12voltman/SimulType/README.md

# SimulType
A collection of keyboard layouts and designs that emphasize data input through two handed use of the number pad with a keyboard or arrow keys
