12voltman/SimulType/Hardware/devtools/simultypecontrol/simultypecontrol.kicad_pcb

## KiCad design Hardware/devtools/simultypecontrol/simultypecontrol.kicad_pcb (2024-07-02)

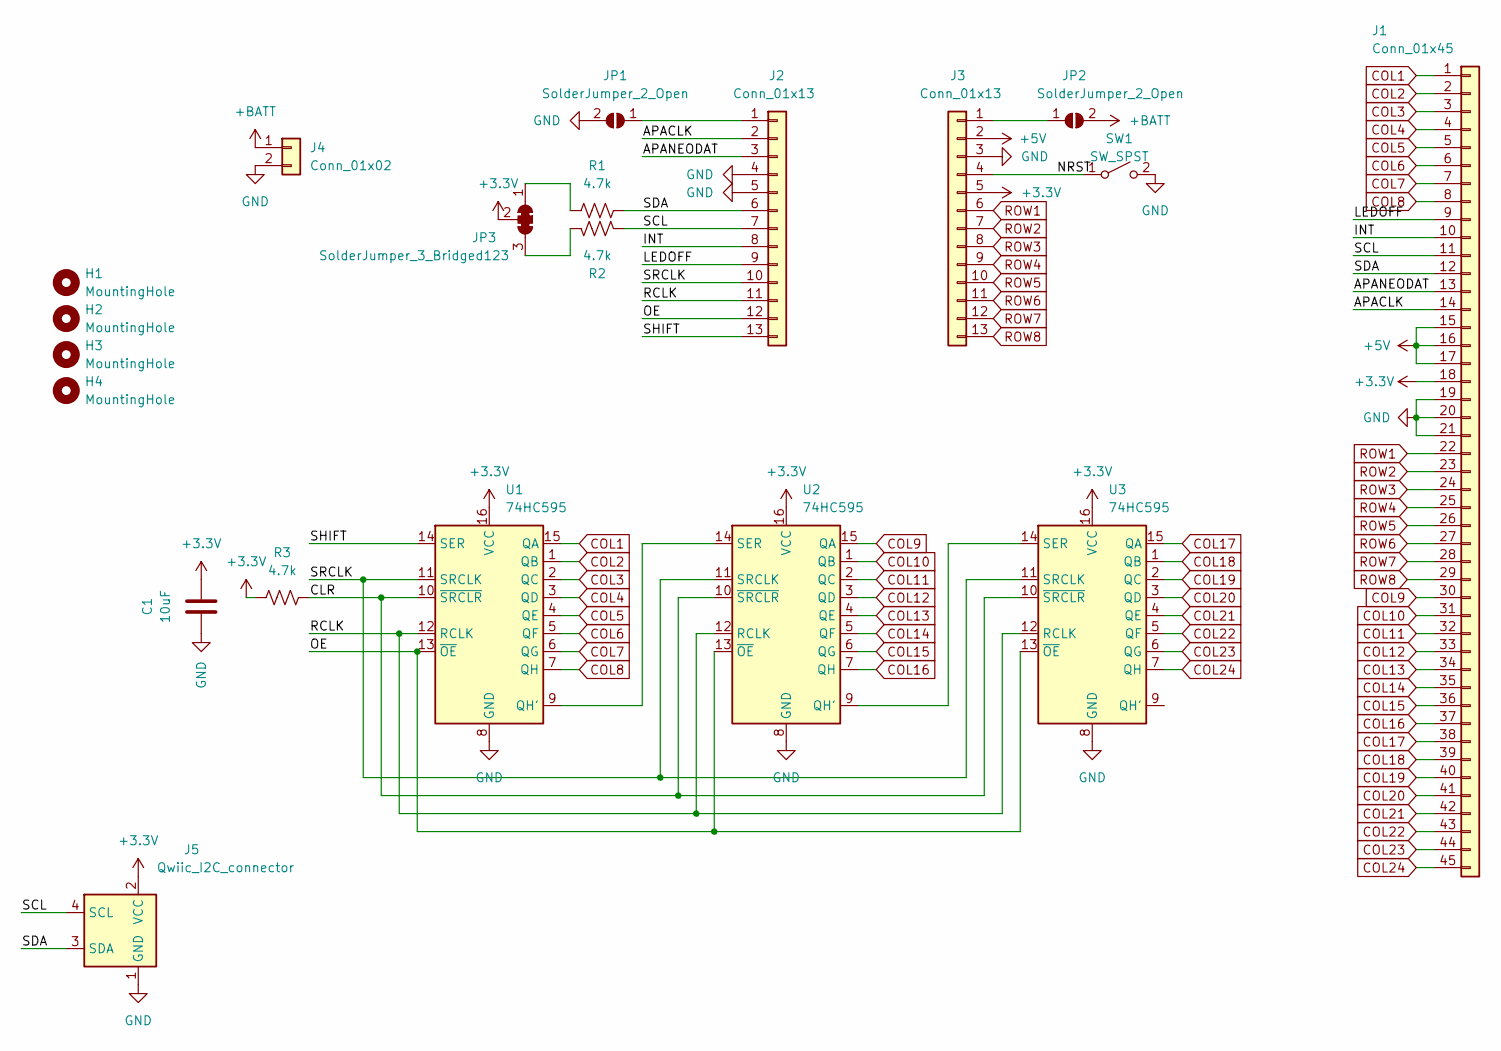
[picture p2: schematic simultypecontrol.kicad_sch]

Parts:
C1: 10uF; C_0805_2012Metric; LCSC C1713
H1, H2, H3, H4: MountingHole; breakoffm3hole
J1: Conn_01x45; TE_4-1734839-5_1x45-1MP_P0.5mm_Horizontal; LCSC C2998867
J2, J3: Conn_01x13; PinHeader_1x13_P2.54mm_Vertical; LCSC C2986992
J4: Conn_01x02; JST_PH_S2B-PH-K_1x02_P2.00mm_Horizontal; LCSC C49992
J5: Qwiic_I2C_connector; JST_SH_SM04B-SRSS-TB_1x04-1MP_P1.00mm_Horizontal; LCSC C7433425
JP1, JP2: SolderJumper_2_Open; SolderJumper-2_P1.3mm_Open_TrianglePad1.0x1.5mm
JP3: SolderJumper_3_Bridged123; SolderJumper-3_P1.3mm_Bridged123_RoundedPad1.0x1.5mm
R1, R2, R3: 4.7k; R_0603_1608Metric; LCSC C25999
SW1: SW_SPST; SW_PUSH_6mm; LCSC C5340136
U1, U2, U3: 74HC595; DHVQFN-16-1EP_2.5x3.5mm_P0.5mm_EP1x2mm; LCSC C730243

Connections:
+3.3V: C1.1, J1.18, J3.5, J5.2 (VCC), JP3.2 (C), R3.1, U1.16 (VCC), U2.16 (VCC), U3.16 (VCC)
+5V: J1.15, J1.16, J1.17, J3.2
+BATT: J4.1, JP2.2 (B)
/APACLK: J1.14, J2.2
/APANEODAT: J1.13, J2.3
/CLR: R3.2, U1.10 (~SRCLR), U2.10 (~SRCLR), U3.10 (~SRCLR)
/INT: J1.10, J2.8
/LEDOFF: J1.9, J2.9
/NRST: J3.4, SW1.1 (A)
/OE: J2.12, U1.13 (~OE), U2.13 (~OE), U3.13 (~OE)
/RCLK: J2.11, U1.12 (RCLK), U2.12 (RCLK), U3.12 (RCLK)
/SCL: J1.11, J2.7, J5.4 (SCL), R2.2
/SDA: J1.12, J2.6, J5.3 (SDA), R1.2
/SHIFT: J2.13, U1.14 (SER)
/SRCLK: J2.10, U1.11 (SRCLK), U2.11 (SRCLK), U3.11 (SRCLK)
COL1: J1.1, U1.15 (QA)
COL2: J1.2, U1.1 (QB)
COL3: J1.3, U1.2 (QC)
COL4: J1.4, U1.3 (QD)
COL5: J1.5, U1.4 (QE)
COL6: J1.6, U1.5 (QF)
COL7: J1.7, U1.6 (QG)
COL8: J1.8, U1.7 (QH)
COL9: J1.30, U2.15 (QA)
COL10: J1.31, U2.1 (QB)
COL11: J1.32, U2.2 (QC)
COL12: J1.33, U2.3 (QD)
COL13: J1.34, U2.4 (QE)
COL14: J1.35, U2.5 (QF)
COL15: J1.36, U2.6 (QG)
COL16: J1.37, U2.7 (QH)
COL17: J1.38, U3.15 (QA)
COL18: J1.39, U3.1 (QB)
COL19: J1.40, U3.2 (QC)
COL20: J1.41, U3.3 (QD)
COL21: J1.42, U3.4 (QE)
COL22: J1.43, U3.5 (QF)
COL23: J1.44, U3.6 (QG)
COL24: J1.45, U3.7 (QH)
GND: C1.2, J1.19, J1.20, J1.21, J2.4, J2.5, J3.3, J4.2, J5.1 (GND), J5.MP (VSS), JP1.2 (B), SW1.2 (B), U1.8 (GND), U2.8 (GND), U3.8 (GND)
unnamed: J2.1, JP1.1 (A)
unnamed: J3.1, JP2.1 (A)
unnamed: JP3.1 (A), R1.1
unnamed: JP3.3 (B), R2.1
unnamed: U1.9 (QH'), U2.14 (SER)
unnamed: U2.9 (QH'), U3.14 (SER)
ROW1: J1.22, J3.6
ROW2: J1.23, J3.7
ROW3: J1.24, J3.8
ROW4: J1.25, J3.9
ROW5: J1.26, J3.10
ROW6: J1.27, J3.11
ROW7: J1.28, J3.12
ROW8: J1.29, J3.13

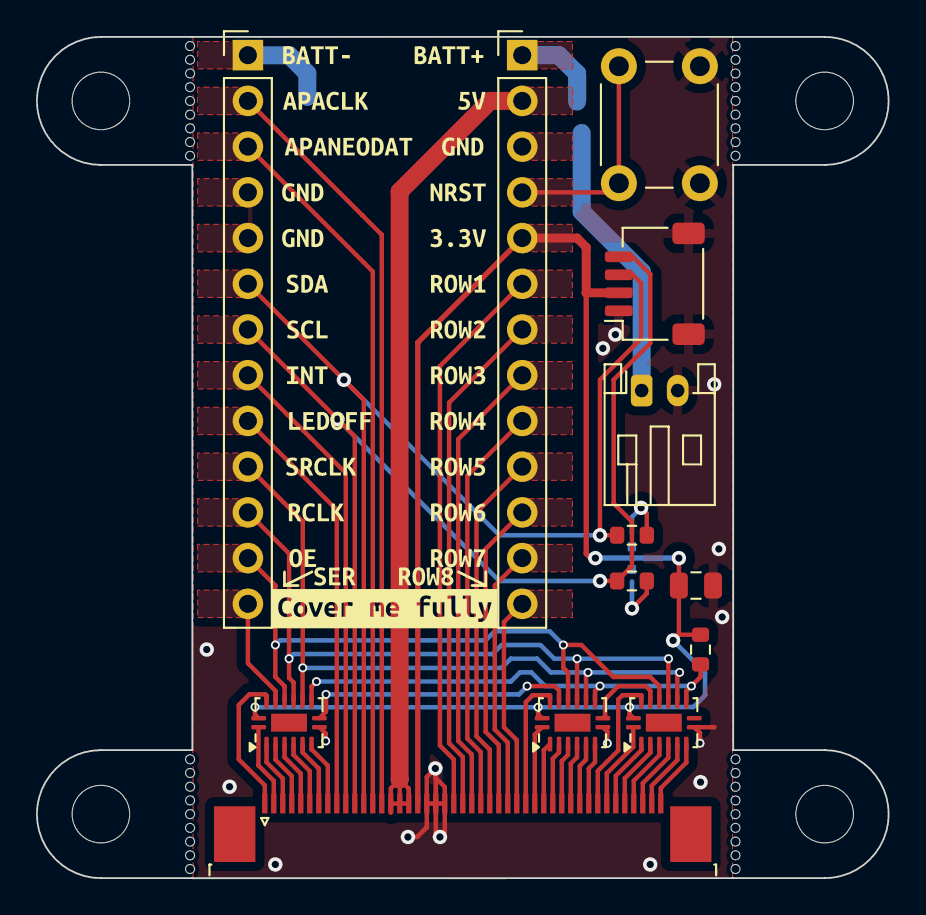
[picture p3: board simultypecontrol.kicad_pcb from above]

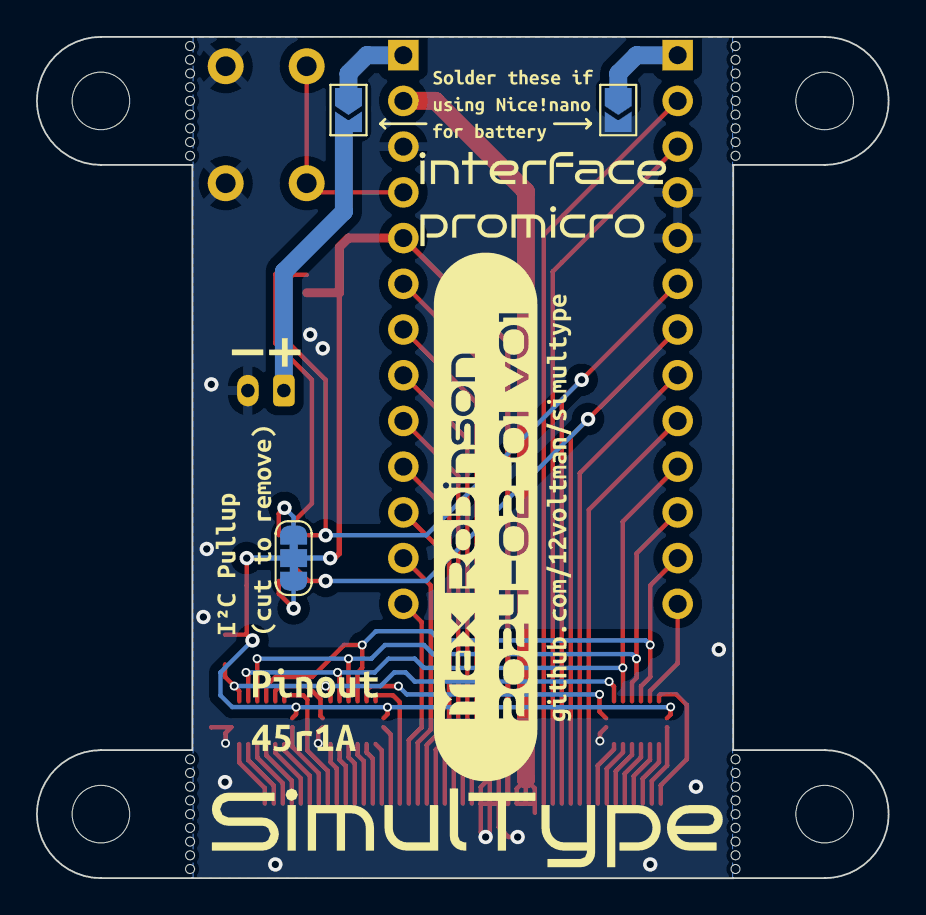
[picture p4: board simultypecontrol.kicad_pcb from below]

Board: 2 copper layers, 47.3 x 46.7 mm, 55 parts (11 on the bottom side), 54 nets.

Other parts of the board:
kibuzzard-65BDD6E5: G***; kibuzzard-65BDD6E5
kibuzzard-65BDD7EC: G***; kibuzzard-65BDD7EC
kibuzzard-65BDD62B: G***; kibuzzard-65BDD62B
kibuzzard-65BDD75E: G***; kibuzzard-65BDD75E
kibuzzard-65BDD614: G***; kibuzzard-65BDD614
kibuzzard-65BDD880: G***; kibuzzard-65BDD880
kibuzzard-65BE09D0: G***; kibuzzard-65BE09D0
kibuzzard-65BE0934: G***; kibuzzard-65BE0934
kibuzzard-65BEF9A5: G***; kibuzzard-65BEF9A5
kibuzzard-65BEF9C3: G***; kibuzzard-65BEF9C3
kibuzzard-65BEF9CF: G***; kibuzzard-65BEF9CF
kibuzzard-65BEF9D6: G***; kibuzzard-65BEF9D6
kibuzzard-65BEF9DC: G***; kibuzzard-65BEF9DC
kibuzzard-65BEF9E1: G***; kibuzzard-65BEF9E1
kibuzzard-65BEF9E8: G***; kibuzzard-65BEF9E8
kibuzzard-65BEF9F0: G***; kibuzzard-65BEF9F0
kibuzzard-65BEF9FD: G***; kibuzzard-65BEF9FD
kibuzzard-65BEF941: G***; kibuzzard-65BEF941
kibuzzard-65BEFA0F: G***; kibuzzard-65BEFA0F
kibuzzard-65BEFA1D: G***; kibuzzard-65BEFA1D
kibuzzard-65BEFA03: G***; kibuzzard-65BEFA03
kibuzzard-65BEFA3D: G***; kibuzzard-65BEFA3D
kibuzzard-65BEFA6D: G***; kibuzzard-65BEFA6D
kibuzzard-65BEFA08: G***; kibuzzard-65BEFA08
kibuzzard-65BEFA17: G***; kibuzzard-65BEFA17
kibuzzard-65BEFA24: G***; kibuzzard-65BEFA24
kibuzzard-65BEFA30: G***; kibuzzard-65BEFA30
kibuzzard-65BEFA36: G***; kibuzzard-65BEFA36
kibuzzard-65BEFA42: G***; kibuzzard-65BEFA42
kibuzzard-65BEFA48: G***; kibuzzard-65BEFA48
kibuzzard-65BEFA57: G***; kibuzzard-65BEFA57
kibuzzard-65BEFA60: G***; kibuzzard-65BEFA60
kibuzzard-65BEFA66: G***; kibuzzard-65BEFA66
kibuzzard-65C29BCC: G***; kibuzzard-65C29BCC
kibuzzard-65C25006: G***; kibuzzard-65C25006
