12voltman/SimulType/Hardware/devtools/simultypeprog/simultypeprog.kicad_pcb

## KiCad design Hardware/devtools/simultypeprog/simultypeprog.kicad_pcb (2024-07-02)

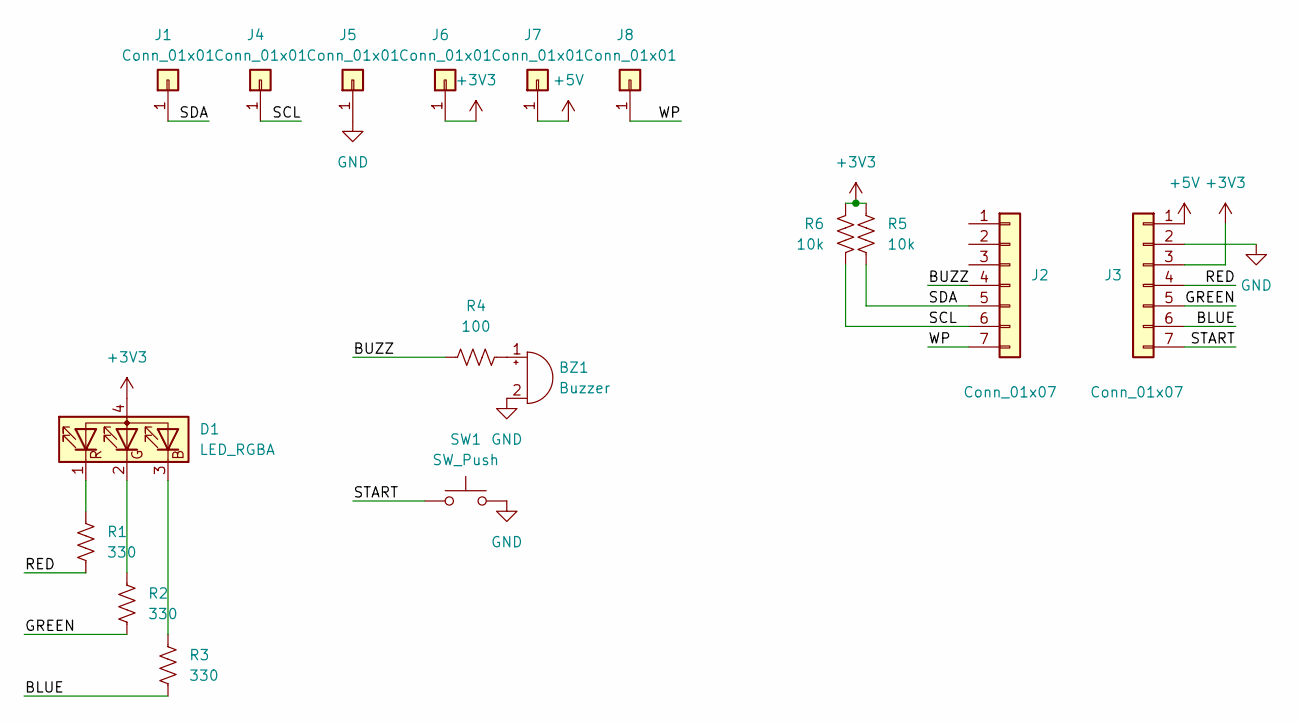
[picture p5: schematic simultypeprog.kicad_sch]

Parts:
BZ1: Buzzer; Buzzer_TDK_PS1240P02BT_D12.2mm_H6.5mm
D1: LED_RGBA; LED_D5.0mm-4_RGB
J1, J4, J5, J6, J7, J8: Conn_01x01; SolderWirePad_1x01_SMD_1x2mm
J2, J3: Conn_01x07; PinHeader_1x07_P2.54mm_Vertical
R1, R2, R3: 330; R_Axial_DIN0207_L6.3mm_D2.5mm_P7.62mm_Horizontal
R4: 100; R_Axial_DIN0207_L6.3mm_D2.5mm_P7.62mm_Horizontal
R5, R6: 10k; R_Axial_DIN0207_L6.3mm_D2.5mm_P7.62mm_Horizontal
SW1: SW_Push; SW_PUSH-12mm

Connections:
+3V3: D1.4 (A), J3.3, J6.1, R5.2, R6.2
+5V: J3.1, J7.1
/BLUE: J3.6, R3.2
/BUZZ: J2.4, R4.1
/GREEN: J3.5, R2.2
/RED: J3.4, R1.2
/SCL: J2.6, J4.1, R6.1
/SDA: J1.1, J2.5, R5.1
/START: J3.7, SW1.1
/WP: J2.7, J8.1
GND: BZ1.2 (-), J3.2, J5.1, SW1.2
unnamed: BZ1.1 (+), R4.2
unnamed: D1.3 (BK), R3.1
unnamed: D1.2 (GK), R2.1
unnamed: D1.1 (RK), R1.1

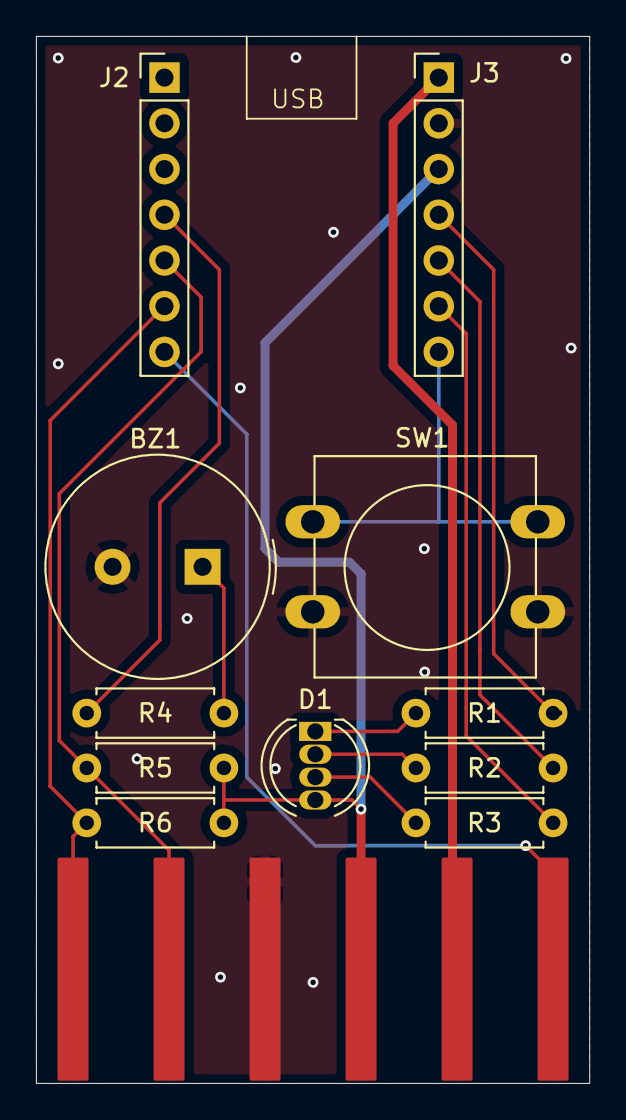
[picture p6: board simultypeprog.kicad_pcb from above]

Board: 2 copper layers, 30.7 x 58.2 mm, 17 parts (0 on the bottom side), 15 nets.
