12voltman/SimulType/Hardware/keymatrixes/analogcluster/SimulTypeUltraSemiMag/SimulTypeUltraSemiMag.kicad_sch

## KiCad design Hardware/keymatrixes/analogcluster/SimulTypeUltraSemiMag/SimulTypeUltraSemiMag.kicad_sch (2024-07-02)

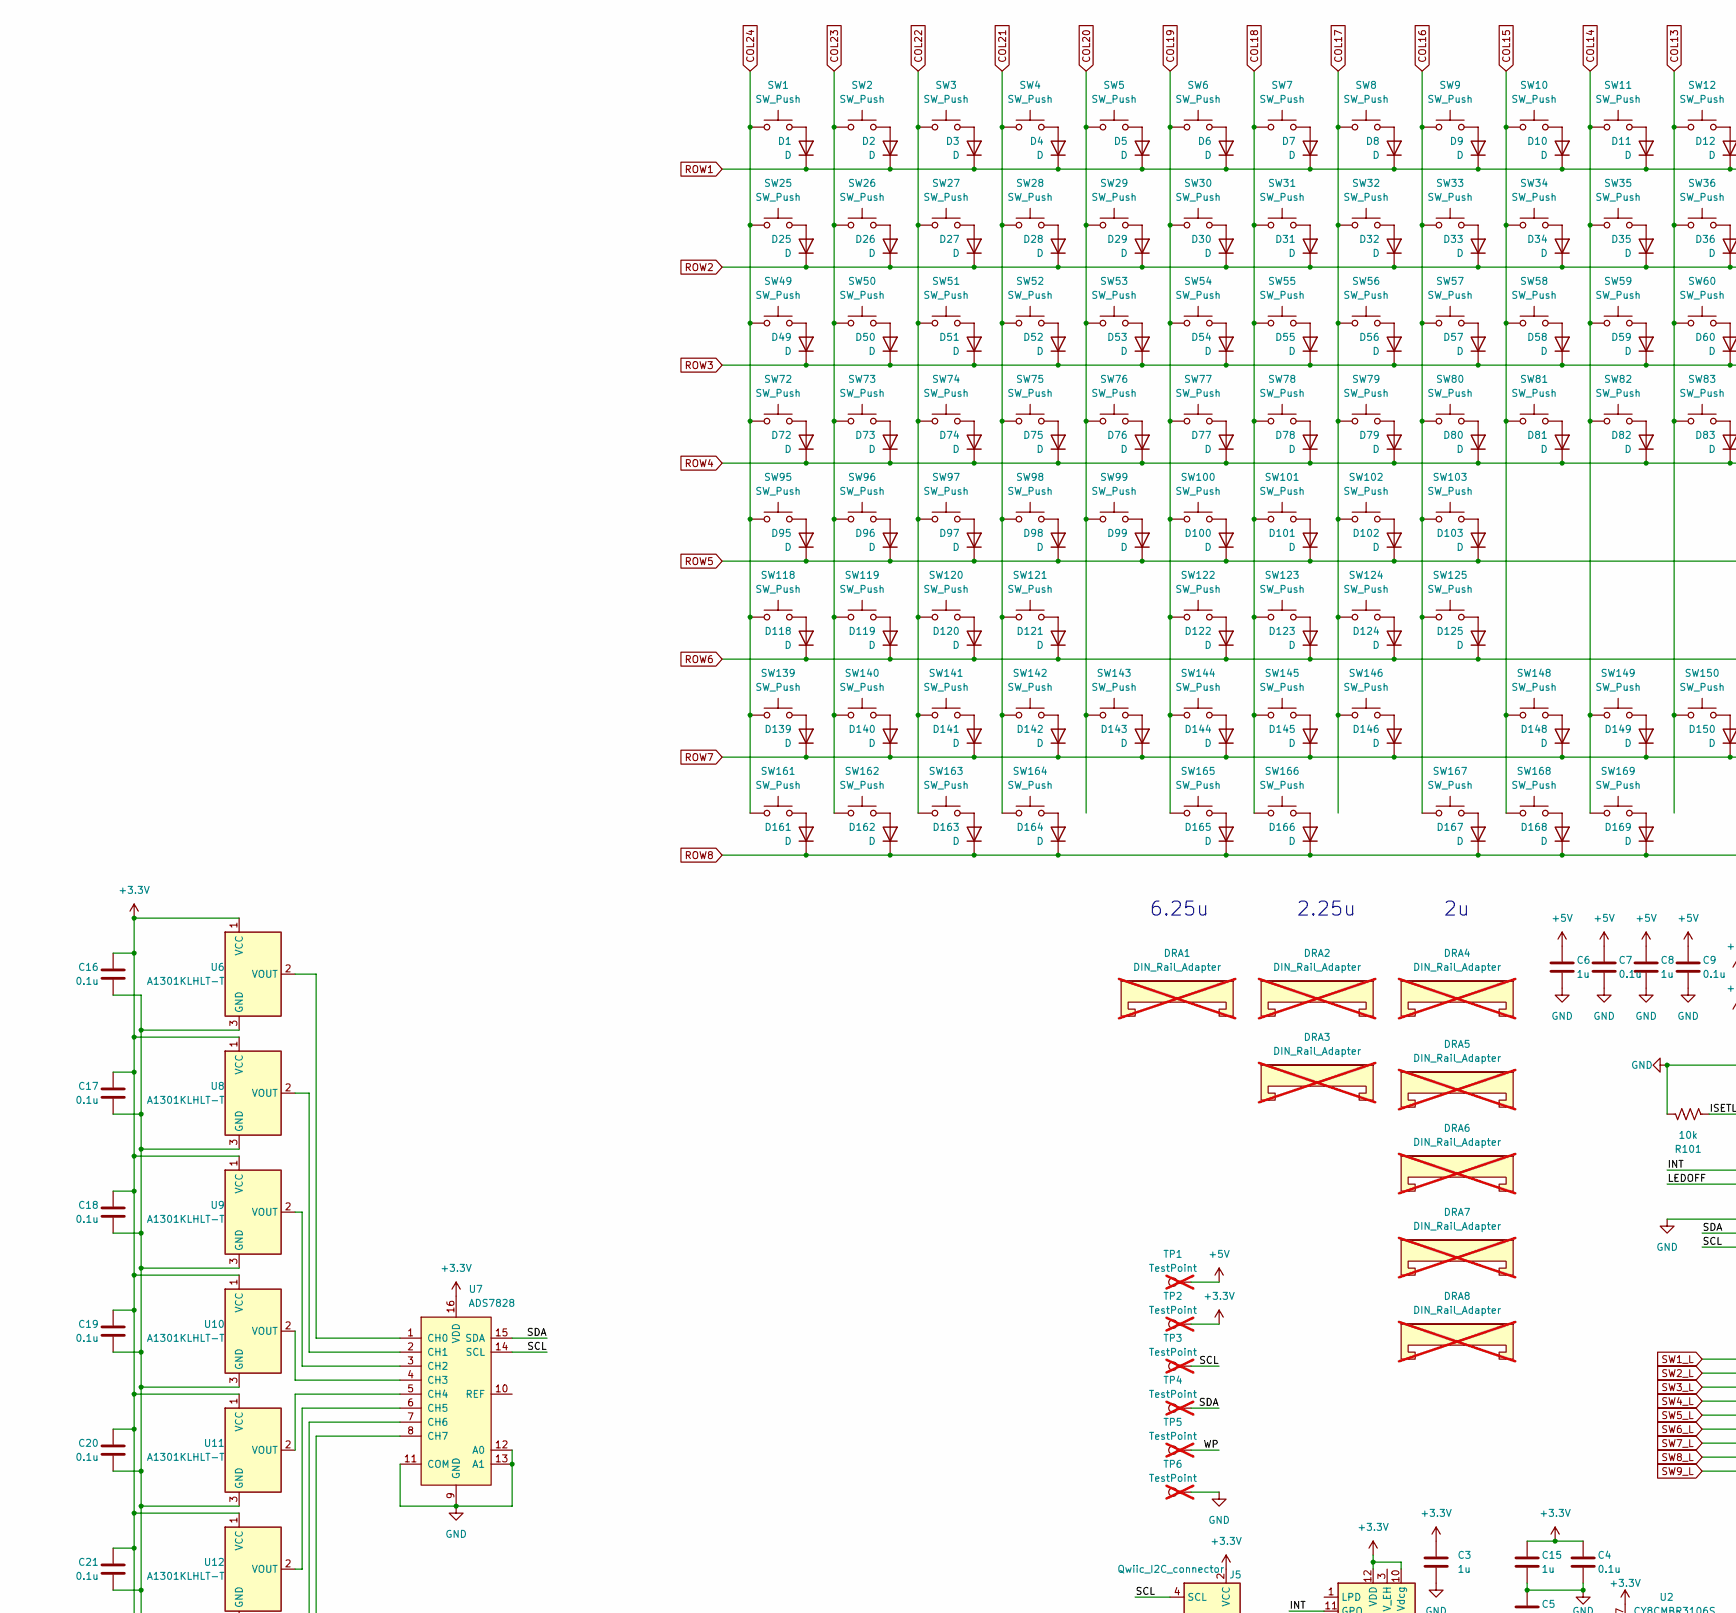
[picture p7: schematic SimulTypeUltraSemiMag.kicad_sch, part in row 1, column 1]

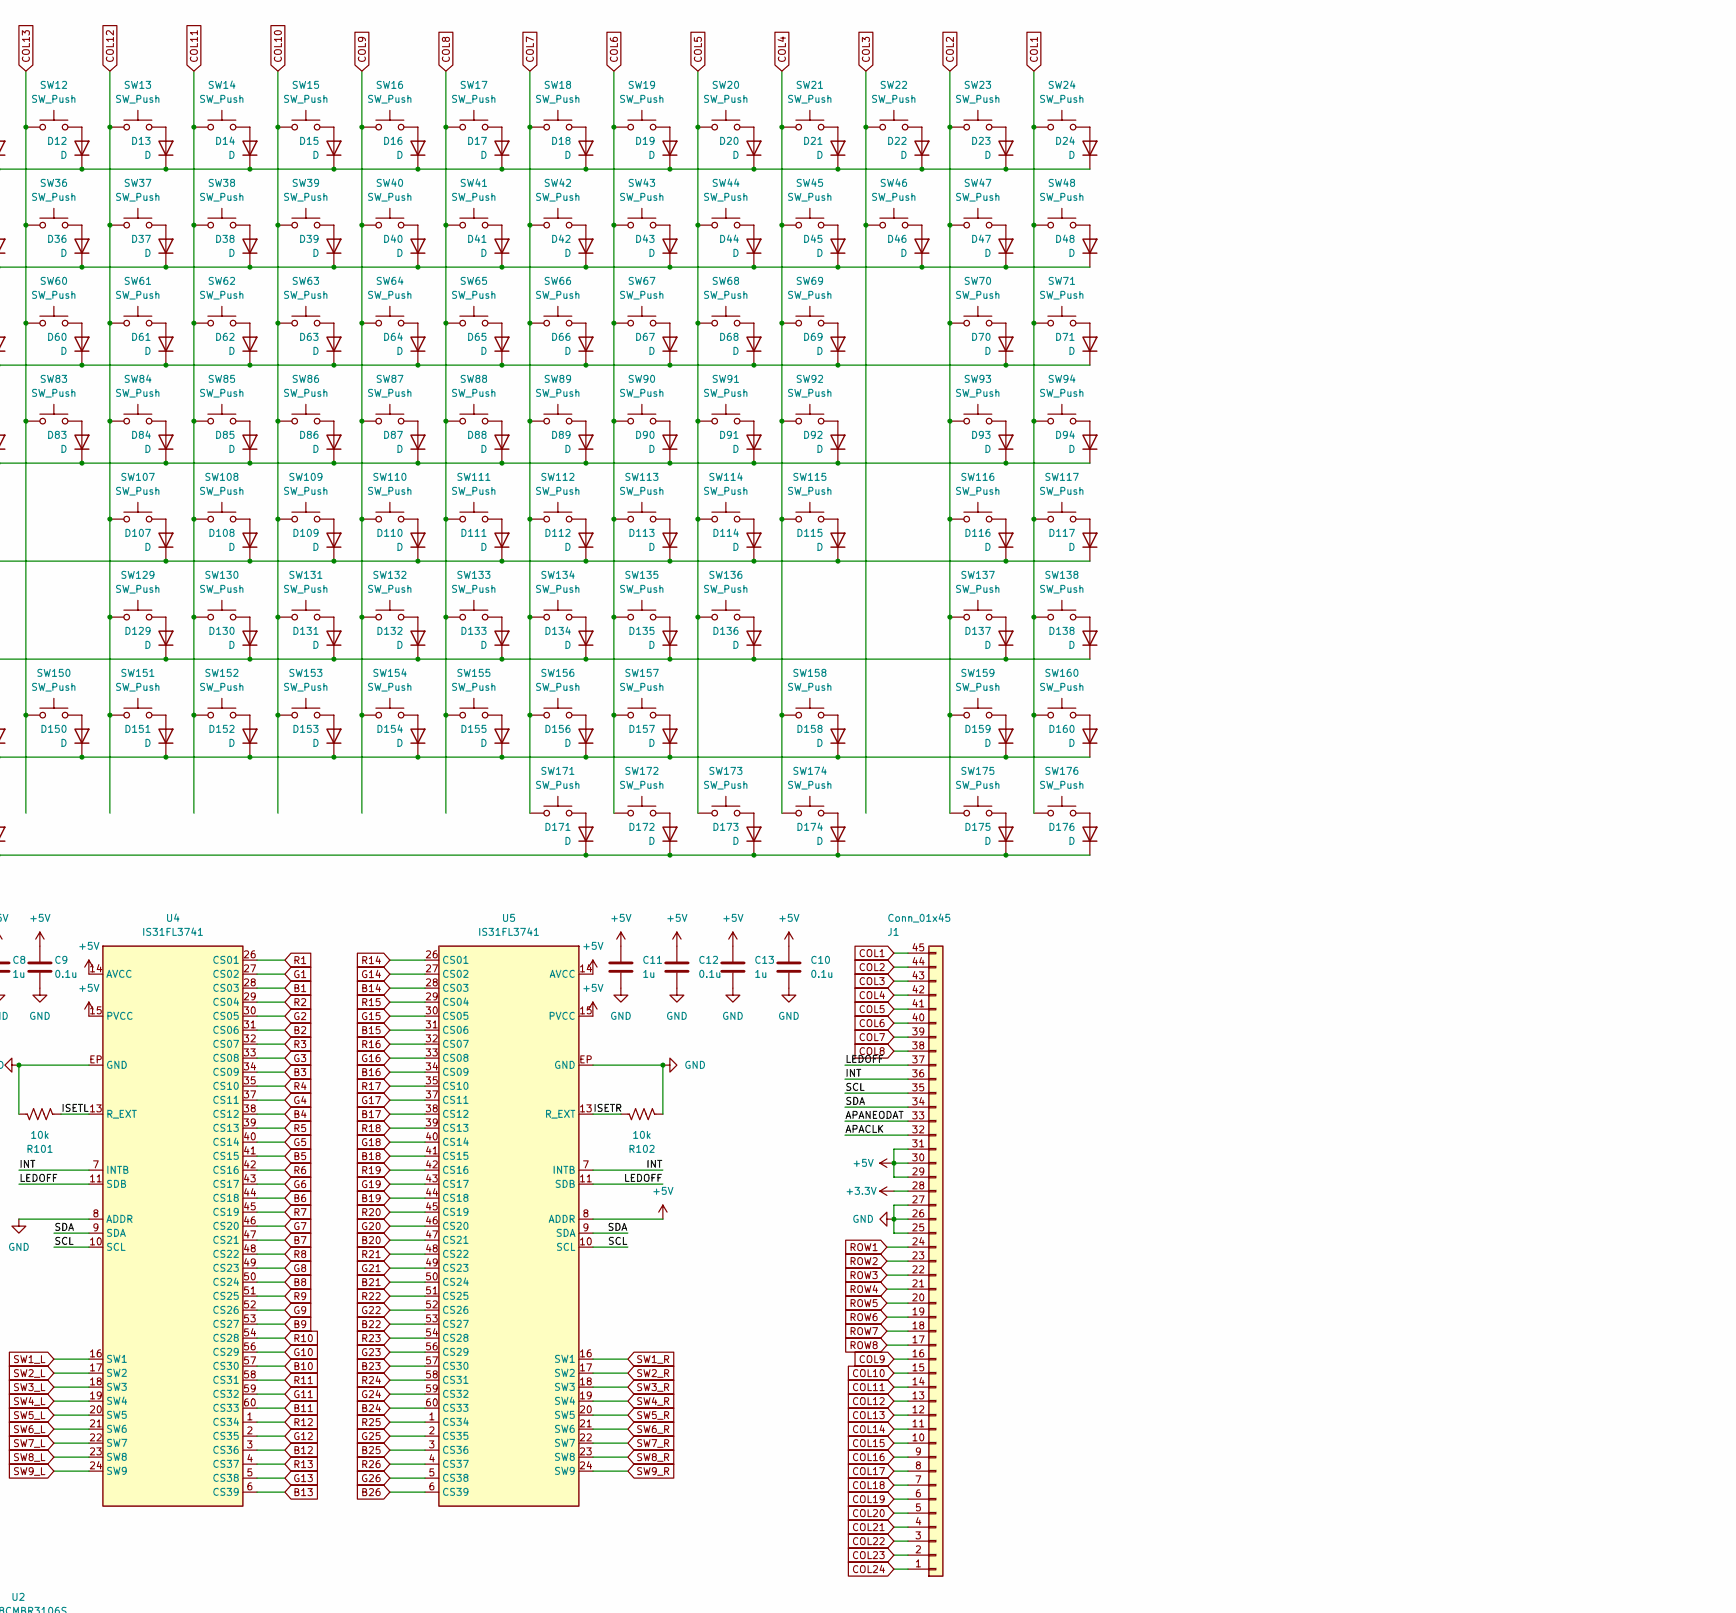
[picture p8: schematic SimulTypeUltraSemiMag.kicad_sch, part in row 1, column 2]

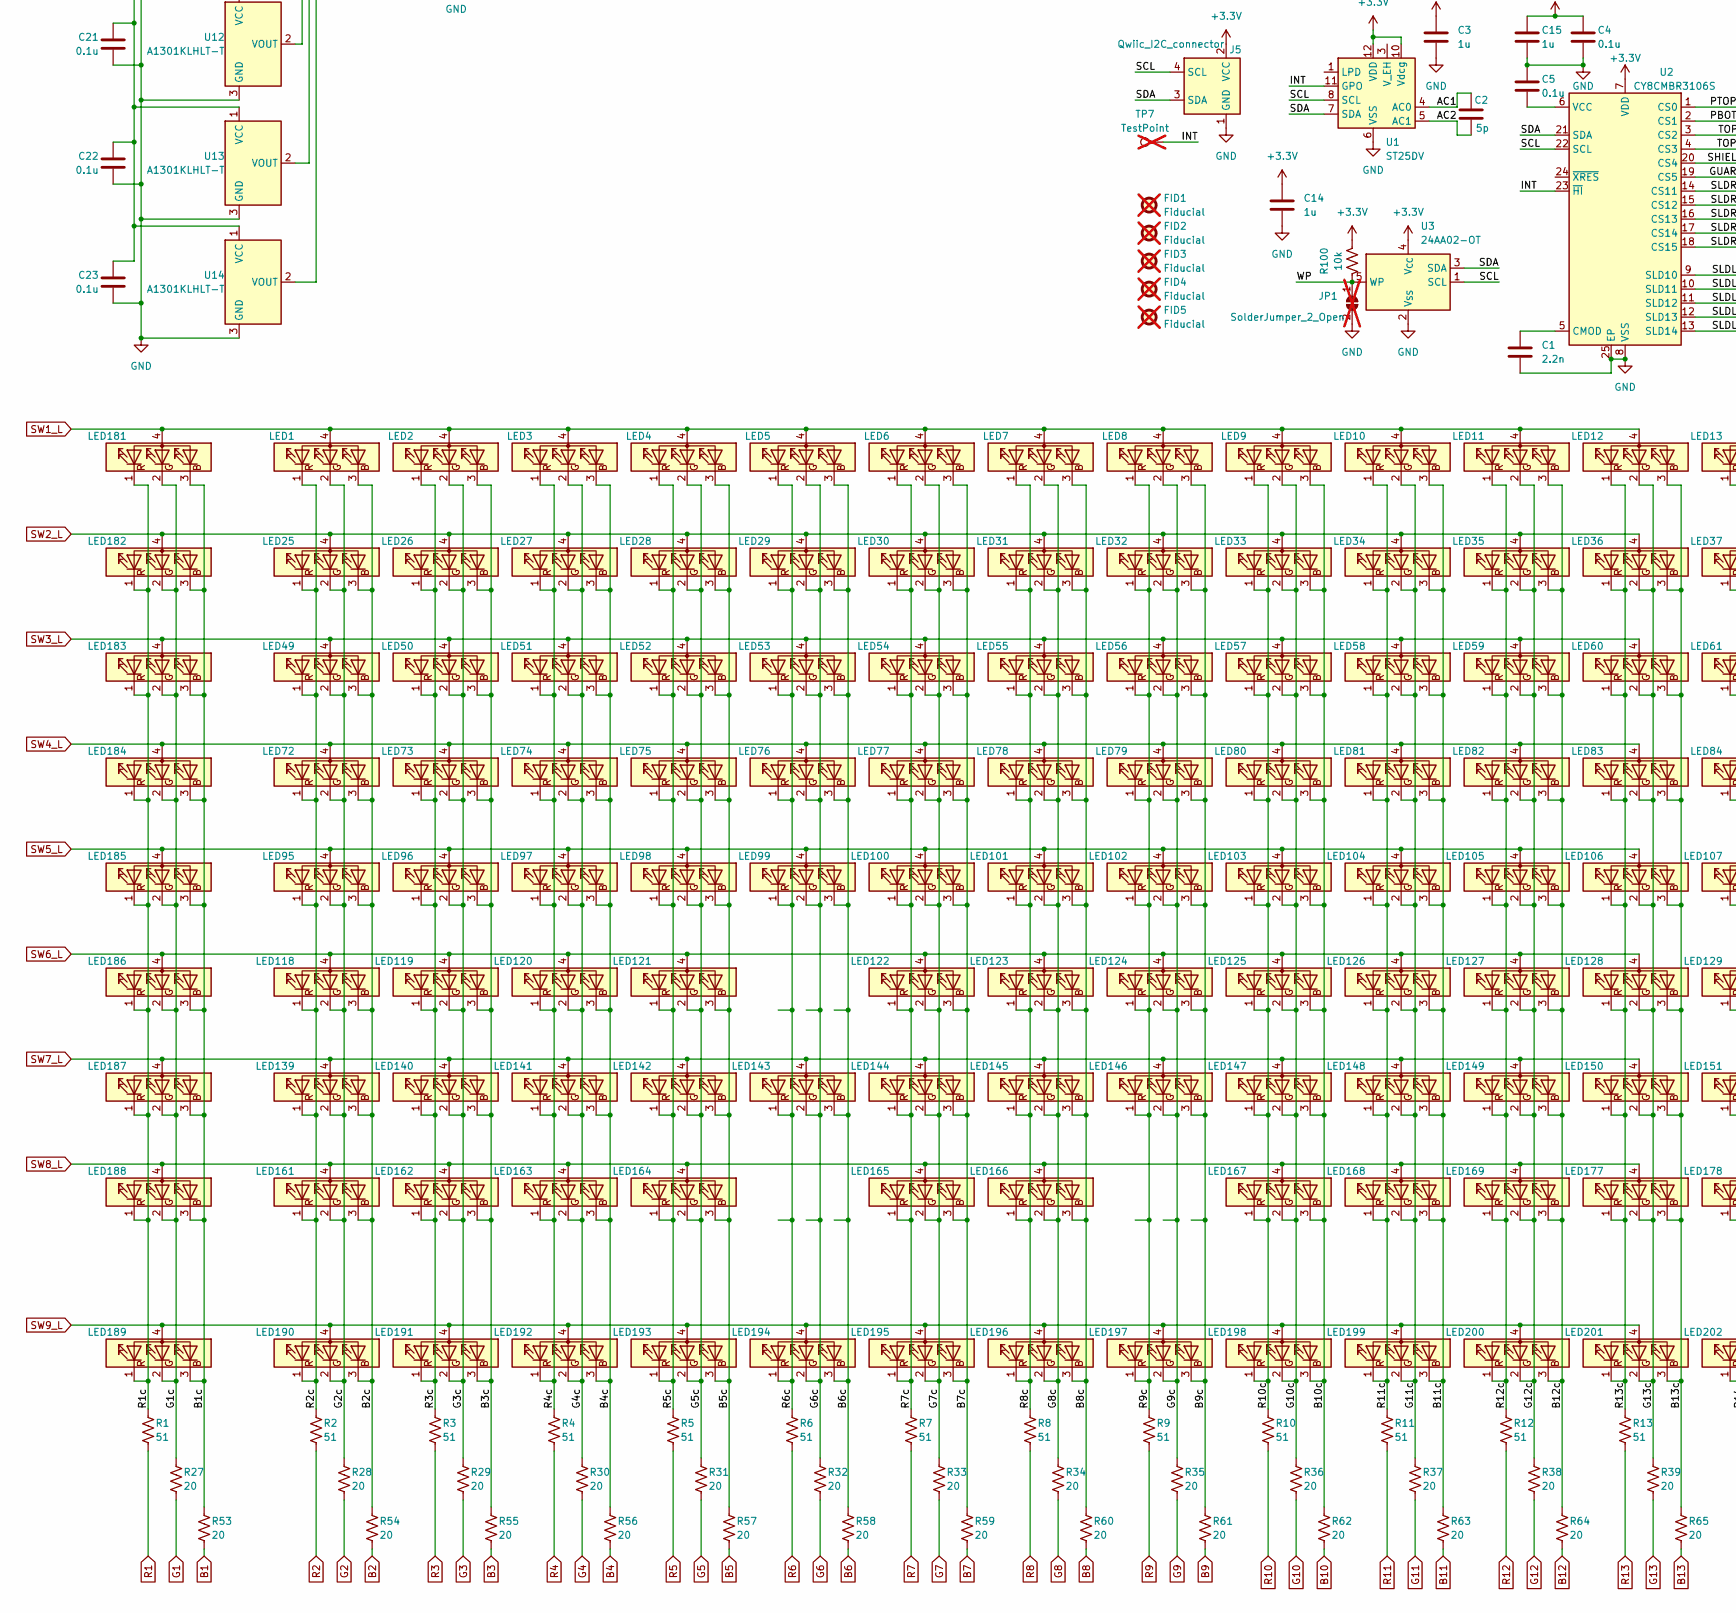
[picture p9: schematic SimulTypeUltraSemiMag.kicad_sch, part in row 2, column 1]

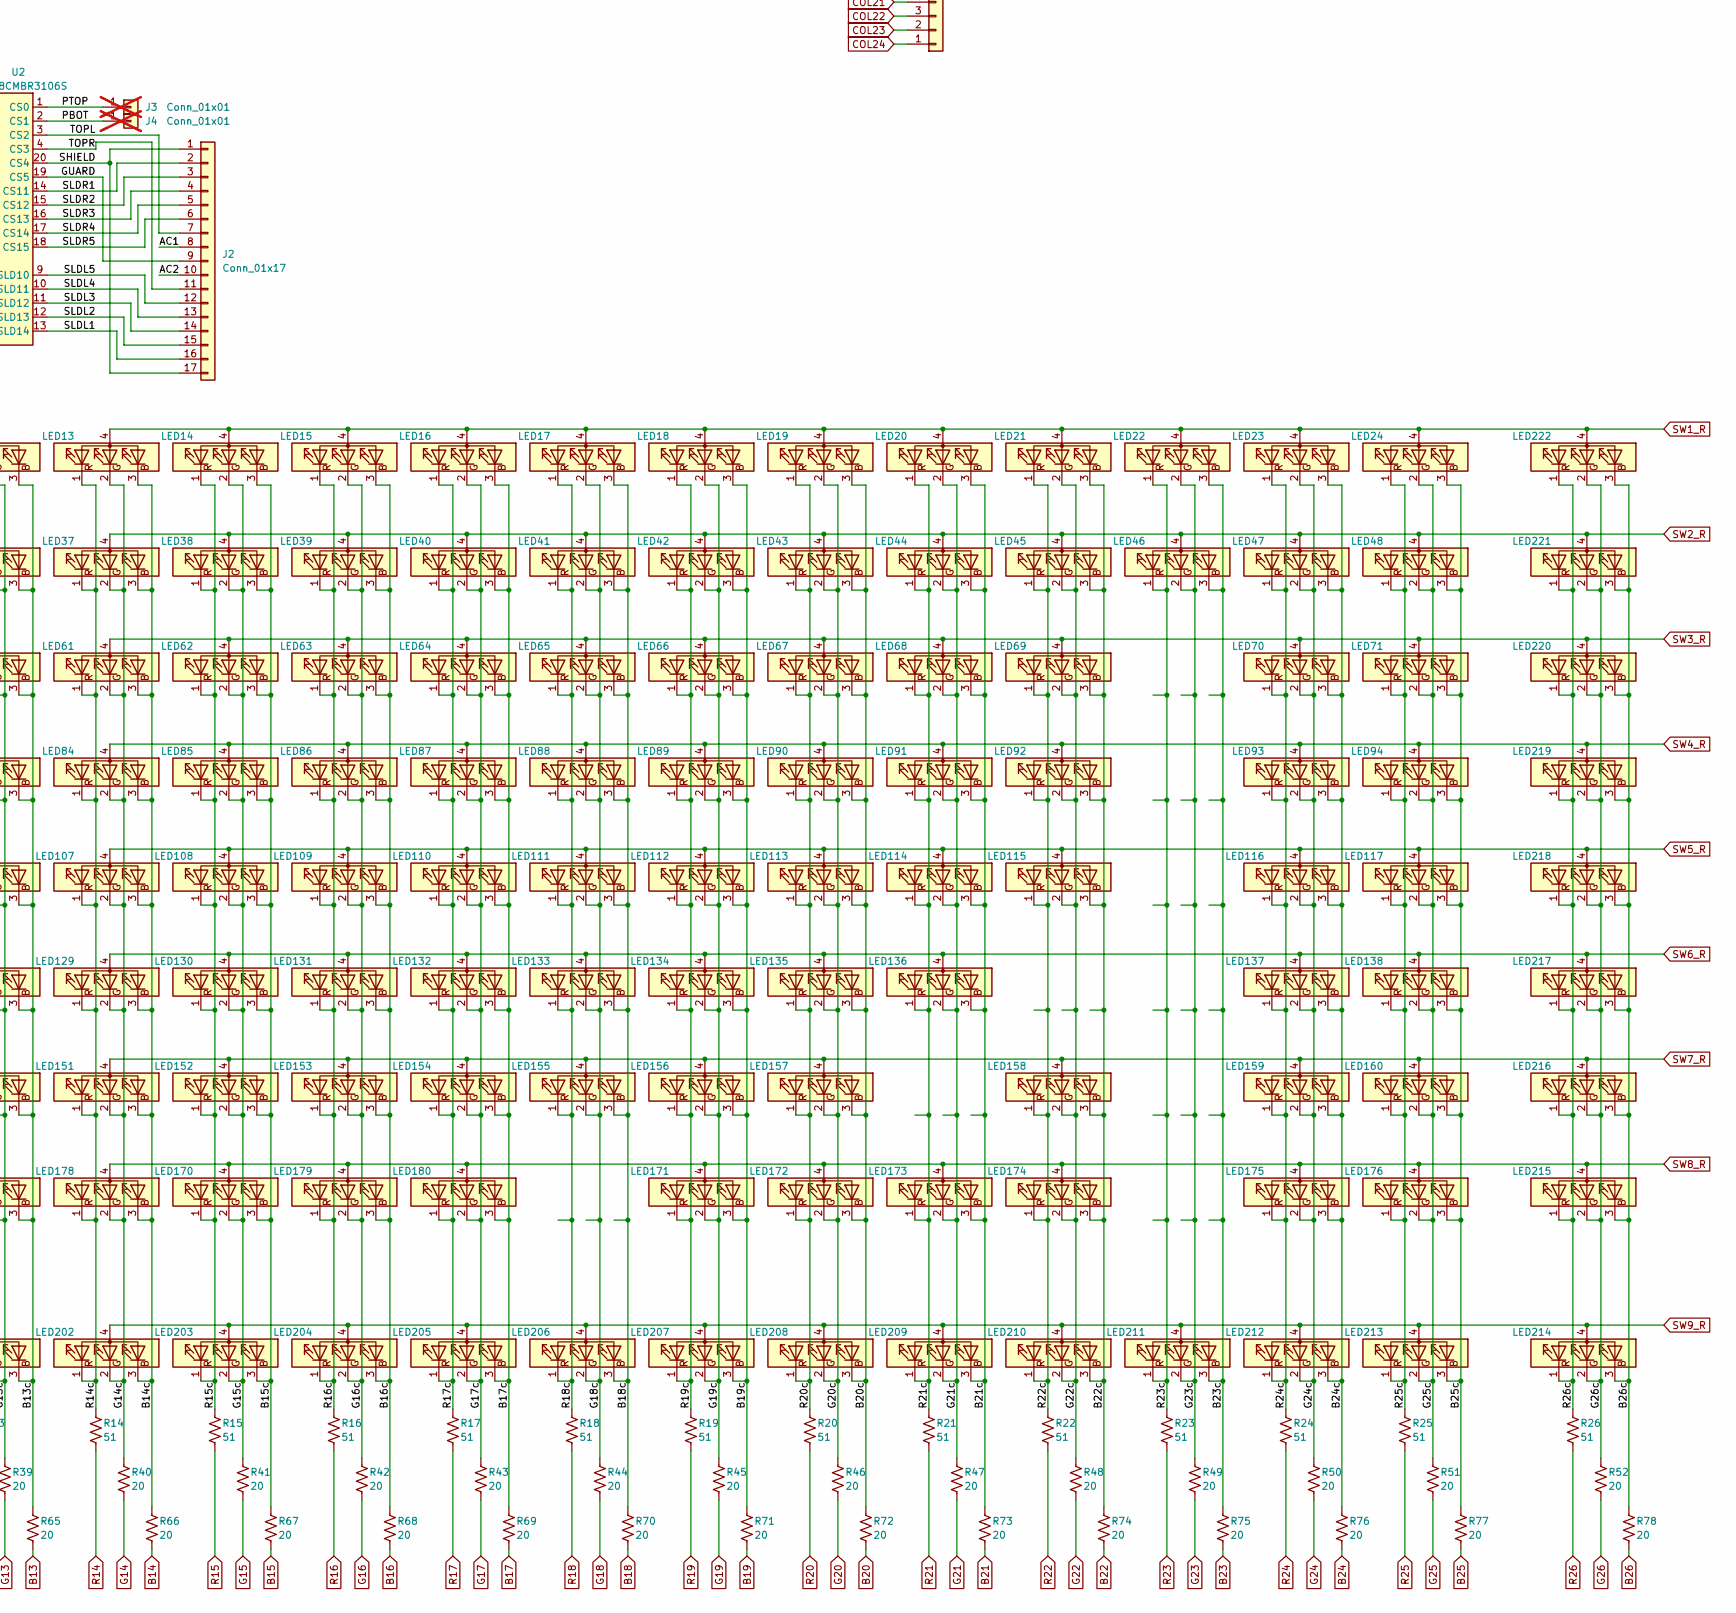
[picture p10: schematic SimulTypeUltraSemiMag.kicad_sch, part in row 2, column 2]

Parts:
C1: 2.2n; C_0603_1608Metric; LCSC C16033
C2: 5p; C_0603_1608Metric; LCSC C1673
C3, C6, C8, C11, C13, C14, C15: 1u; C_0603_1608Metric; LCSC C1592
C4, C5, C7, C9, C10, C12, C16, C17, C18, C19, C20, C21, C22, C23: 0.1u; C_0603_1608Metric; LCSC C1591
D1, D2, D3, D4, D5, D6, D7, D8, D9, D10, D11, D12, D13, D14, D15, D16, D17, D18, D19, D20, D21, D22, D23, D24, D25, D26, D27, D28, D29, D30, D31, D32, D33, D34, D35, D36, D37, D38, D39, D40, D41, D42, D43, D44, D45, D46, D47, D48, D49, D50, D51, D52, D53, D54, D55, D56, D57, D58, D59, D60, D61, D62, D63, D64, D65, D66, D67, D68, D69, D70, D71, D72, D73, D74, D75, D76, D77, D78, D79, D80, D81, D82, D83, D84, D85, D86, D87, D88, D89, D90, D91, D92, D93, D94, D95, D96, D97, D98, D99, D100, D101, D102, D103, D107, D108, D109, D110, D111, D112, D113, D114, D115, D116, D117, D118, D119, D120, D121, D122, D123, D124, D125, D129, D130, D131, D132, D133, D134, D135, D136, D137, D138, D139, D140, D141, D142, D143, D144, D145, D146, D148, D149, D150, D151, D152, D153, D154, D155, D156, D157, D158, D159, D160, D161, D162, D163, D164, D165, D166, D167, D168, D169, D171, D172, D173, D174, D175, D176: D; D_SOD-123F; LCSC C2902912
DRA1: DIN_Rail_Adapter; Stabilizer_Cherry_MX_6.25u; not fitted
DRA2, DRA3, DRA4, DRA5, DRA6, DRA7, DRA8: DIN_Rail_Adapter; Stabilizer_Cherry_MX_2.00u; not fitted
FID1, FID2, FID3, FID4, FID5: Fiducial; Fiducial_1mm_Mask2mm; not fitted
J1: Conn_01x45; TE_4-1734839-5_1x45-1MP_P0.5mm_Horizontal; LCSC C2998867
J2: Conn_01x17; Molex_502250-1791_2Rows-17Pins-1MP_P0.60mm_Horizontal; LCSC C3012329
J3, J4: Conn_01x01; SURFACESPRING_1; LCSC C5143821; not fitted
J5: Qwiic_I2C_connector; JST_SH_SM04B-SRSS-TB_1x04-1MP_P1.00mm_Horizontal; LCSC C7433425
JP1: SolderJumper_2_Open; SolderJumper-2_P1.3mm_Open_RoundedPad1.0x1.5mm; not fitted
LED1, LED2, LED3, LED4, LED5, LED6, LED7, LED8, LED9, LED10, LED11, LED12, LED13, LED14, LED15, LED16, LED17, LED18, LED19, LED20, LED21, LED22, LED23, LED24, LED25, LED26, LED27, LED28, LED29, LED30, LED31, LED32, LED33, LED34, LED35, LED36, LED37, LED38, LED39, LED40, LED41, LED42, LED43, LED44, LED45, LED46, LED47, LED48, LED49, LED50, LED51, LED52, LED53, LED54, LED55, LED56, LED57, LED58, LED59, LED60, LED61, LED62, LED63, LED64, LED65, LED66, LED67, LED68, LED69, LED70, LED71, LED72, LED73, LED74, LED75, LED76, LED77, LED78, LED79, LED80, LED81, LED82, LED83, LED84, LED85, LED86, LED87, LED88, LED89, LED90, LED91, LED92, LED93, LED94, LED95, LED96, LED97, LED98, LED99, LED100, LED101, LED102, LED103, LED104, LED105, LED106, LED107, LED108, LED109, LED110, LED111, LED112, LED113, LED114, LED115, LED116, LED117, LED118, LED119, LED120, LED121, LED122, LED123, LED124, LED125, LED126, LED127, LED128, LED129, LED130, LED131, LED132, LED133, LED134, LED135, LED136, LED137, LED138, LED139, LED140, LED141, LED142, LED143, LED144, LED145, LED146, LED147, LED148, LED149, LED150, LED151, LED152, LED153, LED154, LED155, LED156, LED157, LED158, LED159, LED160, LED161, LED162, LED163, LED164, LED165, LED166, LED167, LED168, LED169, LED170, LED171, LED172, LED173, LED174, LED175, LED176, LED177, LED178, LED179, LED180: ASMB-MTB1-0A3A2; 6028RGB
LED181, LED182, LED183, LED184, LED185, LED186, LED187, LED188, LED189, LED190, LED191, LED192, LED193, LED194, LED195, LED196, LED197, LED198, LED199, LED200, LED201, LED202, LED203, LED204, LED205, LED206, LED207, LED208, LED209, LED210, LED211, LED212, LED213, LED214, LED215, LED216, LED217, LED218, LED219, LED220, LED221, LED222: ASMB-MTB1-0A3A2; RGBSIDELENS; LCSC C965884
R1, R2, R3, R4, R5, R6, R7, R8, R9, R10, R11, R12, R13, R14, R15, R16, R17, R18, R19, R20, R21, R22, R23, R24, R25, R26: 51; R_0402_1005Metric; LCSC C25125
R27, R28, R29, R30, R31, R32, R33, R34, R35, R36, R37, R38, R39, R40, R41, R42, R43, R44, R45, R46, R47, R48, R49, R50, R51, R52, R53, R54, R55, R56, R57, R58, R59, R60, R61, R62, R63, R64, R65, R66, R67, R68, R69, R70, R71, R72, R73, R74, R75, R76, R77, R78: 20; R_0402_1005Metric; LCSC C25089
R100, R101, R102: 10k; R_0402_1005Metric; LCSC C25744
SW1, SW2, SW3, SW4, SW5, SW6, SW7, SW8, SW9, SW10, SW11, SW12, SW13, SW14, SW15, SW16, SW17, SW18, SW19, SW20, SW21, SW22, SW23, SW24, SW25, SW26, SW27, SW28, SW29, SW30, SW31, SW32, SW33, SW34, SW35, SW36, SW37, SW38, SW39, SW40, SW41, SW42, SW43, SW44, SW45, SW46, SW47, SW48, SW49, SW50, SW51, SW52, SW53, SW54, SW55, SW56, SW57, SW58, SW59, SW60, SW61, SW62, SW63, SW64, SW65, SW66, SW67, SW68, SW69, SW70, SW71, SW72, SW73, SW74, SW75, SW76, SW77, SW78, SW79, SW80, SW81, SW82, SW83, SW84, SW85, SW86, SW87, SW88, SW89, SW90, SW91, SW92, SW93, SW94, SW95, SW96, SW97, SW98, SW99, SW100, SW101, SW102, SW103, SW107, SW108, SW109, SW110, SW111, SW112, SW113, SW114, SW115, SW116, SW117, SW118, SW119, SW120, SW121, SW122, SW123, SW124, SW125, SW129, SW130, SW131, SW132, SW133, SW134, SW135, SW136, SW137, SW138, SW139, SW140, SW141, SW142, SW143, SW144, SW145, SW146, SW148, SW149, SW150, SW151, SW152, SW153, SW154, SW155, SW156, SW157, SW158, SW159, SW160, SW161, SW162, SW163, SW164, SW165, SW166, SW167, SW168, SW169, SW171, SW172, SW173, SW174, SW175, SW176: SW_Push; SW_Hotswap_Kailh_MX_Plated_1.00uNOSILKTOP; LCSC C5184526
TP1, TP2, TP3, TP4, TP5, TP6: TestPoint; TestPoint_Pad_D4.0mm; not fitted
TP7: TestPoint; TestPoint_Pad_2.0x2.0mm; not fitted
U1: ST25DV; DFN-12-1EP_3x3mm_P0.5mm_EP1.4x2.55mm; LCSC C2654815
U2: CY8CMBR3106S; QFN-24-1EP_4x4mm_P0.5mm_EP2.6x2.6mm; LCSC C2952476
U3: 24AA02-OT; SOT-23-5; LCSC C5263778
U4, U5: IS31FL3741; QFN-60-1EP_7x7mm_P0.4mm_EP5x5mm; LCSC C2940604
U6, U8, U9, U10, U11, U12, U13, U14: A1301KLHLT-T; SW_GATERON_MAG_ANALOG_1.00u
U7: ADS7828; TSSOP-16_4.4x5mm_P0.65mm

Connections:
+3.3V: C3.1, C4.1, C14.1, C15.1, C16.1, C17.1, C18.1, C19.1, C20.1, C21.1, C22.1, C23.1, J1.28, J5.2 (VCC), R100.1, TP2.1, U1.10 (Vdcg), U1.12 (VDD), U2.7 (VDD), U3.4 (V_{CC}), U6.1 (VCC), U7.16 (VDD), U8.1 (VCC), U9.1 (VCC), U10.1 (VCC), U11.1 (VCC), U12.1 (VCC), U13.1 (VCC), U14.1 (VCC)
+5V: C6.1, C7.1, C8.1, C9.1, C10.1, C11.1, C12.1, C13.1, J1.29, J1.30, J1.31, TP1.1, U4.14 (AVCC), U4.15 (PVCC), U4.25 (PVCC), U5.8 (ADDR), U5.14 (AVCC), U5.15 (PVCC), U5.25 (PVCC)
AC1: C2.1, J2.8, U1.4 (AC0)
AC2: C2.2, J2.10, U1.5 (AC1)
APACLK: J1.32
APANEODAT: J1.33
B1: R53.2, U4.28 (CS03)
B1c: LED181.3 (BK), LED182.3 (BK), LED183.3 (BK), LED184.3 (BK), LED185.3 (BK), LED186.3 (BK), LED187.3 (BK), LED188.3 (BK), LED189.3 (BK), R53.1
B2: R54.2, U4.31 (CS06)
B2c: LED1.3 (BK), LED25.3 (BK), LED49.3 (BK), LED72.3 (BK), LED95.3 (BK), LED118.3 (BK), LED139.3 (BK), LED161.3 (BK), LED190.3 (BK), R54.1
B3: R55.2, U4.34 (CS09)
B3c: LED2.3 (BK), LED26.3 (BK), LED50.3 (BK), LED73.3 (BK), LED96.3 (BK), LED119.3 (BK), LED140.3 (BK), LED162.3 (BK), LED191.3 (BK), R55.1
B4: R56.2, U4.38 (CS12)
B4c: LED3.3 (BK), LED27.3 (BK), LED51.3 (BK), LED74.3 (BK), LED97.3 (BK), LED120.3 (BK), LED141.3 (BK), LED163.3 (BK), LED192.3 (BK), R56.1
B5: R57.2, U4.41 (CS15)
B5c: LED4.3 (BK), LED28.3 (BK), LED52.3 (BK), LED75.3 (BK), LED98.3 (BK), LED121.3 (BK), LED142.3 (BK), LED164.3 (BK), LED193.3 (BK), R57.1
B6: R58.2, U4.44 (CS18)
B6c: LED5.3 (BK), LED29.3 (BK), LED53.3 (BK), LED76.3 (BK), LED99.3 (BK), LED143.3 (BK), LED194.3 (BK), R58.1
B7: R59.2, U4.47 (CS21)
B7c: LED6.3 (BK), LED30.3 (BK), LED54.3 (BK), LED77.3 (BK), LED100.3 (BK), LED122.3 (BK), LED144.3 (BK), LED165.3 (BK), LED195.3 (BK), R59.1
B8: R60.2, U4.50 (CS24)
B8c: LED7.3 (BK), LED31.3 (BK), LED55.3 (BK), LED78.3 (BK), LED101.3 (BK), LED123.3 (BK), LED145.3 (BK), LED166.3 (BK), LED196.3 (BK), R60.1
B9: R61.2, U4.53 (CS27)
B9c: LED8.3 (BK), LED32.3 (BK), LED56.3 (BK), LED79.3 (BK), LED102.3 (BK), LED124.3 (BK), LED146.3 (BK), LED197.3 (BK), R61.1
B10: R62.2, U4.57 (CS30)
B10c: LED9.3 (BK), LED33.3 (BK), LED57.3 (BK), LED80.3 (BK), LED103.3 (BK), LED125.3 (BK), LED147.3 (BK), LED167.3 (BK), LED198.3 (BK), R62.1
B11: R63.2, U4.60 (CS33)
B11c: LED10.3 (BK), LED34.3 (BK), LED58.3 (BK), LED81.3 (BK), LED104.3 (BK), LED126.3 (BK), LED148.3 (BK), LED168.3 (BK), LED199.3 (BK), R63.1
B12: R64.2, U4.3 (CS36)
B12c: LED11.3 (BK), LED35.3 (BK), LED59.3 (BK), LED82.3 (BK), LED105.3 (BK), LED127.3 (BK), LED149.3 (BK), LED169.3 (BK), LED200.3 (BK), R64.1
B13: R65.2, U4.6 (CS39)
B13c: LED12.3 (BK), LED36.3 (BK), LED60.3 (BK), LED83.3 (BK), LED106.3 (BK), LED128.3 (BK), LED150.3 (BK), LED177.3 (BK), LED201.3 (BK), R65.1
B14: R66.2, U5.28 (CS03)
B14c: LED13.3 (BK), LED37.3 (BK), LED61.3 (BK), LED84.3 (BK), LED107.3 (BK), LED129.3 (BK), LED151.3 (BK), LED178.3 (BK), LED202.3 (BK), R66.1
B15: R67.2, U5.31 (CS06)
B15c: LED14.3 (BK), LED38.3 (BK), LED62.3 (BK), LED85.3 (BK), LED108.3 (BK), LED130.3 (BK), LED152.3 (BK), LED170.3 (BK), LED203.3 (BK), R67.1
B16: R68.2, U5.34 (CS09)
B16c: LED15.3 (BK), LED39.3 (BK), LED63.3 (BK), LED86.3 (BK), LED109.3 (BK), LED131.3 (BK), LED153.3 (BK), LED179.3 (BK), LED204.3 (BK), R68.1
B17: R69.2, U5.38 (CS12)
B17c: LED16.3 (BK), LED40.3 (BK), LED64.3 (BK), LED87.3 (BK), LED110.3 (BK), LED132.3 (BK), LED154.3 (BK), LED180.3 (BK), LED205.3 (BK), R69.1
B18: R70.2, U5.41 (CS15)
B18c: LED17.3 (BK), LED41.3 (BK), LED65.3 (BK), LED88.3 (BK), LED111.3 (BK), LED133.3 (BK), LED155.3 (BK), LED206.3 (BK), R70.1
B19: R71.2, U5.44 (CS18)
B19c: LED18.3 (BK), LED42.3 (BK), LED66.3 (BK), LED89.3 (BK), LED112.3 (BK), LED134.3 (BK), LED156.3 (BK), LED171.3 (BK), LED207.3 (BK), R71.1
B20: R72.2, U5.47 (CS21)
B20c: LED19.3 (BK), LED43.3 (BK), LED67.3 (BK), LED90.3 (BK), LED113.3 (BK), LED135.3 (BK), LED157.3 (BK), LED172.3 (BK), LED208.3 (BK), R72.1
B21: R73.2, U5.50 (CS24)
B21c: LED20.3 (BK), LED44.3 (BK), LED68.3 (BK), LED91.3 (BK), LED114.3 (BK), LED136.3 (BK), LED173.3 (BK), LED209.3 (BK), R73.1
B22: R74.2, U5.53 (CS27)
B22c: LED21.3 (BK), LED45.3 (BK), LED69.3 (BK), LED92.3 (BK), LED115.3 (BK), LED158.3 (BK), LED174.3 (BK), LED210.3 (BK), R74.1
B23: R75.2, U5.57 (CS30)
B23c: LED22.3 (BK), LED46.3 (BK), LED211.3 (BK), R75.1
B24: R76.2, U5.60 (CS33)
B24c: LED23.3 (BK), LED47.3 (BK), LED70.3 (BK), LED93.3 (BK), LED116.3 (BK), LED137.3 (BK), LED159.3 (BK), LED175.3 (BK), LED212.3 (BK), R76.1
B25: R77.2, U5.3 (CS36)
B25c: LED24.3 (BK), LED48.3 (BK), LED71.3 (BK), LED94.3 (BK), LED117.3 (BK), LED138.3 (BK), LED160.3 (BK), LED176.3 (BK), LED213.3 (BK), R77.1
B26: R78.2, U5.6 (CS39)
B26c: LED214.3 (BK), LED215.3 (BK), LED216.3 (BK), LED217.3 (BK), LED218.3 (BK), LED219.3 (BK), LED220.3 (BK), LED221.3 (BK), LED222.3 (BK), R78.1
COL1: J1.45, SW24.1, SW48.1, SW71.1, SW94.1, SW117.1, SW138.1, SW160.1, SW176.1
COL2: J1.44, SW23.1, SW47.1, SW70.1, SW93.1, SW116.1, SW137.1, SW159.1, SW175.1
COL3: J1.43, SW22.1, SW46.1
COL4: J1.42, SW21.1, SW45.1, SW69.1, SW92.1, SW115.1, SW158.1, SW174.1
COL5: J1.41, SW20.1, SW44.1, SW68.1, SW91.1, SW114.1, SW136.1, SW173.1
COL6: J1.40, SW19.1, SW43.1, SW67.1, SW90.1, SW113.1, SW135.1, SW157.1, SW172.1
COL7: J1.39, SW18.1, SW42.1, SW66.1, SW89.1, SW112.1, SW134.1, SW156.1, SW171.1
COL8: J1.38, SW17.1, SW41.1, SW65.1, SW88.1, SW111.1, SW133.1, SW155.1
COL9: J1.16, SW16.1, SW40.1, SW64.1, SW87.1, SW110.1, SW132.1, SW154.1
COL10: J1.15, SW15.1, SW39.1, SW63.1, SW86.1, SW109.1, SW131.1, SW153.1
COL11: J1.14, SW14.1, SW38.1, SW62.1, SW85.1, SW108.1, SW130.1, SW152.1
COL12: J1.13, SW13.1, SW37.1, SW61.1, SW84.1, SW107.1, SW129.1, SW151.1
COL13: J1.12, SW12.1, SW36.1, SW60.1, SW83.1, SW150.1
COL14: J1.11, SW11.1, SW35.1, SW59.1, SW82.1, SW149.1, SW169.1
COL15: J1.10, SW10.1, SW34.1, SW58.1, SW81.1, SW148.1, SW168.1
COL16: J1.9, SW9.1, SW33.1, SW57.1, SW80.1, SW103.1, SW125.1, SW167.1
COL17: J1.8, SW8.1, SW32.1, SW56.1, SW79.1, SW102.1, SW124.1, SW146.1
COL18: J1.7, SW7.1, SW31.1, SW55.1, SW78.1, SW101.1, SW123.1, SW145.1, SW166.1
COL19: J1.6, SW6.1, SW30.1, SW54.1, SW77.1, SW100.1, SW122.1, SW144.1, SW165.1
COL20: J1.5, SW5.1, SW29.1, SW53.1, SW76.1, SW99.1, SW143.1
COL21: J1.4, SW4.1, SW28.1, SW52.1, SW75.1, SW98.1, SW121.1, SW142.1, SW164.1
COL22: J1.3, SW3.1, SW27.1, SW51.1, SW74.1, SW97.1, SW120.1, SW141.1, SW163.1
COL23: J1.2, SW2.1, SW26.1, SW50.1, SW73.1, SW96.1, SW119.1, SW140.1, SW162.1
COL24: J1.1, SW1.1, SW25.1, SW49.1, SW72.1, SW95.1, SW118.1, SW139.1, SW161.1
G1: R27.2, U4.27 (CS02)
G1c: LED181.2 (GK), LED182.2 (GK), LED183.2 (GK), LED184.2 (GK), LED185.2 (GK), LED186.2 (GK), LED187.2 (GK), LED188.2 (GK), LED189.2 (GK), R27.1
G2: R28.2, U4.30 (CS05)
G2c: LED1.2 (GK), LED25.2 (GK), LED49.2 (GK), LED72.2 (GK), LED95.2 (GK), LED118.2 (GK), LED139.2 (GK), LED161.2 (GK), LED190.2 (GK), R28.1
G3: R29.2, U4.33 (CS08)
G3c: LED2.2 (GK), LED26.2 (GK), LED50.2 (GK), LED73.2 (GK), LED96.2 (GK), LED119.2 (GK), LED140.2 (GK), LED162.2 (GK), LED191.2 (GK), R29.1
G4: R30.2, U4.37 (CS11)
G4c: LED3.2 (GK), LED27.2 (GK), LED51.2 (GK), LED74.2 (GK), LED97.2 (GK), LED120.2 (GK), LED141.2 (GK), LED163.2 (GK), LED192.2 (GK), R30.1
G5: R31.2, U4.40 (CS14)
G5c: LED4.2 (GK), LED28.2 (GK), LED52.2 (GK), LED75.2 (GK), LED98.2 (GK), LED121.2 (GK), LED142.2 (GK), LED164.2 (GK), LED193.2 (GK), R31.1
G6: R32.2, U4.43 (CS17)
G6c: LED5.2 (GK), LED29.2 (GK), LED53.2 (GK), LED76.2 (GK), LED99.2 (GK), LED143.2 (GK), LED194.2 (GK), R32.1
G7: R33.2, U4.46 (CS20)
G7c: LED6.2 (GK), LED30.2 (GK), LED54.2 (GK), LED77.2 (GK), LED100.2 (GK), LED122.2 (GK), LED144.2 (GK), LED165.2 (GK), LED195.2 (GK), R33.1
G8: R34.2, U4.49 (CS23)
G8c: LED7.2 (GK), LED31.2 (GK), LED55.2 (GK), LED78.2 (GK), LED101.2 (GK), LED123.2 (GK), LED145.2 (GK), LED166.2 (GK), LED196.2 (GK), R34.1
G9: R35.2, U4.52 (CS26)
G9c: LED8.2 (GK), LED32.2 (GK), LED56.2 (GK), LED79.2 (GK), LED102.2 (GK), LED124.2 (GK), LED146.2 (GK), LED197.2 (GK), R35.1
G10: R36.2, U4.56 (CS29)
G10c: LED9.2 (GK), LED33.2 (GK), LED57.2 (GK), LED80.2 (GK), LED103.2 (GK), LED125.2 (GK), LED147.2 (GK), LED167.2 (GK), LED198.2 (GK), R36.1
G11: R37.2, U4.59 (CS32)
G11c: LED10.2 (GK), LED34.2 (GK), LED58.2 (GK), LED81.2 (GK), LED104.2 (GK), LED126.2 (GK), LED148.2 (GK), LED168.2 (GK), LED199.2 (GK), R37.1
G12: R38.2, U4.2 (CS35)
G12c: LED11.2 (GK), LED35.2 (GK), LED59.2 (GK), LED82.2 (GK), LED105.2 (GK), LED127.2 (GK), LED149.2 (GK), LED169.2 (GK), LED200.2 (GK), R38.1
G13: R39.2, U4.5 (CS38)
G13c: LED12.2 (GK), LED36.2 (GK), LED60.2 (GK), LED83.2 (GK), LED106.2 (GK), LED128.2 (GK), LED150.2 (GK), LED177.2 (GK), LED201.2 (GK), R39.1
G14: R40.2, U5.27 (CS02)
G14c: LED13.2 (GK), LED37.2 (GK), LED61.2 (GK), LED84.2 (GK), LED107.2 (GK), LED129.2 (GK), LED151.2 (GK), LED178.2 (GK), LED202.2 (GK), R40.1
G15: R41.2, U5.30 (CS05)
G15c: LED14.2 (GK), LED38.2 (GK), LED62.2 (GK), LED85.2 (GK), LED108.2 (GK), LED130.2 (GK), LED152.2 (GK), LED170.2 (GK), LED203.2 (GK), R41.1
G16: R42.2, U5.33 (CS08)
G16c: LED15.2 (GK), LED39.2 (GK), LED63.2 (GK), LED86.2 (GK), LED109.2 (GK), LED131.2 (GK), LED153.2 (GK), LED179.2 (GK), LED204.2 (GK), R42.1
G17: R43.2, U5.37 (CS11)
G17c: LED16.2 (GK), LED40.2 (GK), LED64.2 (GK), LED87.2 (GK), LED110.2 (GK), LED132.2 (GK), LED154.2 (GK), LED180.2 (GK), LED205.2 (GK), R43.1
G18: R44.2, U5.40 (CS14)
G18c: LED17.2 (GK), LED41.2 (GK), LED65.2 (GK), LED88.2 (GK), LED111.2 (GK), LED133.2 (GK), LED155.2 (GK), LED206.2 (GK), R44.1
G19: R45.2, U5.43 (CS17)
G19c: LED18.2 (GK), LED42.2 (GK), LED66.2 (GK), LED89.2 (GK), LED112.2 (GK), LED134.2 (GK), LED156.2 (GK), LED171.2 (GK), LED207.2 (GK), R45.1
G20: R46.2, U5.46 (CS20)
G20c: LED19.2 (GK), LED43.2 (GK), LED67.2 (GK), LED90.2 (GK), LED113.2 (GK), LED135.2 (GK), LED157.2 (GK), LED172.2 (GK), LED208.2 (GK), R46.1
G21: R47.2, U5.49 (CS23)
G21c: LED20.2 (GK), LED44.2 (GK), LED68.2 (GK), LED91.2 (GK), LED114.2 (GK), LED136.2 (GK), LED173.2 (GK), LED209.2 (GK), R47.1
G22: R48.2, U5.52 (CS26)
G22c: LED21.2 (GK), LED45.2 (GK), LED69.2 (GK), LED92.2 (GK), LED115.2 (GK), LED158.2 (GK), LED174.2 (GK), LED210.2 (GK), R48.1
G23: R49.2, U5.56 (CS29)
G23c: LED22.2 (GK), LED46.2 (GK), LED211.2 (GK), R49.1
G24: R50.2, U5.59 (CS32)
G24c: LED23.2 (GK), LED47.2 (GK), LED70.2 (GK), LED93.2 (GK), LED116.2 (GK), LED137.2 (GK), LED159.2 (GK), LED175.2 (GK), LED212.2 (GK), R50.1
G25: R51.2, U5.2 (CS35)
G25c: LED24.2 (GK), LED48.2 (GK), LED71.2 (GK), LED94.2 (GK), LED117.2 (GK), LED138.2 (GK), LED160.2 (GK), LED176.2 (GK), LED213.2 (GK), R51.1
G26: R52.2, U5.5 (CS38)
G26c: LED214.2 (GK), LED215.2 (GK), LED216.2 (GK), LED217.2 (GK), LED218.2 (GK), LED219.2 (GK), LED220.2 (GK), LED221.2 (GK), LED222.2 (GK), R52.1
GND: C1.2, C3.2, C4.2, C5.1, C6.2, C7.2, C8.2, C9.2, C10.2, C11.2, C12.2, C13.2, C14.2, C15.2, C16.2, C17.2, C18.2, C19.2, C20.2, C21.2, C22.2, C23.2, J1.25, J1.26, J1.27, J5.1 (GND), J5.MP (VSS), JP1.2 (B), R101.1, R102.2, TP6.1, U1.6 (VSS), U1.13 (VSS), U2.8 (VSS), U2.25 (EP), U3.2 (V_{SS}), U4.8 (ADDR), U4.12 (GND), U4.36 (GND), U4.55 (GND), U4.EP (GND), U5.12 (GND), U5.36 (GND), U5.55 (GND), U5.EP (GND), U6.3 (GND), U7.9 (GND), U7.11 (COM), U7.12 (A0), U7.13 (A1), U8.3 (GND), U9.3 (GND), U10.3 (GND), U11.3 (GND), U12.3 (GND), U13.3 (GND), U14.3 (GND)
GUARD: J2.9, U2.19 (CS5)
INT: J1.36, TP7.1, U1.11 (GPO), U2.23 (~HI), U4.7 (INTB), U5.7 (INTB)
ISETL: R101.2, U4.13 (R_EXT)
ISETR: R102.1, U5.13 (R_EXT)
LEDOFF: J1.37, U4.11 (SDB), U5.11 (SDB)
unnamed: C1.1, U2.5 (CMOD)
unnamed: C5.2, U2.6 (VCC)
unnamed: D1.2 (A), SW1.2
unnamed: D2.2 (A), SW2.2
unnamed: D3.2 (A), SW3.2
unnamed: D4.2 (A), SW4.2
unnamed: D5.2 (A), SW5.2
unnamed: D6.2 (A), SW6.2
unnamed: D7.2 (A), SW7.2
unnamed: D8.2 (A), SW8.2
unnamed: D9.2 (A), SW9.2
unnamed: D10.2 (A), SW10.2
unnamed: D11.2 (A), SW11.2
unnamed: D12.2 (A), SW12.2
unnamed: D13.2 (A), SW13.2
unnamed: D14.2 (A), SW14.2
unnamed: D15.2 (A), SW15.2
unnamed: D16.2 (A), SW16.2
unnamed: D17.2 (A), SW17.2
unnamed: D18.2 (A), SW18.2
unnamed: D19.2 (A), SW19.2
unnamed: D20.2 (A), SW20.2
unnamed: D21.2 (A), SW21.2
unnamed: D22.2 (A), SW22.2
unnamed: D23.2 (A), SW23.2
unnamed: D24.2 (A), SW24.2
unnamed: D25.2 (A), SW25.2
unnamed: D26.2 (A), SW26.2
unnamed: D27.2 (A), SW27.2
unnamed: D28.2 (A), SW28.2
unnamed: D29.2 (A), SW29.2
unnamed: D30.2 (A), SW30.2
unnamed: D31.2 (A), SW31.2
unnamed: D32.2 (A), SW32.2
unnamed: D33.2 (A), SW33.2
unnamed: D34.2 (A), SW34.2
unnamed: D35.2 (A), SW35.2
unnamed: D36.2 (A), SW36.2
unnamed: D37.2 (A), SW37.2
unnamed: D38.2 (A), SW38.2
unnamed: D39.2 (A), SW39.2
unnamed: D40.2 (A), SW40.2
unnamed: D41.2 (A), SW41.2
unnamed: D42.2 (A), SW42.2
unnamed: D43.2 (A), SW43.2
unnamed: D44.2 (A), SW44.2
unnamed: D45.2 (A), SW45.2
unnamed: D46.2 (A), SW46.2
unnamed: D47.2 (A), SW47.2
unnamed: D48.2 (A), SW48.2
unnamed: D49.2 (A), SW49.2
unnamed: D50.2 (A), SW50.2
unnamed: D51.2 (A), SW51.2
unnamed: D52.2 (A), SW52.2
unnamed: D53.2 (A), SW53.2
unnamed: D54.2 (A), SW54.2
unnamed: D55.2 (A), SW55.2
unnamed: D56.2 (A), SW56.2
unnamed: D57.2 (A), SW57.2
unnamed: D58.2 (A), SW58.2
unnamed: D59.2 (A), SW59.2
unnamed: D60.2 (A), SW60.2
unnamed: D61.2 (A), SW61.2
unnamed: D62.2 (A), SW62.2
unnamed: D63.2 (A), SW63.2
unnamed: D64.2 (A), SW64.2
unnamed: D65.2 (A), SW65.2
unnamed: D66.2 (A), SW66.2
unnamed: D67.2 (A), SW67.2
unnamed: D68.2 (A), SW68.2
unnamed: D69.2 (A), SW69.2
unnamed: D70.2 (A), SW70.2
unnamed: D71.2 (A), SW71.2
unnamed: D72.2 (A), SW72.2
unnamed: D73.2 (A), SW73.2
unnamed: D74.2 (A), SW74.2
unnamed: D75.2 (A), SW75.2
unnamed: D76.2 (A), SW76.2
unnamed: D77.2 (A), SW77.2
unnamed: D78.2 (A), SW78.2
unnamed: D79.2 (A), SW79.2
unnamed: D80.2 (A), SW80.2
unnamed: D81.2 (A), SW81.2
unnamed: D82.2 (A), SW82.2
unnamed: D83.2 (A), SW83.2
unnamed: D84.2 (A), SW84.2
unnamed: D85.2 (A), SW85.2
unnamed: D86.2 (A), SW86.2
unnamed: D87.2 (A), SW87.2
unnamed: D88.2 (A), SW88.2
unnamed: D89.2 (A), SW89.2
unnamed: D90.2 (A), SW90.2
unnamed: D91.2 (A), SW91.2
unnamed: D92.2 (A), SW92.2
unnamed: D93.2 (A), SW93.2
unnamed: D94.2 (A), SW94.2
unnamed: D95.2 (A), SW95.2
unnamed: D96.2 (A), SW96.2
unnamed: D97.2 (A), SW97.2
unnamed: D98.2 (A), SW98.2
unnamed: D99.2 (A), SW99.2
unnamed: D100.2 (A), SW100.2
unnamed: D101.2 (A), SW101.2
unnamed: D102.2 (A), SW102.2
unnamed: D103.2 (A), SW103.2
unnamed: D107.2 (A), SW107.2
unnamed: D108.2 (A), SW108.2
unnamed: D109.2 (A), SW109.2
unnamed: D110.2 (A), SW110.2
unnamed: D111.2 (A), SW111.2
unnamed: D112.2 (A), SW112.2
unnamed: D113.2 (A), SW113.2
unnamed: D114.2 (A), SW114.2
unnamed: D115.2 (A), SW115.2
unnamed: D116.2 (A), SW116.2
unnamed: D117.2 (A), SW117.2
unnamed: D118.2 (A), SW118.2
unnamed: D119.2 (A), SW119.2
unnamed: D120.2 (A), SW120.2
unnamed: D121.2 (A), SW121.2
unnamed: D122.2 (A), SW122.2
unnamed: D123.2 (A), SW123.2
unnamed: D124.2 (A), SW124.2
unnamed: D125.2 (A), SW125.2
unnamed: D129.2 (A), SW129.2
unnamed: D130.2 (A), SW130.2
unnamed: D131.2 (A), SW131.2
unnamed: D132.2 (A), SW132.2
unnamed: D133.2 (A), SW133.2
unnamed: D134.2 (A), SW134.2
unnamed: D135.2 (A), SW135.2
unnamed: D136.2 (A), SW136.2
unnamed: D137.2 (A), SW137.2
unnamed: D138.2 (A), SW138.2
unnamed: D139.2 (A), SW139.2
unnamed: D140.2 (A), SW140.2
unnamed: D141.2 (A), SW141.2
unnamed: D142.2 (A), SW142.2
unnamed: D143.2 (A), SW143.2
unnamed: D144.2 (A), SW144.2
unnamed: D145.2 (A), SW145.2
unnamed: D146.2 (A), SW146.2
unnamed: D148.2 (A), SW148.2
unnamed: D149.2 (A), SW149.2
unnamed: D150.2 (A), SW150.2
unnamed: D151.2 (A), SW151.2
unnamed: D152.2 (A), SW152.2
unnamed: D153.2 (A), SW153.2
unnamed: D154.2 (A), SW154.2
unnamed: D155.2 (A), SW155.2
unnamed: D156.2 (A), SW156.2
unnamed: D157.2 (A), SW157.2
unnamed: D158.2 (A), SW158.2
unnamed: D159.2 (A), SW159.2
unnamed: D160.2 (A), SW160.2
unnamed: D161.2 (A), SW161.2
unnamed: D162.2 (A), SW162.2
unnamed: D163.2 (A), SW163.2
unnamed: D164.2 (A), SW164.2
unnamed: D165.2 (A), SW165.2
unnamed: D166.2 (A), SW166.2
unnamed: D167.2 (A), SW167.2
unnamed: D168.2 (A), SW168.2
unnamed: D169.2 (A), SW169.2
unnamed: D171.2 (A), SW171.2
unnamed: D172.2 (A), SW172.2
unnamed: D173.2 (A), SW173.2
unnamed: D174.2 (A), SW174.2
unnamed: D175.2 (A), SW175.2
unnamed: D176.2 (A), SW176.2
unnamed: U6.2 (VOUT), U7.1 (CH0)
unnamed: U7.2 (CH1), U8.2 (VOUT)
unnamed: U7.3 (CH2), U9.2 (VOUT)
unnamed: U7.4 (CH3), U10.2 (VOUT)
unnamed: U7.5 (CH4), U11.2 (VOUT)
unnamed: U7.6 (CH5), U12.2 (VOUT)
unnamed: U7.7 (CH6), U13.2 (VOUT)
unnamed: U7.8 (CH7), U14.2 (VOUT)
PBOT: J4.1, U2.2 (CS1)
PTOP: J3.1, U2.1 (CS0)
R1: R1.2, U4.26 (CS01)
R1c: LED181.1 (RK), LED182.1 (RK), LED183.1 (RK), LED184.1 (RK), LED185.1 (RK), LED186.1 (RK), LED187.1 (RK), LED188.1 (RK), LED189.1 (RK), R1.1
R2: R2.2, U4.29 (CS04)
R2c: LED1.1 (RK), LED25.1 (RK), LED49.1 (RK), LED72.1 (RK), LED95.1 (RK), LED118.1 (RK), LED139.1 (RK), LED161.1 (RK), LED190.1 (RK), R2.1
R3: R3.2, U4.32 (CS07)
R3c: LED2.1 (RK), LED26.1 (RK), LED50.1 (RK), LED73.1 (RK), LED96.1 (RK), LED119.1 (RK), LED140.1 (RK), LED162.1 (RK), LED191.1 (RK), R3.1
R4: R4.2, U4.35 (CS10)
R4c: LED3.1 (RK), LED27.1 (RK), LED51.1 (RK), LED74.1 (RK), LED97.1 (RK), LED120.1 (RK), LED141.1 (RK), LED163.1 (RK), LED192.1 (RK), R4.1
R5: R5.2, U4.39 (CS13)
R5c: LED4.1 (RK), LED28.1 (RK), LED52.1 (RK), LED75.1 (RK), LED98.1 (RK), LED121.1 (RK), LED142.1 (RK), LED164.1 (RK), LED193.1 (RK), R5.1
R6: R6.2, U4.42 (CS16)
R6c: LED5.1 (RK), LED29.1 (RK), LED53.1 (RK), LED76.1 (RK), LED99.1 (RK), LED143.1 (RK), LED194.1 (RK), R6.1
R7: R7.2, U4.45 (CS19)
R7c: LED6.1 (RK), LED30.1 (RK), LED54.1 (RK), LED77.1 (RK), LED100.1 (RK), LED122.1 (RK), LED144.1 (RK), LED165.1 (RK), LED195.1 (RK), R7.1
R8: R8.2, U4.48 (CS22)
R8c: LED7.1 (RK), LED31.1 (RK), LED55.1 (RK), LED78.1 (RK), LED101.1 (RK), LED123.1 (RK), LED145.1 (RK), LED166.1 (RK), LED196.1 (RK), R8.1
R9: R9.2, U4.51 (CS25)
R9c: LED8.1 (RK), LED32.1 (RK), LED56.1 (RK), LED79.1 (RK), LED102.1 (RK), LED124.1 (RK), LED146.1 (RK), LED197.1 (RK), R9.1
R10: R10.2, U4.54 (CS28)
R10c: LED9.1 (RK), LED33.1 (RK), LED57.1 (RK), LED80.1 (RK), LED103.1 (RK), LED125.1 (RK), LED147.1 (RK), LED167.1 (RK), LED198.1 (RK), R10.1
R11: R11.2, U4.58 (CS31)
R11c: LED10.1 (RK), LED34.1 (RK), LED58.1 (RK), LED81.1 (RK), LED104.1 (RK), LED126.1 (RK), LED148.1 (RK), LED168.1 (RK), LED199.1 (RK), R11.1
R12: R12.2, U4.1 (CS34)
R12c: LED11.1 (RK), LED35.1 (RK), LED59.1 (RK), LED82.1 (RK), LED105.1 (RK), LED127.1 (RK), LED149.1 (RK), LED169.1 (RK), LED200.1 (RK), R12.1
R13: R13.2, U4.4 (CS37)
R13c: LED12.1 (RK), LED36.1 (RK), LED60.1 (RK), LED83.1 (RK), LED106.1 (RK), LED128.1 (RK), LED150.1 (RK), LED177.1 (RK), LED201.1 (RK), R13.1
R14: R14.2, U5.26 (CS01)
R14c: LED13.1 (RK), LED37.1 (RK), LED61.1 (RK), LED84.1 (RK), LED107.1 (RK), LED129.1 (RK), LED151.1 (RK), LED178.1 (RK), LED202.1 (RK), R14.1
R15: R15.2, U5.29 (CS04)
R15c: LED14.1 (RK), LED38.1 (RK), LED62.1 (RK), LED85.1 (RK), LED108.1 (RK), LED130.1 (RK), LED152.1 (RK), LED170.1 (RK), LED203.1 (RK), R15.1
R16: R16.2, U5.32 (CS07)
R16c: LED15.1 (RK), LED39.1 (RK), LED63.1 (RK), LED86.1 (RK), LED109.1 (RK), LED131.1 (RK), LED153.1 (RK), LED179.1 (RK), LED204.1 (RK), R16.1
R17: R17.2, U5.35 (CS10)
R17c: LED16.1 (RK), LED40.1 (RK), LED64.1 (RK), LED87.1 (RK), LED110.1 (RK), LED132.1 (RK), LED154.1 (RK), LED180.1 (RK), LED205.1 (RK), R17.1
R18: R18.2, U5.39 (CS13)
R18c: LED17.1 (RK), LED41.1 (RK), LED65.1 (RK), LED88.1 (RK), LED111.1 (RK), LED133.1 (RK), LED155.1 (RK), LED206.1 (RK), R18.1
R19: R19.2, U5.42 (CS16)
R19c: LED18.1 (RK), LED42.1 (RK), LED66.1 (RK), LED89.1 (RK), LED112.1 (RK), LED134.1 (RK), LED156.1 (RK), LED171.1 (RK), LED207.1 (RK), R19.1
R20: R20.2, U5.45 (CS19)
R20c: LED19.1 (RK), LED43.1 (RK), LED67.1 (RK), LED90.1 (RK), LED113.1 (RK), LED135.1 (RK), LED157.1 (RK), LED172.1 (RK), LED208.1 (RK), R20.1
R21: R21.2, U5.48 (CS22)
R21c: LED20.1 (RK), LED44.1 (RK), LED68.1 (RK), LED91.1 (RK), LED114.1 (RK), LED136.1 (RK), LED173.1 (RK), LED209.1 (RK), R21.1
R22: R22.2, U5.51 (CS25)
R22c: LED21.1 (RK), LED45.1 (RK), LED69.1 (RK), LED92.1 (RK), LED115.1 (RK), LED158.1 (RK), LED174.1 (RK), LED210.1 (RK), R22.1
R23: R23.2, U5.54 (CS28)
R23c: LED22.1 (RK), LED46.1 (RK), LED211.1 (RK), R23.1
R24: R24.2, U5.58 (CS31)
R24c: LED23.1 (RK), LED47.1 (RK), LED70.1 (RK), LED93.1 (RK), LED116.1 (RK), LED137.1 (RK), LED159.1 (RK), LED175.1 (RK), LED212.1 (RK), R24.1
R25: R25.2, U5.1 (CS34)
R25c: LED24.1 (RK), LED48.1 (RK), LED71.1 (RK), LED94.1 (RK), LED117.1 (RK), LED138.1 (RK), LED160.1 (RK), LED176.1 (RK), LED213.1 (RK), R25.1
R26: R26.2, U5.4 (CS37)
R26c: LED214.1 (RK), LED215.1 (RK), LED216.1 (RK), LED217.1 (RK), LED218.1 (RK), LED219.1 (RK), LED220.1 (RK), LED221.1 (RK), LED222.1 (RK), R26.1
ROW1: D1.1 (K), D2.1 (K), D3.1 (K), D4.1 (K), D5.1 (K), D6.1 (K), D7.1 (K), D8.1 (K), D9.1 (K), D10.1 (K), D11.1 (K), D12.1 (K), D13.1 (K), D14.1 (K), D15.1 (K), D16.1 (K), D17.1 (K), D18.1 (K), D19.1 (K), D20.1 (K), D21.1 (K), D22.1 (K), D23.1 (K), D24.1 (K), J1.24
ROW2: D25.1 (K), D26.1 (K), D27.1 (K), D28.1 (K), D29.1 (K), D30.1 (K), D31.1 (K), D32.1 (K), D33.1 (K), D34.1 (K), D35.1 (K), D36.1 (K), D37.1 (K), D38.1 (K), D39.1 (K), D40.1 (K), D41.1 (K), D42.1 (K), D43.1 (K), D44.1 (K), D45.1 (K), D46.1 (K), D47.1 (K), D48.1 (K), J1.23
ROW3: D49.1 (K), D50.1 (K), D51.1 (K), D52.1 (K), D53.1 (K), D54.1 (K), D55.1 (K), D56.1 (K), D57.1 (K), D58.1 (K), D59.1 (K), D60.1 (K), D61.1 (K), D62.1 (K), D63.1 (K), D64.1 (K), D65.1 (K), D66.1 (K), D67.1 (K), D68.1 (K), D69.1 (K), D70.1 (K), D71.1 (K), J1.22
ROW4: D72.1 (K), D73.1 (K), D74.1 (K), D75.1 (K), D76.1 (K), D77.1 (K), D78.1 (K), D79.1 (K), D80.1 (K), D81.1 (K), D82.1 (K), D83.1 (K), D84.1 (K), D85.1 (K), D86.1 (K), D87.1 (K), D88.1 (K), D89.1 (K), D90.1 (K), D91.1 (K), D92.1 (K), D93.1 (K), D94.1 (K), J1.21
ROW5: D95.1 (K), D96.1 (K), D97.1 (K), D98.1 (K), D99.1 (K), D100.1 (K), D101.1 (K), D102.1 (K), D103.1 (K), D107.1 (K), D108.1 (K), D109.1 (K), D110.1 (K), D111.1 (K), D112.1 (K), D113.1 (K), D114.1 (K), D115.1 (K), D116.1 (K), D117.1 (K), J1.20
ROW6: D118.1 (K), D119.1 (K), D120.1 (K), D121.1 (K), D122.1 (K), D123.1 (K), D124.1 (K), D125.1 (K), D129.1 (K), D130.1 (K), D131.1 (K), D132.1 (K), D133.1 (K), D134.1 (K), D135.1 (K), D136.1 (K), D137.1 (K), D138.1 (K), J1.19
ROW7: D139.1 (K), D140.1 (K), D141.1 (K), D142.1 (K), D143.1 (K), D144.1 (K), D145.1 (K), D146.1 (K), D148.1 (K), D149.1 (K), D150.1 (K), D151.1 (K), D152.1 (K), D153.1 (K), D154.1 (K), D155.1 (K), D156.1 (K), D157.1 (K), D158.1 (K), D159.1 (K), D160.1 (K), J1.18
ROW8: D161.1 (K), D162.1 (K), D163.1 (K), D164.1 (K), D165.1 (K), D166.1 (K), D167.1 (K), D168.1 (K), D169.1 (K), D171.1 (K), D172.1 (K), D173.1 (K), D174.1 (K), D175.1 (K), D176.1 (K), J1.17
SCL: J1.35, J5.4 (SCL), TP3.1, U1.8 (SCL), U2.22 (SCL), U3.1 (SCL), U4.10 (SCL), U5.10 (SCL), U7.14 (SCL)
SDA: J1.34, J5.3 (SDA), TP4.1, U1.7 (SDA), U2.21 (SDA), U3.3 (SDA), U4.9 (SDA), U5.9 (SDA), U7.15 (SDA)
SHIELD: J2.1, J2.17, U2.20 (CS4)
SLDL1: J2.16, U2.13 (SLD14)
SLDL2: J2.15, U2.12 (SLD13)
SLDL3: J2.14, U2.11 (SLD12)
SLDL4: J2.13, U2.10 (SLD11)
SLDL5: J2.12, U2.9 (SLD10)
SLDR1: J2.2, U2.14 (CS11)
SLDR2: J2.3, U2.15 (CS12)
SLDR3: J2.4, U2.16 (CS13)
SLDR4: J2.5, U2.17 (CS14)
SLDR5: J2.6, U2.18 (CS15)
SW1_L: LED1.4 (A), LED2.4 (A), LED3.4 (A), LED4.4 (A), LED5.4 (A), LED6.4 (A), LED7.4 (A), LED8.4 (A), LED9.4 (A), LED10.4 (A), LED11.4 (A), LED12.4 (A), LED181.4 (A), U4.16 (SW1)
SW1_R: LED13.4 (A), LED14.4 (A), LED15.4 (A), LED16.4 (A), LED17.4 (A), LED18.4 (A), LED19.4 (A), LED20.4 (A), LED21.4 (A), LED22.4 (A), LED23.4 (A), LED24.4 (A), LED222.4 (A), U5.16 (SW1)
SW2_L: LED25.4 (A), LED26.4 (A), LED27.4 (A), LED28.4 (A), LED29.4 (A), LED30.4 (A), LED31.4 (A), LED32.4 (A), LED33.4 (A), LED34.4 (A), LED35.4 (A), LED36.4 (A), LED182.4 (A), U4.17 (SW2)
SW2_R: LED37.4 (A), LED38.4 (A), LED39.4 (A), LED40.4 (A), LED41.4 (A), LED42.4 (A), LED43.4 (A), LED44.4 (A), LED45.4 (A), LED46.4 (A), LED47.4 (A), LED48.4 (A), LED221.4 (A), U5.17 (SW2)
SW3_L: LED49.4 (A), LED50.4 (A), LED51.4 (A), LED52.4 (A), LED53.4 (A), LED54.4 (A), LED55.4 (A), LED56.4 (A), LED57.4 (A), LED58.4 (A), LED59.4 (A), LED60.4 (A), LED183.4 (A), U4.18 (SW3)
SW3_R: LED61.4 (A), LED62.4 (A), LED63.4 (A), LED64.4 (A), LED65.4 (A), LED66.4 (A), LED67.4 (A), LED68.4 (A), LED69.4 (A), LED70.4 (A), LED71.4 (A), LED220.4 (A), U5.18 (SW3)
SW4_L: LED72.4 (A), LED73.4 (A), LED74.4 (A), LED75.4 (A), LED76.4 (A), LED77.4 (A), LED78.4 (A), LED79.4 (A), LED80.4 (A), LED81.4 (A), LED82.4 (A), LED83.4 (A), LED184.4 (A), U4.19 (SW4)
SW4_R: LED84.4 (A), LED85.4 (A), LED86.4 (A), LED87.4 (A), LED88.4 (A), LED89.4 (A), LED90.4 (A), LED91.4 (A), LED92.4 (A), LED93.4 (A), LED94.4 (A), LED219.4 (A), U5.19 (SW4)
SW5_L: LED95.4 (A), LED96.4 (A), LED97.4 (A), LED98.4 (A), LED99.4 (A), LED100.4 (A), LED101.4 (A), LED102.4 (A), LED103.4 (A), LED104.4 (A), LED105.4 (A), LED106.4 (A), LED185.4 (A), U4.20 (SW5)
SW5_R: LED107.4 (A), LED108.4 (A), LED109.4 (A), LED110.4 (A), LED111.4 (A), LED112.4 (A), LED113.4 (A), LED114.4 (A), LED115.4 (A), LED116.4 (A), LED117.4 (A), LED218.4 (A), U5.20 (SW5)
SW6_L: LED118.4 (A), LED119.4 (A), LED120.4 (A), LED121.4 (A), LED122.4 (A), LED123.4 (A), LED124.4 (A), LED125.4 (A), LED126.4 (A), LED127.4 (A), LED128.4 (A), LED186.4 (A), U4.21 (SW6)
SW6_R: LED129.4 (A), LED130.4 (A), LED131.4 (A), LED132.4 (A), LED133.4 (A), LED134.4 (A), LED135.4 (A), LED136.4 (A), LED137.4 (A), LED138.4 (A), LED217.4 (A), U5.21 (SW6)
SW7_L: LED139.4 (A), LED140.4 (A), LED141.4 (A), LED142.4 (A), LED143.4 (A), LED144.4 (A), LED145.4 (A), LED146.4 (A), LED147.4 (A), LED148.4 (A), LED149.4 (A), LED150.4 (A), LED187.4 (A), U4.22 (SW7)
SW7_R: LED151.4 (A), LED152.4 (A), LED153.4 (A), LED154.4 (A), LED155.4 (A), LED156.4 (A), LED157.4 (A), LED158.4 (A), LED159.4 (A), LED160.4 (A), LED216.4 (A), U5.22 (SW7)
SW8_L: LED161.4 (A), LED162.4 (A), LED163.4 (A), LED164.4 (A), LED165.4 (A), LED166.4 (A), LED167.4 (A), LED168.4 (A), LED169.4 (A), LED177.4 (A), LED188.4 (A), U4.23 (SW8)
SW8_R: LED170.4 (A), LED171.4 (A), LED172.4 (A), LED173.4 (A), LED174.4 (A), LED175.4 (A), LED176.4 (A), LED178.4 (A), LED179.4 (A), LED180.4 (A), LED215.4 (A), U5.23 (SW8)
SW9_L: LED189.4 (A), LED190.4 (A), LED191.4 (A), LED192.4 (A), LED193.4 (A), LED194.4 (A), LED195.4 (A), LED196.4 (A), LED197.4 (A), LED198.4 (A), LED199.4 (A), LED200.4 (A), LED201.4 (A), U4.24 (SW9)
SW9_R: LED202.4 (A), LED203.4 (A), LED204.4 (A), LED205.4 (A), LED206.4 (A), LED207.4 (A), LED208.4 (A), LED209.4 (A), LED210.4 (A), LED211.4 (A), LED212.4 (A), LED213.4 (A), LED214.4 (A), U5.24 (SW9)
TOPL: J2.7, U2.3 (CS2)
TOPR: J2.11, U2.4 (CS3)
WP: JP1.1 (A), R100.2, TP5.1, U3.5 (WP)

Notes on the sheet:
2.25u
6.25u
