12voltman/SimulType/Hardware/keymatrixes/fullanalog/SimulTypeUltraFullMag/SimulTypeUltraFullMag.kicad_sch

## KiCad design Hardware/keymatrixes/fullanalog/SimulTypeUltraFullMag/SimulTypeUltraFullMag.kicad_sch (2024-07-02)

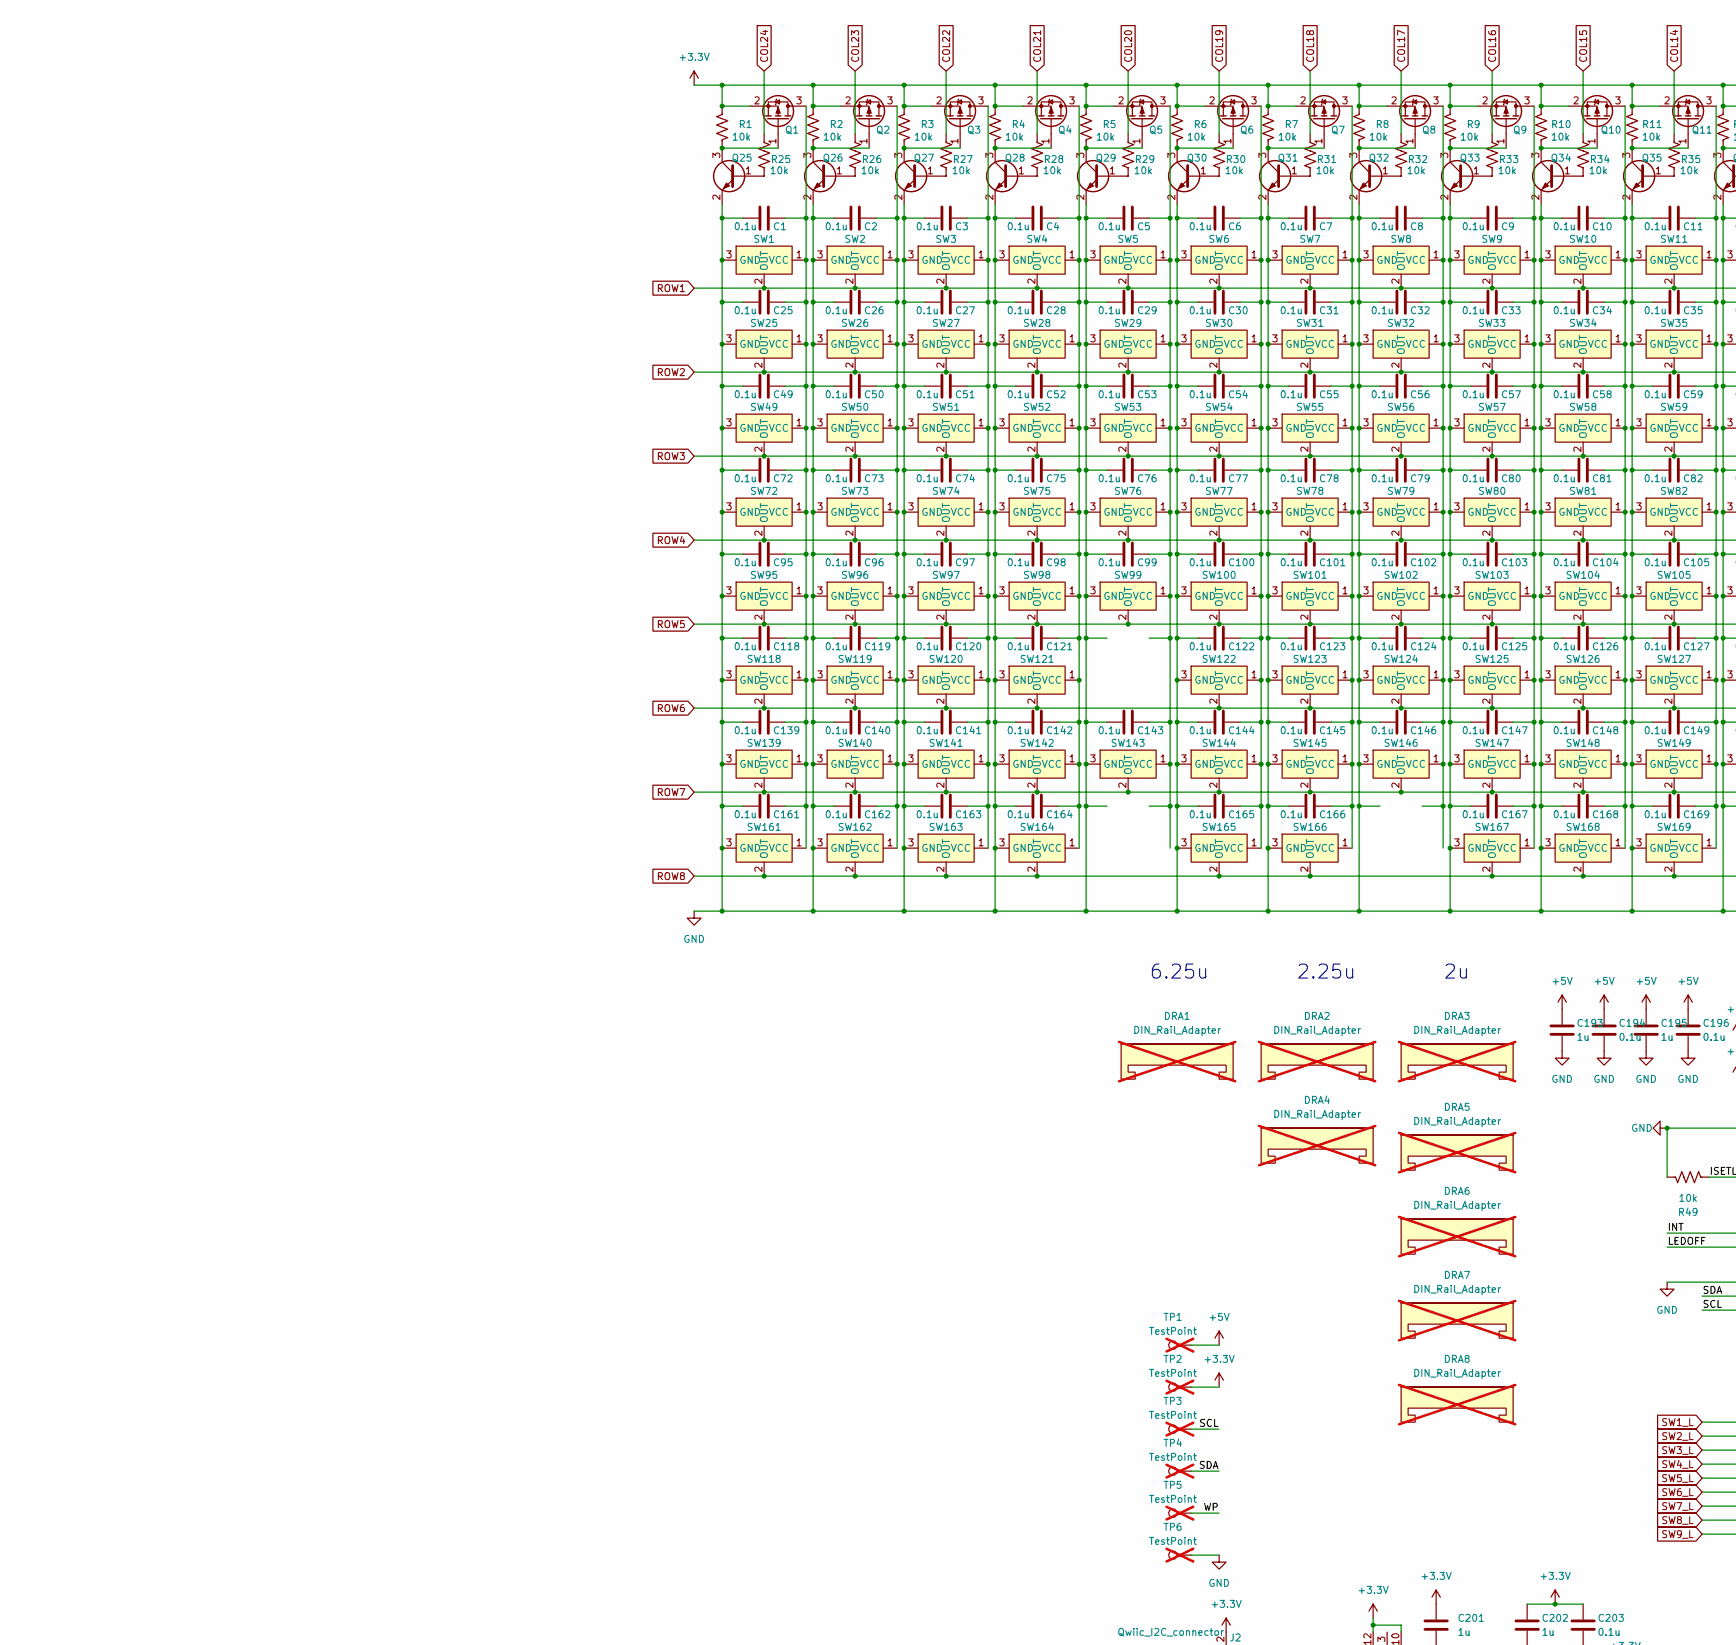
[picture p11: schematic SimulTypeUltraFullMag.kicad_sch, part in row 1, column 1]

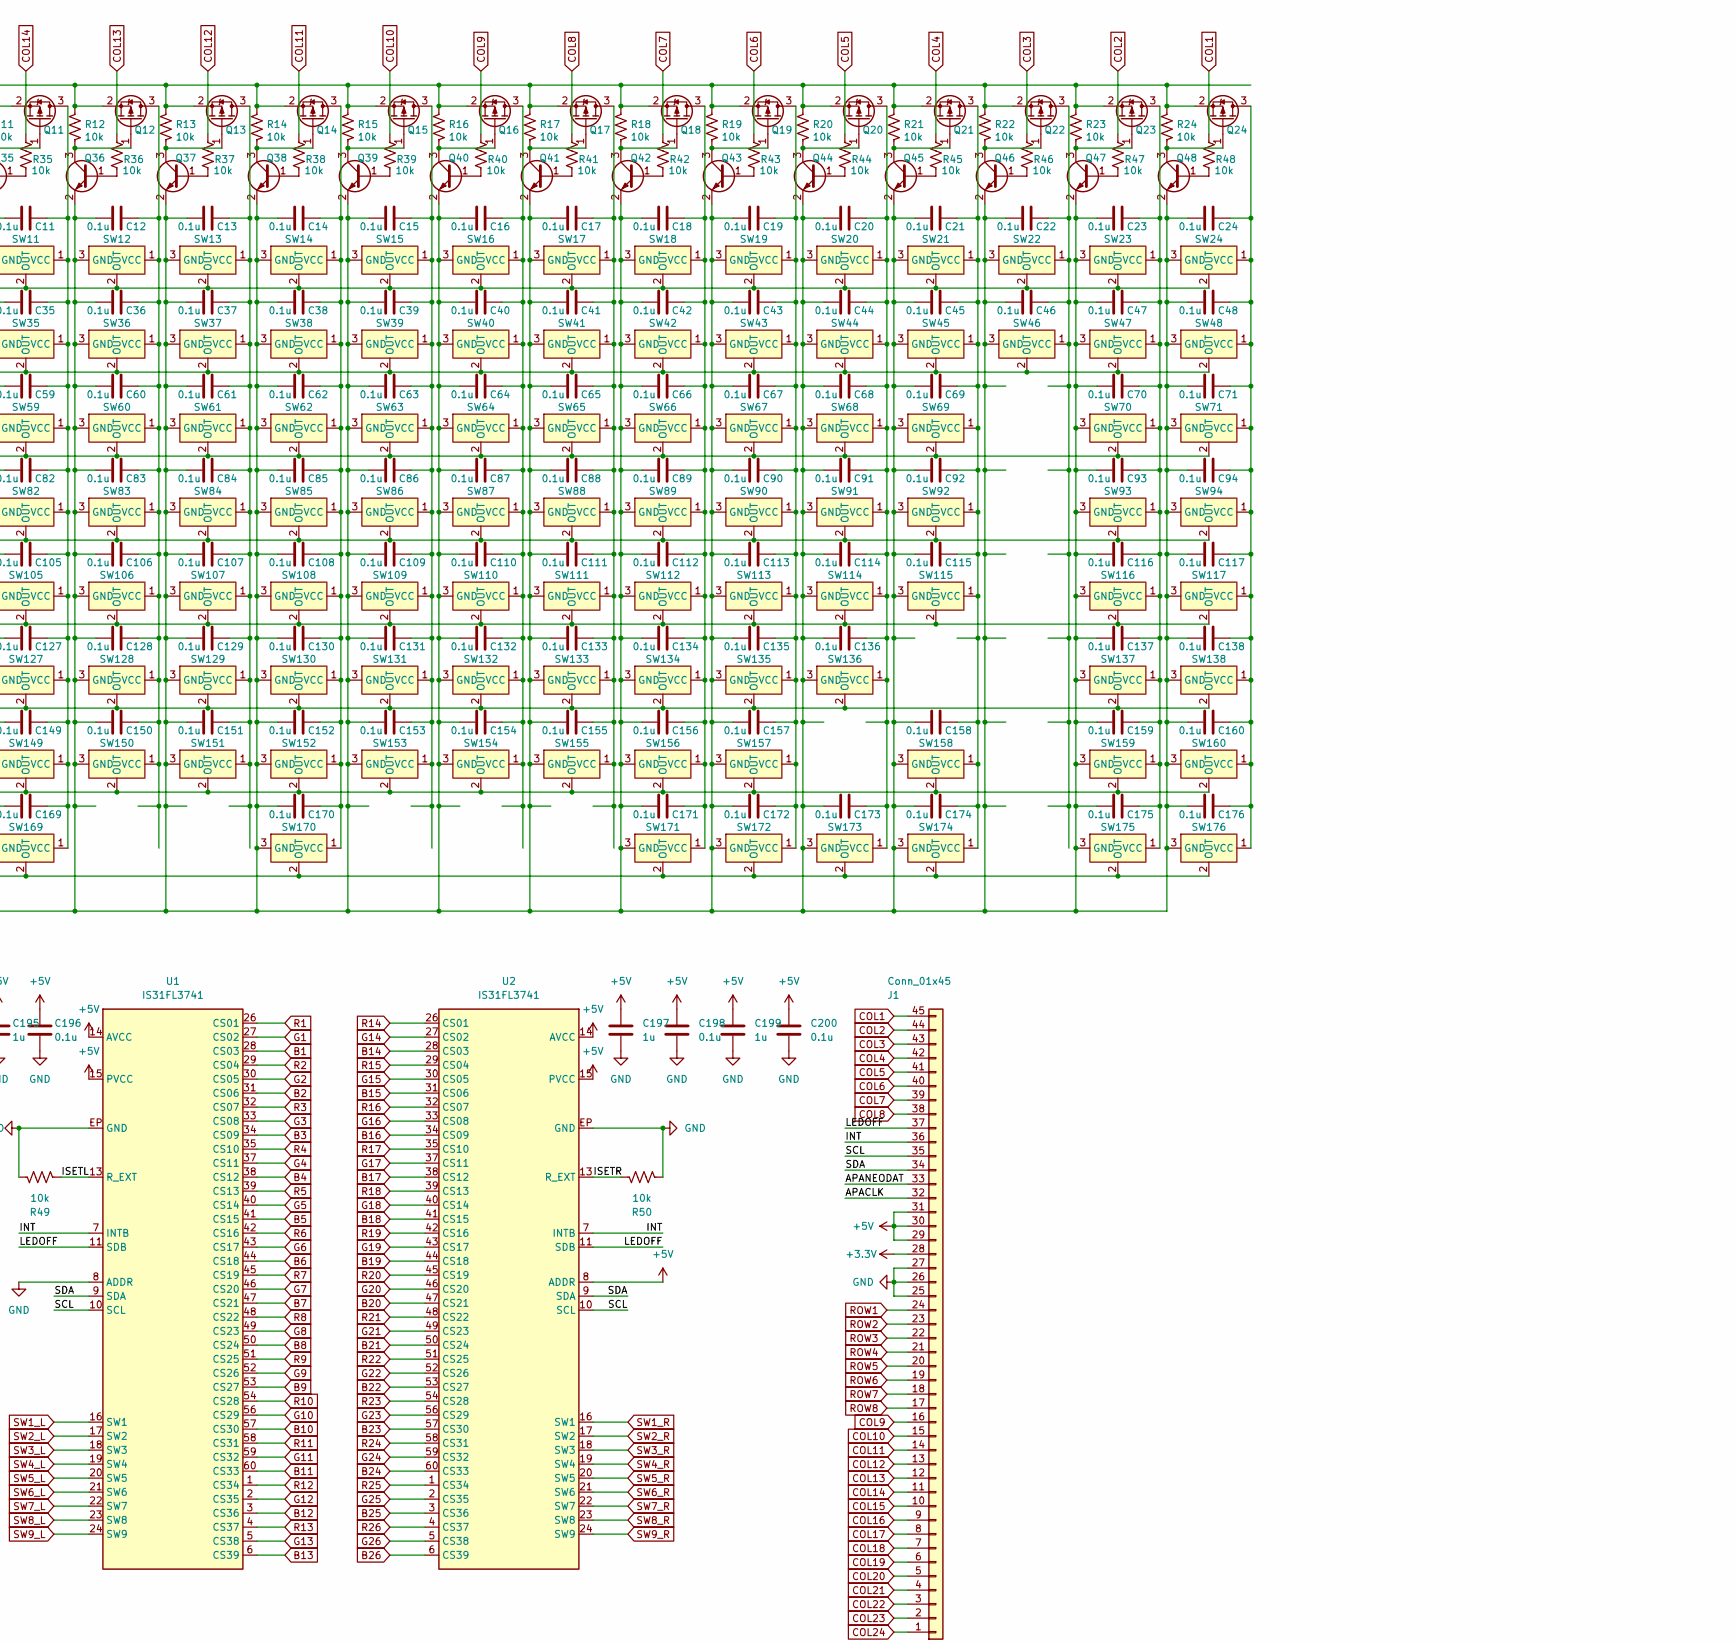
[picture p12: schematic SimulTypeUltraFullMag.kicad_sch, part in row 1, column 2]

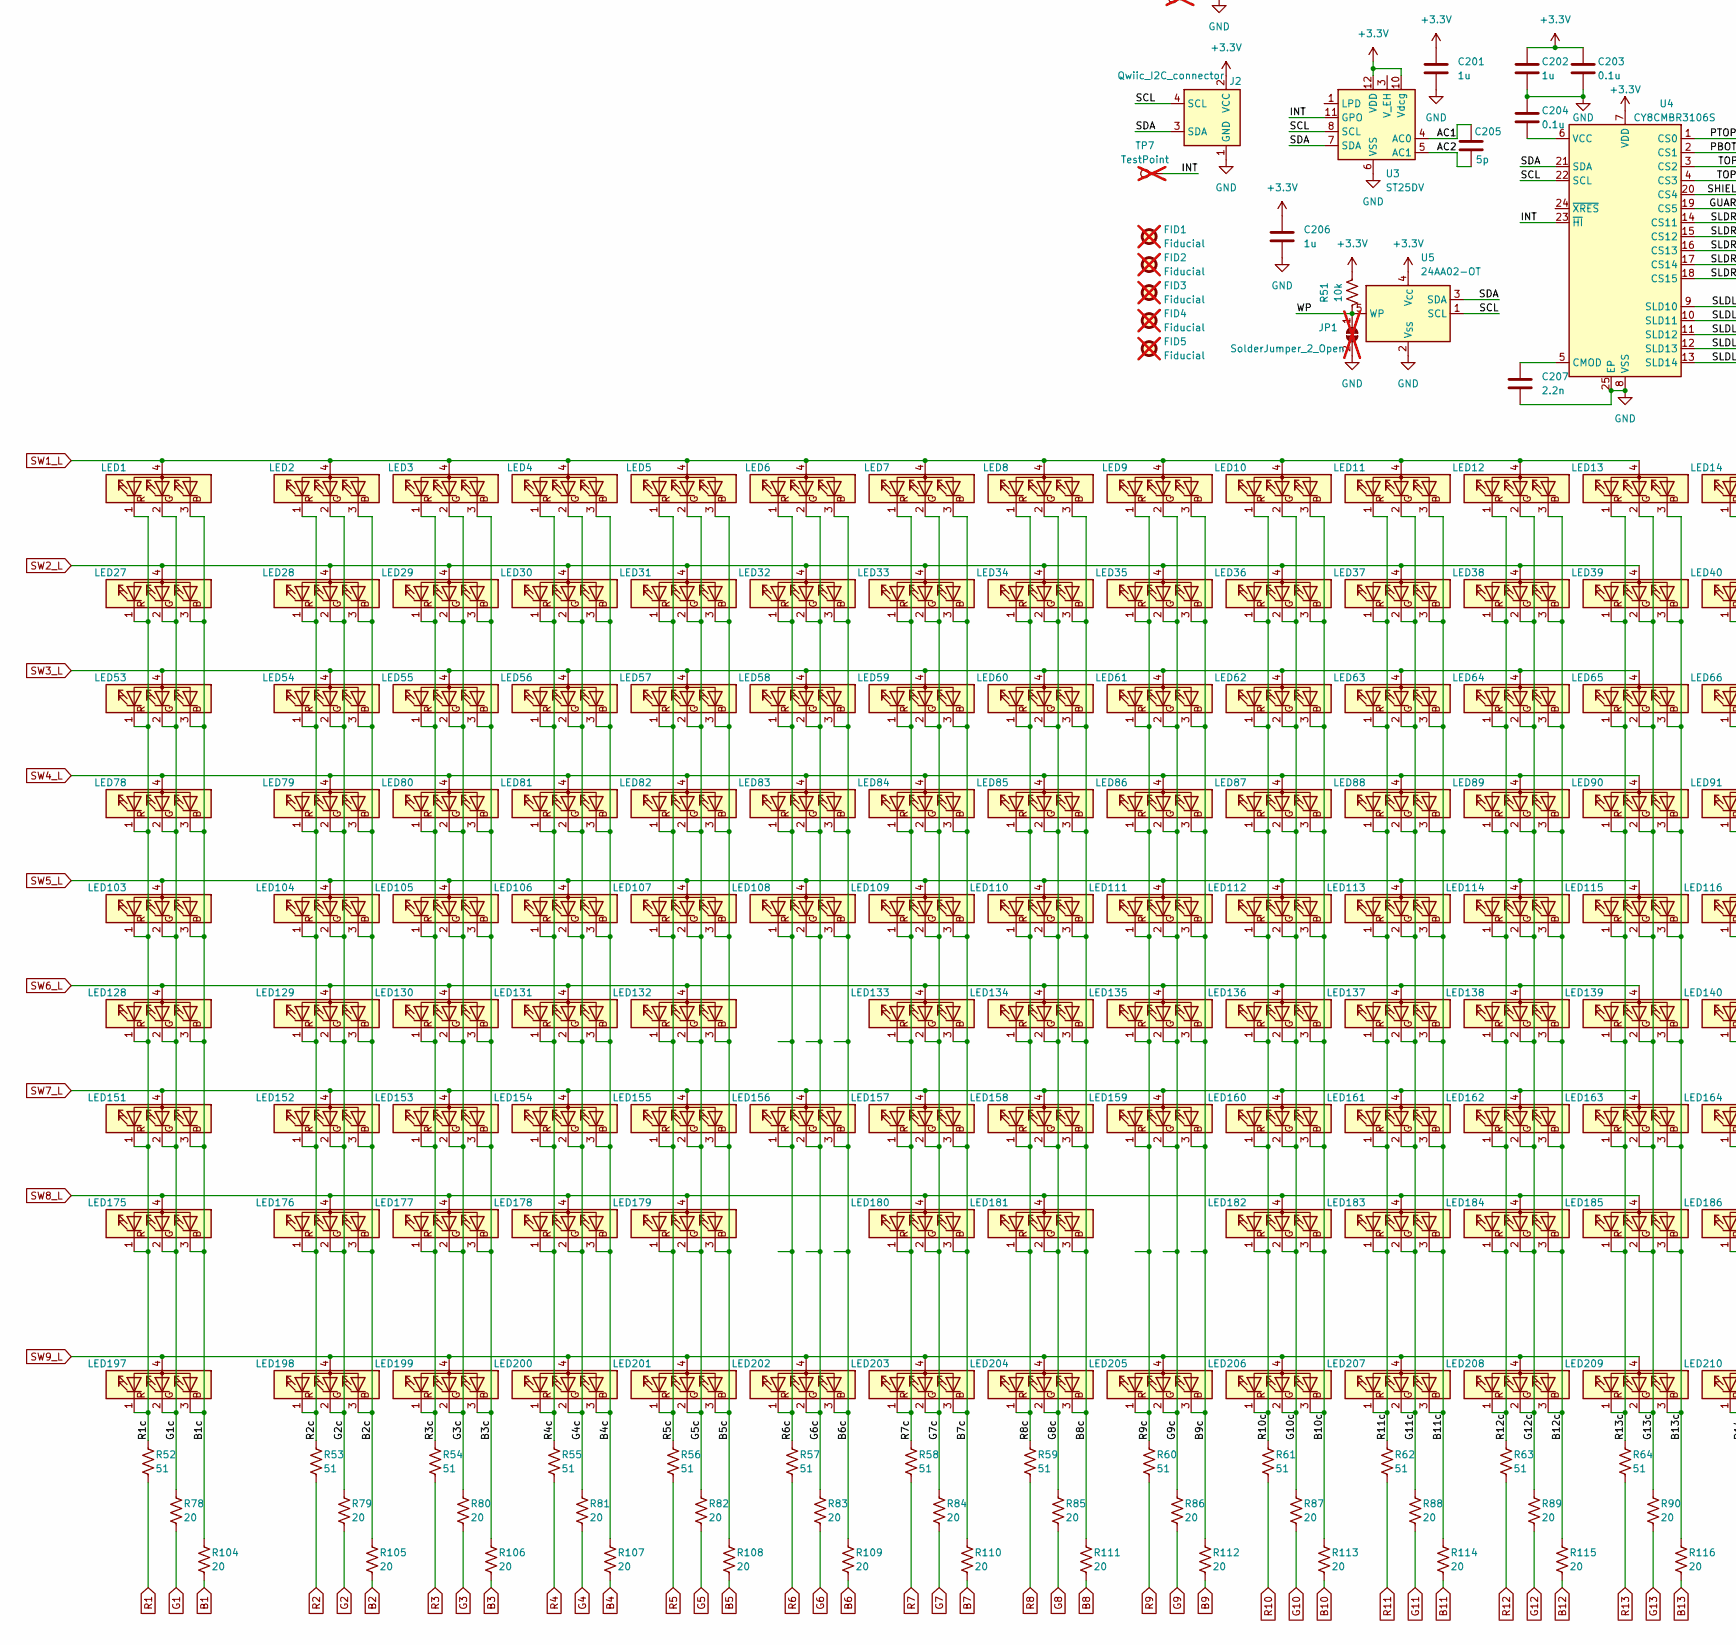
[picture p13: schematic SimulTypeUltraFullMag.kicad_sch, part in row 2, column 1]

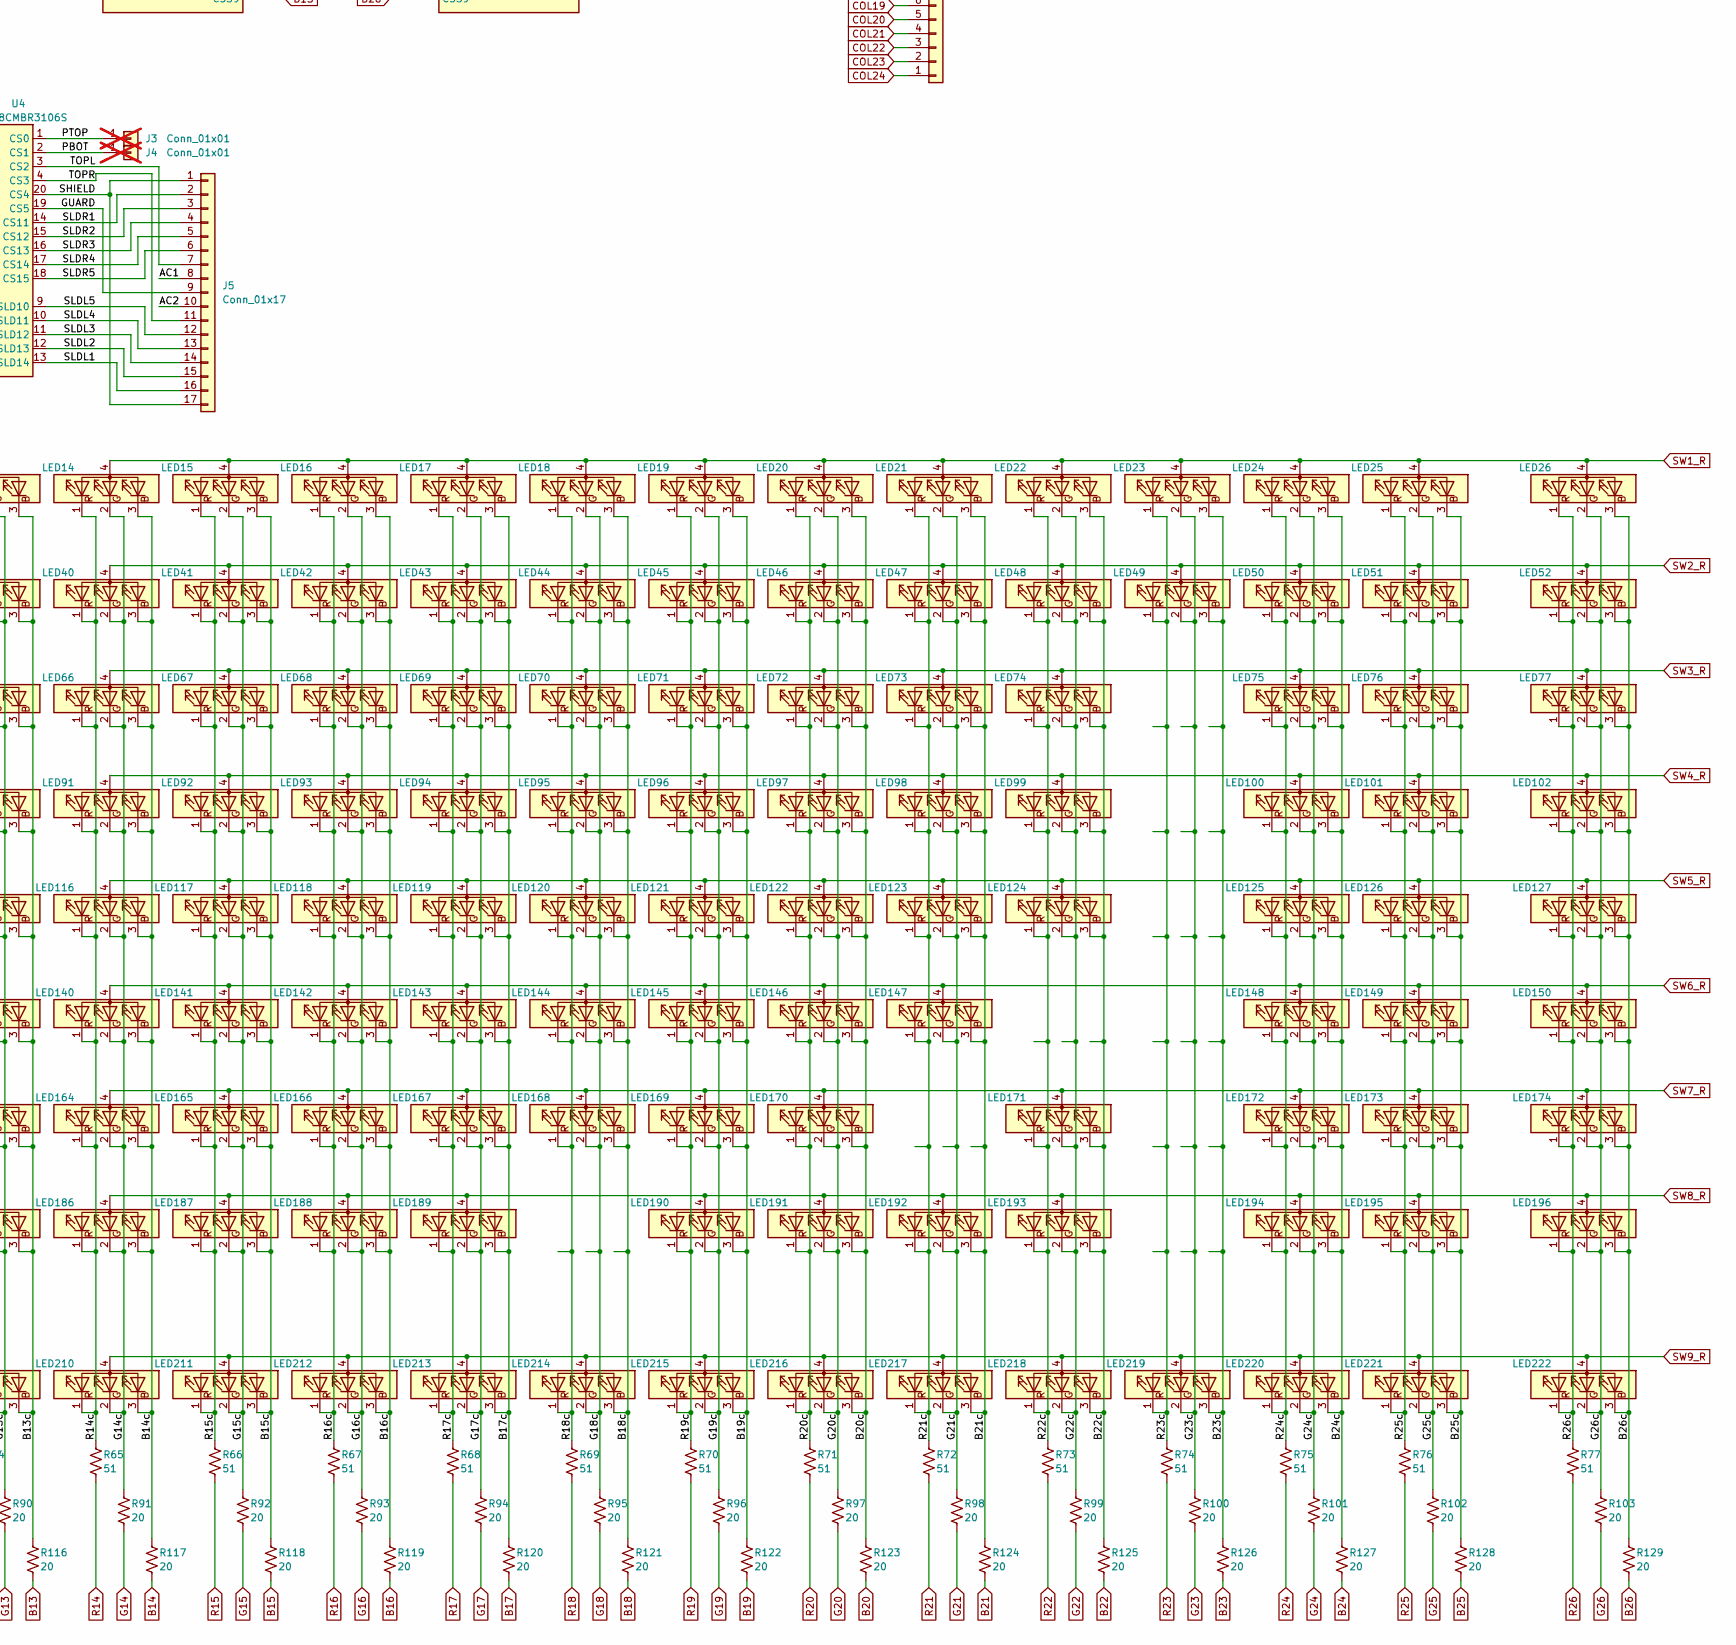
[picture p14: schematic SimulTypeUltraFullMag.kicad_sch, part in row 2, column 2]

Parts:
C1, C2, C3, C4, C5, C6, C7, C8, C9, C10, C11, C12, C13, C14, C15, C16, C17, C18, C19, C20, C21, C22, C23, C24, C25, C26, C27, C28, C29, C30, C31, C32, C33, C34, C35, C36, C37, C38, C39, C40, C41, C42, C43, C44, C45, C46, C47, C48, C49, C50, C51, C52, C53, C54, C55, C56, C57, C58, C59, C60, C61, C62, C63, C64, C65, C66, C67, C68, C69, C70, C71, C72, C73, C74, C75, C76, C77, C78, C79, C80, C81, C82, C83, C84, C85, C86, C87, C88, C89, C90, C91, C92, C93, C94, C95, C96, C97, C98, C99, C100, C101, C102, C103, C104, C105, C106, C107, C108, C109, C110, C111, C112, C113, C114, C115, C116, C117, C118, C119, C120, C121, C122, C123, C124, C125, C126, C127, C128, C129, C130, C131, C132, C133, C134, C135, C136, C137, C138, C139, C140, C141, C142, C143, C144, C145, C146, C147, C148, C149, C150, C151, C152, C153, C154, C155, C156, C157, C158, C159, C160, C161, C162, C163, C164, C165, C166, C167, C168, C169, C170, C171, C172, C173, C174, C175, C176, C194, C196, C198, C200, C203, C204: 0.1u; C_0603_1608Metric; LCSC C1591
C193, C195, C197, C199, C201, C202, C206: 1u; C_0603_1608Metric; LCSC C1592
C205: 5p; C_0603_1608Metric; LCSC C1673
C207: 2.2n; C_0603_1608Metric; LCSC C16033
DRA1: DIN_Rail_Adapter; Stabilizer_Cherry_MX_6.25u; not fitted
DRA2, DRA3, DRA4, DRA5, DRA6, DRA7, DRA8: DIN_Rail_Adapter; Stabilizer_Cherry_MX_2.00u; not fitted
FID1, FID2, FID3, FID4, FID5: Fiducial; Fiducial_1mm_Mask2mm; not fitted
J1: Conn_01x45; TE_4-1734839-5_1x45-1MP_P0.5mm_Horizontal; LCSC C2998867
J2: Qwiic_I2C_connector; JST_SH_SM04B-SRSS-TB_1x04-1MP_P1.00mm_Horizontal; LCSC C7433425
J3, J4: Conn_01x01; SURFACESPRING_1; LCSC C5143821; not fitted
J5: Conn_01x17; Molex_502250-1791_2Rows-17Pins-1MP_P0.60mm_Horizontal; LCSC C3012329
JP1: SolderJumper_2_Open; SolderJumper-2_P1.3mm_Open_RoundedPad1.0x1.5mm; not fitted
LED1, LED26, LED27, LED52, LED53, LED77, LED78, LED102, LED103, LED127, LED128, LED150, LED151, LED174, LED175, LED196, LED197, LED198, LED199, LED200, LED201, LED202, LED203, LED204, LED205, LED206, LED207, LED208, LED209, LED210, LED211, LED212, LED213, LED214, LED215, LED216, LED217, LED218, LED219, LED220, LED221, LED222: ASMB-MTB1-0A3A2; RGBSIDELENS; LCSC C965884
LED2, LED3, LED4, LED5, LED6, LED7, LED8, LED9, LED10, LED11, LED12, LED13, LED14, LED15, LED16, LED17, LED18, LED19, LED20, LED21, LED22, LED23, LED24, LED25, LED28, LED29, LED30, LED31, LED32, LED33, LED34, LED35, LED36, LED37, LED38, LED39, LED40, LED41, LED42, LED43, LED44, LED45, LED46, LED47, LED48, LED49, LED50, LED51, LED54, LED55, LED56, LED57, LED58, LED59, LED60, LED61, LED62, LED63, LED64, LED65, LED66, LED67, LED68, LED69, LED70, LED71, LED72, LED73, LED74, LED75, LED76, LED79, LED80, LED81, LED82, LED83, LED84, LED85, LED86, LED87, LED88, LED89, LED90, LED91, LED92, LED93, LED94, LED95, LED96, LED97, LED98, LED99, LED100, LED101, LED104, LED105, LED106, LED107, LED108, LED109, LED110, LED111, LED112, LED113, LED114, LED115, LED116, LED117, LED118, LED119, LED120, LED121, LED122, LED123, LED124, LED125, LED126, LED129, LED130, LED131, LED132, LED133, LED134, LED135, LED136, LED137, LED138, LED139, LED140, LED141, LED142, LED143, LED144, LED145, LED146, LED147, LED148, LED149, LED152, LED153, LED154, LED155, LED156, LED157, LED158, LED159, LED160, LED161, LED162, LED163, LED164, LED165, LED166, LED167, LED168, LED169, LED170, LED171, LED172, LED173, LED176, LED177, LED178, LED179, LED180, LED181, LED182, LED183, LED184, LED185, LED186, LED187, LED188, LED189, LED190, LED191, LED192, LED193, LED194, LED195: ASMB-MTB1-0A3A2; 6028RGB
Q1, Q2, Q3, Q4, Q5, Q6, Q7, Q8, Q9, Q10, Q11, Q12, Q13, Q14, Q15, Q16, Q17, Q18, Q19, Q20, Q21, Q22, Q23, Q24: Si2371EDS; SOT-23; LCSC C8547
Q25, Q26, Q27, Q28, Q29, Q30, Q31, Q32, Q33, Q34, Q35, Q36, Q37, Q38, Q39, Q40, Q41, Q42, Q43, Q44, Q45, Q46, Q47, Q48: BC849; SOT-23; LCSC C2145
R1, R2, R3, R4, R5, R6, R7, R8, R9, R10, R11, R12, R13, R14, R15, R16, R17, R18, R19, R20, R21, R22, R23, R24, R25, R26, R27, R28, R29, R30, R31, R32, R33, R34, R35, R36, R37, R38, R39, R40, R41, R42, R43, R44, R45, R46, R47, R48: 10k; R_0603_1608Metric; LCSC C2930027
R49, R50, R51: 10k; R_0402_1005Metric; LCSC C25744
R52, R53, R54, R55, R56, R57, R58, R59, R60, R61, R62, R63, R64, R65, R66, R67, R68, R69, R70, R71, R72, R73, R74, R75, R76, R77: 51; R_0402_1005Metric; LCSC C25125
R78, R79, R80, R81, R82, R83, R84, R85, R86, R87, R88, R89, R90, R91, R92, R93, R94, R95, R96, R97, R98, R99, R100, R101, R102, R103, R104, R105, R106, R107, R108, R109, R110, R111, R112, R113, R114, R115, R116, R117, R118, R119, R120, R121, R122, R123, R124, R125, R126, R127, R128, R129: 20; R_0402_1005Metric; LCSC C25089
SW1, SW2, SW3, SW4, SW5, SW6, SW7, SW8, SW9, SW10, SW11, SW12, SW13, SW14, SW15, SW16, SW17, SW18, SW19, SW20, SW21, SW22, SW23, SW24, SW25, SW26, SW27, SW28, SW29, SW30, SW31, SW32, SW33, SW34, SW35, SW36, SW37, SW38, SW39, SW40, SW41, SW42, SW43, SW44, SW45, SW46, SW47, SW48, SW49, SW50, SW51, SW52, SW53, SW54, SW55, SW56, SW57, SW58, SW59, SW60, SW61, SW62, SW63, SW64, SW65, SW66, SW67, SW68, SW69, SW70, SW71, SW72, SW73, SW74, SW75, SW76, SW77, SW78, SW79, SW80, SW81, SW82, SW83, SW84, SW85, SW86, SW87, SW88, SW89, SW90, SW91, SW92, SW93, SW94, SW95, SW96, SW97, SW98, SW99, SW100, SW101, SW102, SW103, SW104, SW105, SW106, SW107, SW108, SW109, SW110, SW111, SW112, SW113, SW114, SW115, SW116, SW117, SW118, SW119, SW120, SW121, SW122, SW123, SW124, SW125, SW126, SW127, SW128, SW129, SW130, SW131, SW132, SW133, SW134, SW135, SW136, SW137, SW138, SW139, SW140, SW141, SW142, SW143, SW144, SW145, SW146, SW147, SW148, SW149, SW150, SW151, SW152, SW153, SW154, SW155, SW156, SW157, SW158, SW159, SW160, SW161, SW162, SW163, SW164, SW165, SW166, SW167, SW168, SW169, SW170, SW171, SW172, SW173, SW174, SW175, SW176: SW_GATERON_MAG_ANALOG_1.00u
TP1, TP2, TP3, TP4, TP5, TP6: TestPoint; TestPoint_Pad_D4.0mm; not fitted
TP7: TestPoint; TestPoint_Pad_2.0x2.0mm; not fitted
U1, U2: IS31FL3741; QFN-60-1EP_7x7mm_P0.4mm_EP5x5mm; LCSC C2940604
U3: ST25DV; DFN-12-1EP_3x3mm_P0.5mm_EP1.4x2.55mm; LCSC C2654815
U4: CY8CMBR3106S; QFN-24-1EP_4x4mm_P0.5mm_EP2.6x2.6mm; LCSC C2952476
U5: 24AA02-OT; SOT-23-5; LCSC C5263778

Connections:
+3.3V: C201.1, C202.1, C203.1, C206.1, J1.28, J2.2 (VCC), Q1.2 (S), Q2.2 (S), Q3.2 (S), Q4.2 (S), Q5.2 (S), Q6.2 (S), Q7.2 (S), Q8.2 (S), Q9.2 (S), Q10.2 (S), Q11.2 (S), Q12.2 (S), Q13.2 (S), Q14.2 (S), Q15.2 (S), Q16.2 (S), Q17.2 (S), Q18.2 (S), Q19.2 (S), Q20.2 (S), Q21.2 (S), Q22.2 (S), Q23.2 (S), Q24.2 (S), R1.1, R2.1, R3.1, R4.1, R5.1, R6.1, R7.1, R8.1, R9.1, R10.1, R11.1, R12.1, R13.1, R14.1, R15.1, R16.1, R17.1, R18.1, R19.1, R20.1, R21.1, R22.1, R23.1, R24.1, R51.1, TP2.1, U3.10 (Vdcg), U3.12 (VDD), U4.7 (VDD), U5.4 (V_{CC})
+5V: C193.1, C194.1, C195.1, C196.1, C197.1, C198.1, C199.1, C200.1, J1.29, J1.30, J1.31, TP1.1, U1.14 (AVCC), U1.15 (PVCC), U1.25 (PVCC), U2.8 (ADDR), U2.14 (AVCC), U2.15 (PVCC), U2.25 (PVCC)
AC1: C205.1, J5.8, U3.4 (AC0)
AC2: C205.2, J5.10, U3.5 (AC1)
APACLK: J1.32
APANEODAT: J1.33
B1: R104.2, U1.28 (CS03)
B1c: LED1.3 (BK), LED27.3 (BK), LED53.3 (BK), LED78.3 (BK), LED103.3 (BK), LED128.3 (BK), LED151.3 (BK), LED175.3 (BK), LED197.3 (BK), R104.1
B2: R105.2, U1.31 (CS06)
B2c: LED2.3 (BK), LED28.3 (BK), LED54.3 (BK), LED79.3 (BK), LED104.3 (BK), LED129.3 (BK), LED152.3 (BK), LED176.3 (BK), LED198.3 (BK), R105.1
B3: R106.2, U1.34 (CS09)
B3c: LED3.3 (BK), LED29.3 (BK), LED55.3 (BK), LED80.3 (BK), LED105.3 (BK), LED130.3 (BK), LED153.3 (BK), LED177.3 (BK), LED199.3 (BK), R106.1
B4: R107.2, U1.38 (CS12)
B4c: LED4.3 (BK), LED30.3 (BK), LED56.3 (BK), LED81.3 (BK), LED106.3 (BK), LED131.3 (BK), LED154.3 (BK), LED178.3 (BK), LED200.3 (BK), R107.1
B5: R108.2, U1.41 (CS15)
B5c: LED5.3 (BK), LED31.3 (BK), LED57.3 (BK), LED82.3 (BK), LED107.3 (BK), LED132.3 (BK), LED155.3 (BK), LED179.3 (BK), LED201.3 (BK), R108.1
B6: R109.2, U1.44 (CS18)
B6c: LED6.3 (BK), LED32.3 (BK), LED58.3 (BK), LED83.3 (BK), LED108.3 (BK), LED156.3 (BK), LED202.3 (BK), R109.1
B7: R110.2, U1.47 (CS21)
B7c: LED7.3 (BK), LED33.3 (BK), LED59.3 (BK), LED84.3 (BK), LED109.3 (BK), LED133.3 (BK), LED157.3 (BK), LED180.3 (BK), LED203.3 (BK), R110.1
B8: R111.2, U1.50 (CS24)
B8c: LED8.3 (BK), LED34.3 (BK), LED60.3 (BK), LED85.3 (BK), LED110.3 (BK), LED134.3 (BK), LED158.3 (BK), LED181.3 (BK), LED204.3 (BK), R111.1
B9: R112.2, U1.53 (CS27)
B9c: LED9.3 (BK), LED35.3 (BK), LED61.3 (BK), LED86.3 (BK), LED111.3 (BK), LED135.3 (BK), LED159.3 (BK), LED205.3 (BK), R112.1
B10: R113.2, U1.57 (CS30)
B10c: LED10.3 (BK), LED36.3 (BK), LED62.3 (BK), LED87.3 (BK), LED112.3 (BK), LED136.3 (BK), LED160.3 (BK), LED182.3 (BK), LED206.3 (BK), R113.1
B11: R114.2, U1.60 (CS33)
B11c: LED11.3 (BK), LED37.3 (BK), LED63.3 (BK), LED88.3 (BK), LED113.3 (BK), LED137.3 (BK), LED161.3 (BK), LED183.3 (BK), LED207.3 (BK), R114.1
B12: R115.2, U1.3 (CS36)
B12c: LED12.3 (BK), LED38.3 (BK), LED64.3 (BK), LED89.3 (BK), LED114.3 (BK), LED138.3 (BK), LED162.3 (BK), LED184.3 (BK), LED208.3 (BK), R115.1
B13: R116.2, U1.6 (CS39)
B13c: LED13.3 (BK), LED39.3 (BK), LED65.3 (BK), LED90.3 (BK), LED115.3 (BK), LED139.3 (BK), LED163.3 (BK), LED185.3 (BK), LED209.3 (BK), R116.1
B14: R117.2, U2.28 (CS03)
B14c: LED14.3 (BK), LED40.3 (BK), LED66.3 (BK), LED91.3 (BK), LED116.3 (BK), LED140.3 (BK), LED164.3 (BK), LED186.3 (BK), LED210.3 (BK), R117.1
B15: R118.2, U2.31 (CS06)
B15c: LED15.3 (BK), LED41.3 (BK), LED67.3 (BK), LED92.3 (BK), LED117.3 (BK), LED141.3 (BK), LED165.3 (BK), LED187.3 (BK), LED211.3 (BK), R118.1
B16: R119.2, U2.34 (CS09)
B16c: LED16.3 (BK), LED42.3 (BK), LED68.3 (BK), LED93.3 (BK), LED118.3 (BK), LED142.3 (BK), LED166.3 (BK), LED188.3 (BK), LED212.3 (BK), R119.1
B17: R120.2, U2.38 (CS12)
B17c: LED17.3 (BK), LED43.3 (BK), LED69.3 (BK), LED94.3 (BK), LED119.3 (BK), LED143.3 (BK), LED167.3 (BK), LED189.3 (BK), LED213.3 (BK), R120.1
B18: R121.2, U2.41 (CS15)
B18c: LED18.3 (BK), LED44.3 (BK), LED70.3 (BK), LED95.3 (BK), LED120.3 (BK), LED144.3 (BK), LED168.3 (BK), LED214.3 (BK), R121.1
B19: R122.2, U2.44 (CS18)
B19c: LED19.3 (BK), LED45.3 (BK), LED71.3 (BK), LED96.3 (BK), LED121.3 (BK), LED145.3 (BK), LED169.3 (BK), LED190.3 (BK), LED215.3 (BK), R122.1
B20: R123.2, U2.47 (CS21)
B20c: LED20.3 (BK), LED46.3 (BK), LED72.3 (BK), LED97.3 (BK), LED122.3 (BK), LED146.3 (BK), LED170.3 (BK), LED191.3 (BK), LED216.3 (BK), R123.1
B21: R124.2, U2.50 (CS24)
B21c: LED21.3 (BK), LED47.3 (BK), LED73.3 (BK), LED98.3 (BK), LED123.3 (BK), LED147.3 (BK), LED192.3 (BK), LED217.3 (BK), R124.1
B22: R125.2, U2.53 (CS27)
B22c: LED22.3 (BK), LED48.3 (BK), LED74.3 (BK), LED99.3 (BK), LED124.3 (BK), LED171.3 (BK), LED193.3 (BK), LED218.3 (BK), R125.1
B23: R126.2, U2.57 (CS30)
B23c: LED23.3 (BK), LED49.3 (BK), LED219.3 (BK), R126.1
B24: R127.2, U2.60 (CS33)
B24c: LED24.3 (BK), LED50.3 (BK), LED75.3 (BK), LED100.3 (BK), LED125.3 (BK), LED148.3 (BK), LED172.3 (BK), LED194.3 (BK), LED220.3 (BK), R127.1
B25: R128.2, U2.3 (CS36)
B25c: LED25.3 (BK), LED51.3 (BK), LED76.3 (BK), LED101.3 (BK), LED126.3 (BK), LED149.3 (BK), LED173.3 (BK), LED195.3 (BK), LED221.3 (BK), R128.1
B26: R129.2, U2.6 (CS39)
B26c: LED26.3 (BK), LED52.3 (BK), LED77.3 (BK), LED102.3 (BK), LED127.3 (BK), LED150.3 (BK), LED174.3 (BK), LED196.3 (BK), LED222.3 (BK), R129.1
COL1: J1.45, R48.2
COL2: J1.44, R47.2
COL3: J1.43, R46.2
COL4: J1.42, R45.2
COL5: J1.41, R44.2
COL6: J1.40, R43.2
COL7: J1.39, R42.2
COL8: J1.38, R41.2
COL9: J1.16, R40.2
COL10: J1.15, R39.2
COL11: J1.14, R38.2
COL12: J1.13, R37.2
COL13: J1.12, R36.2
COL14: J1.11, R35.2
COL15: J1.10, R34.2
COL16: J1.9, R33.2
COL17: J1.8, R32.2
COL18: J1.7, R31.2
COL19: J1.6, R30.2
COL20: J1.5, R29.2
COL21: J1.4, R28.2
COL22: J1.3, R27.2
COL23: J1.2, R26.2
COL24: J1.1, R25.2
G1: R78.2, U1.27 (CS02)
G1c: LED1.2 (GK), LED27.2 (GK), LED53.2 (GK), LED78.2 (GK), LED103.2 (GK), LED128.2 (GK), LED151.2 (GK), LED175.2 (GK), LED197.2 (GK), R78.1
G2: R79.2, U1.30 (CS05)
G2c: LED2.2 (GK), LED28.2 (GK), LED54.2 (GK), LED79.2 (GK), LED104.2 (GK), LED129.2 (GK), LED152.2 (GK), LED176.2 (GK), LED198.2 (GK), R79.1
G3: R80.2, U1.33 (CS08)
G3c: LED3.2 (GK), LED29.2 (GK), LED55.2 (GK), LED80.2 (GK), LED105.2 (GK), LED130.2 (GK), LED153.2 (GK), LED177.2 (GK), LED199.2 (GK), R80.1
G4: R81.2, U1.37 (CS11)
G4c: LED4.2 (GK), LED30.2 (GK), LED56.2 (GK), LED81.2 (GK), LED106.2 (GK), LED131.2 (GK), LED154.2 (GK), LED178.2 (GK), LED200.2 (GK), R81.1
G5: R82.2, U1.40 (CS14)
G5c: LED5.2 (GK), LED31.2 (GK), LED57.2 (GK), LED82.2 (GK), LED107.2 (GK), LED132.2 (GK), LED155.2 (GK), LED179.2 (GK), LED201.2 (GK), R82.1
G6: R83.2, U1.43 (CS17)
G6c: LED6.2 (GK), LED32.2 (GK), LED58.2 (GK), LED83.2 (GK), LED108.2 (GK), LED156.2 (GK), LED202.2 (GK), R83.1
G7: R84.2, U1.46 (CS20)
G7c: LED7.2 (GK), LED33.2 (GK), LED59.2 (GK), LED84.2 (GK), LED109.2 (GK), LED133.2 (GK), LED157.2 (GK), LED180.2 (GK), LED203.2 (GK), R84.1
G8: R85.2, U1.49 (CS23)
G8c: LED8.2 (GK), LED34.2 (GK), LED60.2 (GK), LED85.2 (GK), LED110.2 (GK), LED134.2 (GK), LED158.2 (GK), LED181.2 (GK), LED204.2 (GK), R85.1
G9: R86.2, U1.52 (CS26)
G9c: LED9.2 (GK), LED35.2 (GK), LED61.2 (GK), LED86.2 (GK), LED111.2 (GK), LED135.2 (GK), LED159.2 (GK), LED205.2 (GK), R86.1
G10: R87.2, U1.56 (CS29)
G10c: LED10.2 (GK), LED36.2 (GK), LED62.2 (GK), LED87.2 (GK), LED112.2 (GK), LED136.2 (GK), LED160.2 (GK), LED182.2 (GK), LED206.2 (GK), R87.1
G11: R88.2, U1.59 (CS32)
G11c: LED11.2 (GK), LED37.2 (GK), LED63.2 (GK), LED88.2 (GK), LED113.2 (GK), LED137.2 (GK), LED161.2 (GK), LED183.2 (GK), LED207.2 (GK), R88.1
G12: R89.2, U1.2 (CS35)
G12c: LED12.2 (GK), LED38.2 (GK), LED64.2 (GK), LED89.2 (GK), LED114.2 (GK), LED138.2 (GK), LED162.2 (GK), LED184.2 (GK), LED208.2 (GK), R89.1
G13: R90.2, U1.5 (CS38)
G13c: LED13.2 (GK), LED39.2 (GK), LED65.2 (GK), LED90.2 (GK), LED115.2 (GK), LED139.2 (GK), LED163.2 (GK), LED185.2 (GK), LED209.2 (GK), R90.1
G14: R91.2, U2.27 (CS02)
G14c: LED14.2 (GK), LED40.2 (GK), LED66.2 (GK), LED91.2 (GK), LED116.2 (GK), LED140.2 (GK), LED164.2 (GK), LED186.2 (GK), LED210.2 (GK), R91.1
G15: R92.2, U2.30 (CS05)
G15c: LED15.2 (GK), LED41.2 (GK), LED67.2 (GK), LED92.2 (GK), LED117.2 (GK), LED141.2 (GK), LED165.2 (GK), LED187.2 (GK), LED211.2 (GK), R92.1
G16: R93.2, U2.33 (CS08)
G16c: LED16.2 (GK), LED42.2 (GK), LED68.2 (GK), LED93.2 (GK), LED118.2 (GK), LED142.2 (GK), LED166.2 (GK), LED188.2 (GK), LED212.2 (GK), R93.1
G17: R94.2, U2.37 (CS11)
G17c: LED17.2 (GK), LED43.2 (GK), LED69.2 (GK), LED94.2 (GK), LED119.2 (GK), LED143.2 (GK), LED167.2 (GK), LED189.2 (GK), LED213.2 (GK), R94.1
G18: R95.2, U2.40 (CS14)
G18c: LED18.2 (GK), LED44.2 (GK), LED70.2 (GK), LED95.2 (GK), LED120.2 (GK), LED144.2 (GK), LED168.2 (GK), LED214.2 (GK), R95.1
G19: R96.2, U2.43 (CS17)
G19c: LED19.2 (GK), LED45.2 (GK), LED71.2 (GK), LED96.2 (GK), LED121.2 (GK), LED145.2 (GK), LED169.2 (GK), LED190.2 (GK), LED215.2 (GK), R96.1
G20: R97.2, U2.46 (CS20)
G20c: LED20.2 (GK), LED46.2 (GK), LED72.2 (GK), LED97.2 (GK), LED122.2 (GK), LED146.2 (GK), LED170.2 (GK), LED191.2 (GK), LED216.2 (GK), R97.1
G21: R98.2, U2.49 (CS23)
G21c: LED21.2 (GK), LED47.2 (GK), LED73.2 (GK), LED98.2 (GK), LED123.2 (GK), LED147.2 (GK), LED192.2 (GK), LED217.2 (GK), R98.1
G22: R99.2, U2.52 (CS26)
G22c: LED22.2 (GK), LED48.2 (GK), LED74.2 (GK), LED99.2 (GK), LED124.2 (GK), LED171.2 (GK), LED193.2 (GK), LED218.2 (GK), R99.1
G23: R100.2, U2.56 (CS29)
G23c: LED23.2 (GK), LED49.2 (GK), LED219.2 (GK), R100.1
G24: R101.2, U2.59 (CS32)
G24c: LED24.2 (GK), LED50.2 (GK), LED75.2 (GK), LED100.2 (GK), LED125.2 (GK), LED148.2 (GK), LED172.2 (GK), LED194.2 (GK), LED220.2 (GK), R101.1
G25: R102.2, U2.2 (CS35)
G25c: LED25.2 (GK), LED51.2 (GK), LED76.2 (GK), LED101.2 (GK), LED126.2 (GK), LED149.2 (GK), LED173.2 (GK), LED195.2 (GK), LED221.2 (GK), R102.1
G26: R103.2, U2.5 (CS38)
G26c: LED26.2 (GK), LED52.2 (GK), LED77.2 (GK), LED102.2 (GK), LED127.2 (GK), LED150.2 (GK), LED174.2 (GK), LED196.2 (GK), LED222.2 (GK), R103.1
GND: C1.2, C2.2, C3.2, C4.2, C5.2, C6.2, C7.2, C8.2, C9.2, C10.2, C11.2, C12.2, C13.2, C14.2, C15.2, C16.2, C17.2, C18.2, C19.2, C20.2, C21.2, C22.2, C23.2, C24.2, C25.2, C26.2, C27.2, C28.2, C29.2, C30.2, C31.2, C32.2, C33.2, C34.2, C35.2, C36.2, C37.2, C38.2, C39.2, C40.2, C41.2, C42.2, C43.2, C44.2, C45.2, C46.2, C47.2, C48.2, C49.2, C50.2, C51.2, C52.2, C53.2, C54.2, C55.2, C56.2, C57.2, C58.2, C59.2, C60.2, C61.2, C62.2, C63.2, C64.2, C65.2, C66.2, C67.2, C68.2, C69.2, C70.2, C71.2, C72.2, C73.2, C74.2, C75.2, C76.2, C77.2, C78.2, C79.2, C80.2, C81.2, C82.2, C83.2, C84.2, C85.2, C86.2, C87.2, C88.2, C89.2, C90.2, C91.2, C92.2, C93.2, C94.2, C95.2, C96.2, C97.2, C98.2, C99.2, C100.2, C101.2, C102.2, C103.2, C104.2, C105.2, C106.2, C107.2, C108.2, C109.2, C110.2, C111.2, C112.2, C113.2, C114.2, C115.2, C116.2, C117.2, C118.2, C119.2, C120.2, C121.2, C122.2, C123.2, C124.2, C125.2, C126.2, C127.2, C128.2, C129.2, C130.2, C131.2, C132.2, C133.2, C134.2, C135.2, C136.2, C137.2, C138.2, C139.2, C140.2, C141.2, C142.2, C143.2, C144.2, C145.2, C146.2, C147.2, C148.2, C149.2, C150.2, C151.2, C152.2, C153.2, C154.2, C155.2, C156.2, C157.2, C158.2, C159.2, C160.2, C161.2, C162.2, C163.2, C164.2, C165.2, C166.2, C167.2, C168.2, C169.2, C170.2, C171.2, C172.2, C173.2, C174.2, C175.2, C176.2, C193.2, C194.2, C195.2, C196.2, C197.2, C198.2, C199.2, C200.2, C201.2, C202.2, C203.2, C204.1, C206.2, C207.2, J1.25, J1.26, J1.27, J2.1 (GND), J2.MP (VSS), JP1.2 (B), Q25.2 (E), Q26.2 (E), Q27.2 (E), Q28.2 (E), Q29.2 (E), Q30.2 (E), Q31.2 (E), Q32.2 (E), Q33.2 (E), Q34.2 (E), Q35.2 (E), Q36.2 (E), Q37.2 (E), Q38.2 (E), Q39.2 (E), Q40.2 (E), Q41.2 (E), Q42.2 (E), Q43.2 (E), Q44.2 (E), Q45.2 (E), Q46.2 (E), Q47.2 (E), Q48.2 (E), R49.1, R50.2, SW1.3 (GND), SW2.3 (GND), SW3.3 (GND), SW4.3 (GND), SW5.3 (GND), SW6.3 (GND), SW7.3 (GND), SW8.3 (GND), SW9.3 (GND), SW10.3 (GND), SW11.3 (GND), SW12.3 (GND), SW13.3 (GND), SW14.3 (GND), SW15.3 (GND), SW16.3 (GND), SW17.3 (GND), SW18.3 (GND), SW19.3 (GND), SW20.3 (GND), SW21.3 (GND), SW22.3 (GND), SW23.3 (GND), SW24.3 (GND), SW25.3 (GND), SW26.3 (GND), SW27.3 (GND), SW28.3 (GND), SW29.3 (GND), SW30.3 (GND), SW31.3 (GND), SW32.3 (GND), SW33.3 (GND), SW34.3 (GND), SW35.3 (GND), SW36.3 (GND), SW37.3 (GND), SW38.3 (GND), SW39.3 (GND), SW40.3 (GND), SW41.3 (GND), SW42.3 (GND), SW43.3 (GND), SW44.3 (GND), SW45.3 (GND), SW46.3 (GND), SW47.3 (GND), SW48.3 (GND), SW49.3 (GND), SW50.3 (GND), SW51.3 (GND), SW52.3 (GND), SW53.3 (GND), SW54.3 (GND), SW55.3 (GND), SW56.3 (GND), SW57.3 (GND), SW58.3 (GND), SW59.3 (GND), SW60.3 (GND), SW61.3 (GND), SW62.3 (GND), SW63.3 (GND), SW64.3 (GND), SW65.3 (GND), SW66.3 (GND), SW67.3 (GND), SW68.3 (GND), SW69.3 (GND), SW70.3 (GND), SW71.3 (GND), SW72.3 (GND), SW73.3 (GND), SW74.3 (GND), SW75.3 (GND), SW76.3 (GND), SW77.3 (GND), SW78.3 (GND), SW79.3 (GND), SW80.3 (GND), SW81.3 (GND), SW82.3 (GND), SW83.3 (GND), SW84.3 (GND), SW85.3 (GND), SW86.3 (GND), SW87.3 (GND), SW88.3 (GND), SW89.3 (GND), SW90.3 (GND), SW91.3 (GND), SW92.3 (GND), SW93.3 (GND), SW94.3 (GND), SW95.3 (GND), SW96.3 (GND), SW97.3 (GND), SW98.3 (GND), SW99.3 (GND), SW100.3 (GND), SW101.3 (GND), SW102.3 (GND), SW103.3 (GND), SW104.3 (GND), SW105.3 (GND), SW106.3 (GND), SW107.3 (GND), SW108.3 (GND), SW109.3 (GND), SW110.3 (GND), SW111.3 (GND), SW112.3 (GND), SW113.3 (GND), SW114.3 (GND), SW115.3 (GND), SW116.3 (GND), SW117.3 (GND), SW118.3 (GND), SW119.3 (GND), SW120.3 (GND), SW121.3 (GND), SW122.3 (GND), SW123.3 (GND), SW124.3 (GND), SW125.3 (GND), SW126.3 (GND), SW127.3 (GND), SW128.3 (GND), SW129.3 (GND), SW130.3 (GND), SW131.3 (GND), SW132.3 (GND), SW133.3 (GND), SW134.3 (GND), SW135.3 (GND), SW136.3 (GND), SW137.3 (GND), SW138.3 (GND), SW139.3 (GND), SW140.3 (GND), SW141.3 (GND), SW142.3 (GND), SW143.3 (GND), SW144.3 (GND), SW145.3 (GND), SW146.3 (GND), SW147.3 (GND), SW148.3 (GND), SW149.3 (GND), SW150.3 (GND), SW151.3 (GND), SW152.3 (GND), SW153.3 (GND), SW154.3 (GND), SW155.3 (GND), SW156.3 (GND), SW157.3 (GND), SW158.3 (GND), SW159.3 (GND), SW160.3 (GND), SW161.3 (GND), SW162.3 (GND), SW163.3 (GND), SW164.3 (GND), SW165.3 (GND), SW166.3 (GND), SW167.3 (GND), SW168.3 (GND), SW169.3 (GND), SW170.3 (GND), SW171.3 (GND), SW172.3 (GND), SW173.3 (GND), SW174.3 (GND), SW175.3 (GND), SW176.3 (GND), TP6.1, U1.8 (ADDR), U1.12 (GND), U1.36 (GND), U1.55 (GND), U1.EP (GND), U2.12 (GND), U2.36 (GND), U2.55 (GND), U2.EP (GND), U3.6 (VSS), U3.13 (VSS), U4.8 (VSS), U4.25 (EP), U5.2 (V_{SS})
GUARD: J5.9, U4.19 (CS5)
INT: J1.36, TP7.1, U1.7 (INTB), U2.7 (INTB), U3.11 (GPO), U4.23 (~HI)
ISETL: R49.2, U1.13 (R_EXT)
ISETR: R50.1, U2.13 (R_EXT)
LEDOFF: J1.37, U1.11 (SDB), U2.11 (SDB)
unnamed: C1.1, C25.1, C49.1, C72.1, C95.1, C118.1, C139.1, C161.1, Q1.3 (D), SW1.1 (VCC), SW25.1 (VCC), SW49.1 (VCC), SW72.1 (VCC), SW95.1 (VCC), SW118.1 (VCC), SW139.1 (VCC), SW161.1 (VCC)
unnamed: C10.1, C34.1, C58.1, C81.1, C104.1, C126.1, C148.1, C168.1, Q10.3 (D), SW10.1 (VCC), SW34.1 (VCC), SW58.1 (VCC), SW81.1 (VCC), SW104.1 (VCC), SW126.1 (VCC), SW148.1 (VCC), SW168.1 (VCC)
unnamed: C22.1, C46.1, Q22.3 (D), SW22.1 (VCC), SW46.1 (VCC)
unnamed: C6.1, C30.1, C54.1, C77.1, C100.1, C122.1, C144.1, C165.1, Q6.3 (D), SW6.1 (VCC), SW30.1 (VCC), SW54.1 (VCC), SW77.1 (VCC), SW100.1 (VCC), SW122.1 (VCC), SW144.1 (VCC), SW165.1 (VCC)
unnamed: C7.1, C31.1, C55.1, C78.1, C101.1, C123.1, C145.1, C166.1, Q7.3 (D), SW7.1 (VCC), SW31.1 (VCC), SW55.1 (VCC), SW78.1 (VCC), SW101.1 (VCC), SW123.1 (VCC), SW145.1 (VCC), SW166.1 (VCC)
unnamed: C8.1, C32.1, C56.1, C79.1, C102.1, C124.1, C146.1, Q8.3 (D), SW8.1 (VCC), SW32.1 (VCC), SW56.1 (VCC), SW79.1 (VCC), SW102.1 (VCC), SW124.1 (VCC), SW146.1 (VCC)
unnamed: C9.1, C33.1, C57.1, C80.1, C103.1, C125.1, C147.1, C167.1, Q9.3 (D), SW9.1 (VCC), SW33.1 (VCC), SW57.1 (VCC), SW80.1 (VCC), SW103.1 (VCC), SW125.1 (VCC), SW147.1 (VCC), SW167.1 (VCC)
unnamed: C11.1, C35.1, C59.1, C82.1, C105.1, C127.1, C149.1, C169.1, Q11.3 (D), SW11.1 (VCC), SW35.1 (VCC), SW59.1 (VCC), SW82.1 (VCC), SW105.1 (VCC), SW127.1 (VCC), SW149.1 (VCC), SW169.1 (VCC)
unnamed: C12.1, C36.1, C60.1, C83.1, C106.1, C128.1, C150.1, Q12.3 (D), SW12.1 (VCC), SW36.1 (VCC), SW60.1 (VCC), SW83.1 (VCC), SW106.1 (VCC), SW128.1 (VCC), SW150.1 (VCC)
unnamed: C13.1, C37.1, C61.1, C84.1, C107.1, C129.1, C151.1, Q13.3 (D), SW13.1 (VCC), SW37.1 (VCC), SW61.1 (VCC), SW84.1 (VCC), SW107.1 (VCC), SW129.1 (VCC), SW151.1 (VCC)
unnamed: C14.1, C38.1, C62.1, C85.1, C108.1, C130.1, C152.1, C170.1, Q14.3 (D), SW14.1 (VCC), SW38.1 (VCC), SW62.1 (VCC), SW85.1 (VCC), SW108.1 (VCC), SW130.1 (VCC), SW152.1 (VCC), SW170.1 (VCC)
unnamed: C15.1, C39.1, C63.1, C86.1, C109.1, C131.1, C153.1, Q15.3 (D), SW15.1 (VCC), SW39.1 (VCC), SW63.1 (VCC), SW86.1 (VCC), SW109.1 (VCC), SW131.1 (VCC), SW153.1 (VCC)
unnamed: C16.1, C40.1, C64.1, C87.1, C110.1, C132.1, C154.1, Q16.3 (D), SW16.1 (VCC), SW40.1 (VCC), SW64.1 (VCC), SW87.1 (VCC), SW110.1 (VCC), SW132.1 (VCC), SW154.1 (VCC)
unnamed: C17.1, C41.1, C65.1, C88.1, C111.1, C133.1, C155.1, Q17.3 (D), SW17.1 (VCC), SW41.1 (VCC), SW65.1 (VCC), SW88.1 (VCC), SW111.1 (VCC), SW133.1 (VCC), SW155.1 (VCC)
unnamed: C18.1, C42.1, C66.1, C89.1, C112.1, C134.1, C156.1, C171.1, Q18.3 (D), SW18.1 (VCC), SW42.1 (VCC), SW66.1 (VCC), SW89.1 (VCC), SW112.1 (VCC), SW134.1 (VCC), SW156.1 (VCC), SW171.1 (VCC)
unnamed: C19.1, C43.1, C67.1, C90.1, C113.1, C135.1, C157.1, C172.1, Q19.3 (D), SW19.1 (VCC), SW43.1 (VCC), SW67.1 (VCC), SW90.1 (VCC), SW113.1 (VCC), SW135.1 (VCC), SW157.1 (VCC), SW172.1 (VCC)
unnamed: C20.1, C44.1, C68.1, C91.1, C114.1, C136.1, C173.1, Q20.3 (D), SW20.1 (VCC), SW44.1 (VCC), SW68.1 (VCC), SW91.1 (VCC), SW114.1 (VCC), SW136.1 (VCC), SW173.1 (VCC)
unnamed: C21.1, C45.1, C69.1, C92.1, C115.1, C158.1, C174.1, Q21.3 (D), SW21.1 (VCC), SW45.1 (VCC), SW69.1 (VCC), SW92.1 (VCC), SW115.1 (VCC), SW158.1 (VCC), SW174.1 (VCC)
unnamed: C23.1, C47.1, C70.1, C93.1, C116.1, C137.1, C159.1, C175.1, Q23.3 (D), SW23.1 (VCC), SW47.1 (VCC), SW70.1 (VCC), SW93.1 (VCC), SW116.1 (VCC), SW137.1 (VCC), SW159.1 (VCC), SW175.1 (VCC)
unnamed: C24.1, C48.1, C71.1, C94.1, C117.1, C138.1, C160.1, C176.1, Q24.3 (D), SW24.1 (VCC), SW48.1 (VCC), SW71.1 (VCC), SW94.1 (VCC), SW117.1 (VCC), SW138.1 (VCC), SW160.1 (VCC), SW176.1 (VCC)
unnamed: C2.1, C26.1, C50.1, C73.1, C96.1, C119.1, C140.1, C162.1, Q2.3 (D), SW2.1 (VCC), SW26.1 (VCC), SW50.1 (VCC), SW73.1 (VCC), SW96.1 (VCC), SW119.1 (VCC), SW140.1 (VCC), SW162.1 (VCC)
unnamed: C3.1, C27.1, C51.1, C74.1, C97.1, C120.1, C141.1, C163.1, Q3.3 (D), SW3.1 (VCC), SW27.1 (VCC), SW51.1 (VCC), SW74.1 (VCC), SW97.1 (VCC), SW120.1 (VCC), SW141.1 (VCC), SW163.1 (VCC)
unnamed: C4.1, C28.1, C52.1, C75.1, C98.1, C121.1, C142.1, C164.1, Q4.3 (D), SW4.1 (VCC), SW28.1 (VCC), SW52.1 (VCC), SW75.1 (VCC), SW98.1 (VCC), SW121.1 (VCC), SW142.1 (VCC), SW164.1 (VCC)
unnamed: C5.1, C29.1, C53.1, C76.1, C99.1, C143.1, Q5.3 (D), SW5.1 (VCC), SW29.1 (VCC), SW53.1 (VCC), SW76.1 (VCC), SW99.1 (VCC), SW143.1 (VCC)
unnamed: C204.2, U4.6 (VCC)
unnamed: C207.1, U4.5 (CMOD)
unnamed: Q1.1 (G), Q25.3 (C), R1.2
unnamed: Q2.1 (G), Q26.3 (C), R2.2
unnamed: Q10.1 (G), Q34.3 (C), R10.2
unnamed: Q11.1 (G), Q35.3 (C), R11.2
unnamed: Q12.1 (G), Q36.3 (C), R12.2
unnamed: Q13.1 (G), Q37.3 (C), R13.2
unnamed: Q14.1 (G), Q38.3 (C), R14.2
unnamed: Q15.1 (G), Q39.3 (C), R15.2
unnamed: Q16.1 (G), Q40.3 (C), R16.2
unnamed: Q17.1 (G), Q41.3 (C), R17.2
unnamed: Q18.1 (G), Q42.3 (C), R18.2
unnamed: Q19.1 (G), Q43.3 (C), R19.2
unnamed: Q20.1 (G), Q44.3 (C), R20.2
unnamed: Q21.1 (G), Q45.3 (C), R21.2
unnamed: Q22.1 (G), Q46.3 (C), R22.2
unnamed: Q23.1 (G), Q47.3 (C), R23.2
unnamed: Q24.1 (G), Q48.3 (C), R24.2
unnamed: Q25.1 (B), R25.1
unnamed: Q26.1 (B), R26.1
unnamed: Q27.1 (B), R27.1
unnamed: Q3.1 (G), Q27.3 (C), R3.2
unnamed: Q28.1 (B), R28.1
unnamed: Q4.1 (G), Q28.3 (C), R4.2
unnamed: Q29.1 (B), R29.1
unnamed: Q5.1 (G), Q29.3 (C), R5.2
unnamed: Q30.1 (B), R30.1
unnamed: Q6.1 (G), Q30.3 (C), R6.2
unnamed: Q31.1 (B), R31.1
unnamed: Q7.1 (G), Q31.3 (C), R7.2
unnamed: Q32.1 (B), R32.1
unnamed: Q8.1 (G), Q32.3 (C), R8.2
unnamed: Q33.1 (B), R33.1
unnamed: Q9.1 (G), Q33.3 (C), R9.2
unnamed: Q34.1 (B), R34.1
unnamed: Q35.1 (B), R35.1
unnamed: Q36.1 (B), R36.1
unnamed: Q37.1 (B), R37.1
unnamed: Q38.1 (B), R38.1
unnamed: Q39.1 (B), R39.1
unnamed: Q40.1 (B), R40.1
unnamed: Q41.1 (B), R41.1
unnamed: Q42.1 (B), R42.1
unnamed: Q43.1 (B), R43.1
unnamed: Q44.1 (B), R44.1
unnamed: Q45.1 (B), R45.1
unnamed: Q46.1 (B), R46.1
unnamed: Q47.1 (B), R47.1
unnamed: Q48.1 (B), R48.1
PBOT: J4.1, U4.2 (CS1)
PTOP: J3.1, U4.1 (CS0)
R1: R52.2, U1.26 (CS01)
R1c: LED1.1 (RK), LED27.1 (RK), LED53.1 (RK), LED78.1 (RK), LED103.1 (RK), LED128.1 (RK), LED151.1 (RK), LED175.1 (RK), LED197.1 (RK), R52.1
R2: R53.2, U1.29 (CS04)
R2c: LED2.1 (RK), LED28.1 (RK), LED54.1 (RK), LED79.1 (RK), LED104.1 (RK), LED129.1 (RK), LED152.1 (RK), LED176.1 (RK), LED198.1 (RK), R53.1
R3: R54.2, U1.32 (CS07)
R3c: LED3.1 (RK), LED29.1 (RK), LED55.1 (RK), LED80.1 (RK), LED105.1 (RK), LED130.1 (RK), LED153.1 (RK), LED177.1 (RK), LED199.1 (RK), R54.1
R4: R55.2, U1.35 (CS10)
R4c: LED4.1 (RK), LED30.1 (RK), LED56.1 (RK), LED81.1 (RK), LED106.1 (RK), LED131.1 (RK), LED154.1 (RK), LED178.1 (RK), LED200.1 (RK), R55.1
R5: R56.2, U1.39 (CS13)
R5c: LED5.1 (RK), LED31.1 (RK), LED57.1 (RK), LED82.1 (RK), LED107.1 (RK), LED132.1 (RK), LED155.1 (RK), LED179.1 (RK), LED201.1 (RK), R56.1
R6: R57.2, U1.42 (CS16)
R6c: LED6.1 (RK), LED32.1 (RK), LED58.1 (RK), LED83.1 (RK), LED108.1 (RK), LED156.1 (RK), LED202.1 (RK), R57.1
R7: R58.2, U1.45 (CS19)
R7c: LED7.1 (RK), LED33.1 (RK), LED59.1 (RK), LED84.1 (RK), LED109.1 (RK), LED133.1 (RK), LED157.1 (RK), LED180.1 (RK), LED203.1 (RK), R58.1
R8: R59.2, U1.48 (CS22)
R8c: LED8.1 (RK), LED34.1 (RK), LED60.1 (RK), LED85.1 (RK), LED110.1 (RK), LED134.1 (RK), LED158.1 (RK), LED181.1 (RK), LED204.1 (RK), R59.1
R9: R60.2, U1.51 (CS25)
R9c: LED9.1 (RK), LED35.1 (RK), LED61.1 (RK), LED86.1 (RK), LED111.1 (RK), LED135.1 (RK), LED159.1 (RK), LED205.1 (RK), R60.1
R10: R61.2, U1.54 (CS28)
R10c: LED10.1 (RK), LED36.1 (RK), LED62.1 (RK), LED87.1 (RK), LED112.1 (RK), LED136.1 (RK), LED160.1 (RK), LED182.1 (RK), LED206.1 (RK), R61.1
R11: R62.2, U1.58 (CS31)
R11c: LED11.1 (RK), LED37.1 (RK), LED63.1 (RK), LED88.1 (RK), LED113.1 (RK), LED137.1 (RK), LED161.1 (RK), LED183.1 (RK), LED207.1 (RK), R62.1
R12: R63.2, U1.1 (CS34)
R12c: LED12.1 (RK), LED38.1 (RK), LED64.1 (RK), LED89.1 (RK), LED114.1 (RK), LED138.1 (RK), LED162.1 (RK), LED184.1 (RK), LED208.1 (RK), R63.1
R13: R64.2, U1.4 (CS37)
R13c: LED13.1 (RK), LED39.1 (RK), LED65.1 (RK), LED90.1 (RK), LED115.1 (RK), LED139.1 (RK), LED163.1 (RK), LED185.1 (RK), LED209.1 (RK), R64.1
R14: R65.2, U2.26 (CS01)
R14c: LED14.1 (RK), LED40.1 (RK), LED66.1 (RK), LED91.1 (RK), LED116.1 (RK), LED140.1 (RK), LED164.1 (RK), LED186.1 (RK), LED210.1 (RK), R65.1
R15: R66.2, U2.29 (CS04)
R15c: LED15.1 (RK), LED41.1 (RK), LED67.1 (RK), LED92.1 (RK), LED117.1 (RK), LED141.1 (RK), LED165.1 (RK), LED187.1 (RK), LED211.1 (RK), R66.1
R16: R67.2, U2.32 (CS07)
R16c: LED16.1 (RK), LED42.1 (RK), LED68.1 (RK), LED93.1 (RK), LED118.1 (RK), LED142.1 (RK), LED166.1 (RK), LED188.1 (RK), LED212.1 (RK), R67.1
R17: R68.2, U2.35 (CS10)
R17c: LED17.1 (RK), LED43.1 (RK), LED69.1 (RK), LED94.1 (RK), LED119.1 (RK), LED143.1 (RK), LED167.1 (RK), LED189.1 (RK), LED213.1 (RK), R68.1
R18: R69.2, U2.39 (CS13)
R18c: LED18.1 (RK), LED44.1 (RK), LED70.1 (RK), LED95.1 (RK), LED120.1 (RK), LED144.1 (RK), LED168.1 (RK), LED214.1 (RK), R69.1
R19: R70.2, U2.42 (CS16)
R19c: LED19.1 (RK), LED45.1 (RK), LED71.1 (RK), LED96.1 (RK), LED121.1 (RK), LED145.1 (RK), LED169.1 (RK), LED190.1 (RK), LED215.1 (RK), R70.1
R20: R71.2, U2.45 (CS19)
R20c: LED20.1 (RK), LED46.1 (RK), LED72.1 (RK), LED97.1 (RK), LED122.1 (RK), LED146.1 (RK), LED170.1 (RK), LED191.1 (RK), LED216.1 (RK), R71.1
R21: R72.2, U2.48 (CS22)
R21c: LED21.1 (RK), LED47.1 (RK), LED73.1 (RK), LED98.1 (RK), LED123.1 (RK), LED147.1 (RK), LED192.1 (RK), LED217.1 (RK), R72.1
R22: R73.2, U2.51 (CS25)
R22c: LED22.1 (RK), LED48.1 (RK), LED74.1 (RK), LED99.1 (RK), LED124.1 (RK), LED171.1 (RK), LED193.1 (RK), LED218.1 (RK), R73.1
R23: R74.2, U2.54 (CS28)
R23c: LED23.1 (RK), LED49.1 (RK), LED219.1 (RK), R74.1
R24: R75.2, U2.58 (CS31)
R24c: LED24.1 (RK), LED50.1 (RK), LED75.1 (RK), LED100.1 (RK), LED125.1 (RK), LED148.1 (RK), LED172.1 (RK), LED194.1 (RK), LED220.1 (RK), R75.1
R25: R76.2, U2.1 (CS34)
R25c: LED25.1 (RK), LED51.1 (RK), LED76.1 (RK), LED101.1 (RK), LED126.1 (RK), LED149.1 (RK), LED173.1 (RK), LED195.1 (RK), LED221.1 (RK), R76.1
R26: R77.2, U2.4 (CS37)
R26c: LED26.1 (RK), LED52.1 (RK), LED77.1 (RK), LED102.1 (RK), LED127.1 (RK), LED150.1 (RK), LED174.1 (RK), LED196.1 (RK), LED222.1 (RK), R77.1
ROW1: J1.24, SW1.2 (OUT), SW2.2 (OUT), SW3.2 (OUT), SW4.2 (OUT), SW5.2 (OUT), SW6.2 (OUT), SW7.2 (OUT), SW8.2 (OUT), SW9.2 (OUT), SW10.2 (OUT), SW11.2 (OUT), SW12.2 (OUT), SW13.2 (OUT), SW14.2 (OUT), SW15.2 (OUT), SW16.2 (OUT), SW17.2 (OUT), SW18.2 (OUT), SW19.2 (OUT), SW20.2 (OUT), SW21.2 (OUT), SW22.2 (OUT), SW23.2 (OUT), SW24.2 (OUT)
ROW2: J1.23, SW25.2 (OUT), SW26.2 (OUT), SW27.2 (OUT), SW28.2 (OUT), SW29.2 (OUT), SW30.2 (OUT), SW31.2 (OUT), SW32.2 (OUT), SW33.2 (OUT), SW34.2 (OUT), SW35.2 (OUT), SW36.2 (OUT), SW37.2 (OUT), SW38.2 (OUT), SW39.2 (OUT), SW40.2 (OUT), SW41.2 (OUT), SW42.2 (OUT), SW43.2 (OUT), SW44.2 (OUT), SW45.2 (OUT), SW46.2 (OUT), SW47.2 (OUT), SW48.2 (OUT)
ROW3: J1.22, SW49.2 (OUT), SW50.2 (OUT), SW51.2 (OUT), SW52.2 (OUT), SW53.2 (OUT), SW54.2 (OUT), SW55.2 (OUT), SW56.2 (OUT), SW57.2 (OUT), SW58.2 (OUT), SW59.2 (OUT), SW60.2 (OUT), SW61.2 (OUT), SW62.2 (OUT), SW63.2 (OUT), SW64.2 (OUT), SW65.2 (OUT), SW66.2 (OUT), SW67.2 (OUT), SW68.2 (OUT), SW69.2 (OUT), SW70.2 (OUT), SW71.2 (OUT)
ROW4: J1.21, SW72.2 (OUT), SW73.2 (OUT), SW74.2 (OUT), SW75.2 (OUT), SW76.2 (OUT), SW77.2 (OUT), SW78.2 (OUT), SW79.2 (OUT), SW80.2 (OUT), SW81.2 (OUT), SW82.2 (OUT), SW83.2 (OUT), SW84.2 (OUT), SW85.2 (OUT), SW86.2 (OUT), SW87.2 (OUT), SW88.2 (OUT), SW89.2 (OUT), SW90.2 (OUT), SW91.2 (OUT), SW92.2 (OUT), SW93.2 (OUT), SW94.2 (OUT)
ROW5: J1.20, SW95.2 (OUT), SW96.2 (OUT), SW97.2 (OUT), SW98.2 (OUT), SW99.2 (OUT), SW100.2 (OUT), SW101.2 (OUT), SW102.2 (OUT), SW103.2 (OUT), SW104.2 (OUT), SW105.2 (OUT), SW106.2 (OUT), SW107.2 (OUT), SW108.2 (OUT), SW109.2 (OUT), SW110.2 (OUT), SW111.2 (OUT), SW112.2 (OUT), SW113.2 (OUT), SW114.2 (OUT), SW115.2 (OUT), SW116.2 (OUT), SW117.2 (OUT)
ROW6: J1.19, SW118.2 (OUT), SW119.2 (OUT), SW120.2 (OUT), SW121.2 (OUT), SW122.2 (OUT), SW123.2 (OUT), SW124.2 (OUT), SW125.2 (OUT), SW126.2 (OUT), SW127.2 (OUT), SW128.2 (OUT), SW129.2 (OUT), SW130.2 (OUT), SW131.2 (OUT), SW132.2 (OUT), SW133.2 (OUT), SW134.2 (OUT), SW135.2 (OUT), SW136.2 (OUT), SW137.2 (OUT), SW138.2 (OUT)
ROW7: J1.18, SW139.2 (OUT), SW140.2 (OUT), SW141.2 (OUT), SW142.2 (OUT), SW143.2 (OUT), SW144.2 (OUT), SW145.2 (OUT), SW146.2 (OUT), SW147.2 (OUT), SW148.2 (OUT), SW149.2 (OUT), SW150.2 (OUT), SW151.2 (OUT), SW152.2 (OUT), SW153.2 (OUT), SW154.2 (OUT), SW155.2 (OUT), SW156.2 (OUT), SW157.2 (OUT), SW158.2 (OUT), SW159.2 (OUT), SW160.2 (OUT)
ROW8: J1.17, SW161.2 (OUT), SW162.2 (OUT), SW163.2 (OUT), SW164.2 (OUT), SW165.2 (OUT), SW166.2 (OUT), SW167.2 (OUT), SW168.2 (OUT), SW169.2 (OUT), SW170.2 (OUT), SW171.2 (OUT), SW172.2 (OUT), SW173.2 (OUT), SW174.2 (OUT), SW175.2 (OUT), SW176.2 (OUT)
SCL: J1.35, J2.4 (SCL), TP3.1, U1.10 (SCL), U2.10 (SCL), U3.8 (SCL), U4.22 (SCL), U5.1 (SCL)
SDA: J1.34, J2.3 (SDA), TP4.1, U1.9 (SDA), U2.9 (SDA), U3.7 (SDA), U4.21 (SDA), U5.3 (SDA)
SHIELD: J5.1, J5.17, U4.20 (CS4)
SLDL1: J5.16, U4.13 (SLD14)
SLDL2: J5.15, U4.12 (SLD13)
SLDL3: J5.14, U4.11 (SLD12)
SLDL4: J5.13, U4.10 (SLD11)
SLDL5: J5.12, U4.9 (SLD10)
SLDR1: J5.2, U4.14 (CS11)
SLDR2: J5.3, U4.15 (CS12)
SLDR3: J5.4, U4.16 (CS13)
SLDR4: J5.5, U4.17 (CS14)
SLDR5: J5.6, U4.18 (CS15)
SW1_L: LED1.4 (A), LED2.4 (A), LED3.4 (A), LED4.4 (A), LED5.4 (A), LED6.4 (A), LED7.4 (A), LED8.4 (A), LED9.4 (A), LED10.4 (A), LED11.4 (A), LED12.4 (A), LED13.4 (A), U1.16 (SW1)
SW1_R: LED14.4 (A), LED15.4 (A), LED16.4 (A), LED17.4 (A), LED18.4 (A), LED19.4 (A), LED20.4 (A), LED21.4 (A), LED22.4 (A), LED23.4 (A), LED24.4 (A), LED25.4 (A), LED26.4 (A), U2.16 (SW1)
SW2_L: LED27.4 (A), LED28.4 (A), LED29.4 (A), LED30.4 (A), LED31.4 (A), LED32.4 (A), LED33.4 (A), LED34.4 (A), LED35.4 (A), LED36.4 (A), LED37.4 (A), LED38.4 (A), LED39.4 (A), U1.17 (SW2)
SW2_R: LED40.4 (A), LED41.4 (A), LED42.4 (A), LED43.4 (A), LED44.4 (A), LED45.4 (A), LED46.4 (A), LED47.4 (A), LED48.4 (A), LED49.4 (A), LED50.4 (A), LED51.4 (A), LED52.4 (A), U2.17 (SW2)
SW3_L: LED53.4 (A), LED54.4 (A), LED55.4 (A), LED56.4 (A), LED57.4 (A), LED58.4 (A), LED59.4 (A), LED60.4 (A), LED61.4 (A), LED62.4 (A), LED63.4 (A), LED64.4 (A), LED65.4 (A), U1.18 (SW3)
SW3_R: LED66.4 (A), LED67.4 (A), LED68.4 (A), LED69.4 (A), LED70.4 (A), LED71.4 (A), LED72.4 (A), LED73.4 (A), LED74.4 (A), LED75.4 (A), LED76.4 (A), LED77.4 (A), U2.18 (SW3)
SW4_L: LED78.4 (A), LED79.4 (A), LED80.4 (A), LED81.4 (A), LED82.4 (A), LED83.4 (A), LED84.4 (A), LED85.4 (A), LED86.4 (A), LED87.4 (A), LED88.4 (A), LED89.4 (A), LED90.4 (A), U1.19 (SW4)
SW4_R: LED91.4 (A), LED92.4 (A), LED93.4 (A), LED94.4 (A), LED95.4 (A), LED96.4 (A), LED97.4 (A), LED98.4 (A), LED99.4 (A), LED100.4 (A), LED101.4 (A), LED102.4 (A), U2.19 (SW4)
SW5_L: LED103.4 (A), LED104.4 (A), LED105.4 (A), LED106.4 (A), LED107.4 (A), LED108.4 (A), LED109.4 (A), LED110.4 (A), LED111.4 (A), LED112.4 (A), LED113.4 (A), LED114.4 (A), LED115.4 (A), U1.20 (SW5)
SW5_R: LED116.4 (A), LED117.4 (A), LED118.4 (A), LED119.4 (A), LED120.4 (A), LED121.4 (A), LED122.4 (A), LED123.4 (A), LED124.4 (A), LED125.4 (A), LED126.4 (A), LED127.4 (A), U2.20 (SW5)
SW6_L: LED128.4 (A), LED129.4 (A), LED130.4 (A), LED131.4 (A), LED132.4 (A), LED133.4 (A), LED134.4 (A), LED135.4 (A), LED136.4 (A), LED137.4 (A), LED138.4 (A), LED139.4 (A), U1.21 (SW6)
SW6_R: LED140.4 (A), LED141.4 (A), LED142.4 (A), LED143.4 (A), LED144.4 (A), LED145.4 (A), LED146.4 (A), LED147.4 (A), LED148.4 (A), LED149.4 (A), LED150.4 (A), U2.21 (SW6)
SW7_L: LED151.4 (A), LED152.4 (A), LED153.4 (A), LED154.4 (A), LED155.4 (A), LED156.4 (A), LED157.4 (A), LED158.4 (A), LED159.4 (A), LED160.4 (A), LED161.4 (A), LED162.4 (A), LED163.4 (A), U1.22 (SW7)
SW7_R: LED164.4 (A), LED165.4 (A), LED166.4 (A), LED167.4 (A), LED168.4 (A), LED169.4 (A), LED170.4 (A), LED171.4 (A), LED172.4 (A), LED173.4 (A), LED174.4 (A), U2.22 (SW7)
SW8_L: LED175.4 (A), LED176.4 (A), LED177.4 (A), LED178.4 (A), LED179.4 (A), LED180.4 (A), LED181.4 (A), LED182.4 (A), LED183.4 (A), LED184.4 (A), LED185.4 (A), U1.23 (SW8)
SW8_R: LED186.4 (A), LED187.4 (A), LED188.4 (A), LED189.4 (A), LED190.4 (A), LED191.4 (A), LED192.4 (A), LED193.4 (A), LED194.4 (A), LED195.4 (A), LED196.4 (A), U2.23 (SW8)
SW9_L: LED197.4 (A), LED198.4 (A), LED199.4 (A), LED200.4 (A), LED201.4 (A), LED202.4 (A), LED203.4 (A), LED204.4 (A), LED205.4 (A), LED206.4 (A), LED207.4 (A), LED208.4 (A), LED209.4 (A), U1.24 (SW9)
SW9_R: LED210.4 (A), LED211.4 (A), LED212.4 (A), LED213.4 (A), LED214.4 (A), LED215.4 (A), LED216.4 (A), LED217.4 (A), LED218.4 (A), LED219.4 (A), LED220.4 (A), LED221.4 (A), LED222.4 (A), U2.24 (SW9)
TOPL: J5.7, U4.3 (CS2)
TOPR: J5.11, U4.4 (CS3)
WP: JP1.1 (A), R51.2, TP5.1, U5.5 (WP)

Notes on the sheet:
2.25u
6.25u
