12voltman/SimulType/(commit log)

2024-02-02 Create SimulTypeUltrasmall
    A stupidly large layout that maxes out LEDs and column lines
2024-07-02 Added PCB files from PC
    Forgot I never uploaded these. Whoops.
    [SimulTypeHeaderUltra.kicad_pcb, SimulTypeHeaderUltra.kicad_sch, SimulTypeUltra.kicad_sch, SimulTypeUltraFullMag.kicad_sch, SimulTypeUltraSemiMag.kicad_sch, Simultypespaceflex.kicad_pcb, Simultypespaceflex.kicad_sch, simultypecontrol.kicad_pcb]
2024-07-02 Organization rework
    [SimulTypeUltra.kicad_sch, SimulTypeUltraFullMag.kicad_sch, SimulTypeUltraSemiMag.kicad_sch]
2024-07-02 Minor graphics cleanup
    [simultypeprog.kicad_pcb, simultypeprog.kicad_sch]
2024-07-02 Added 3d models
    [simultypecontrol.kicad_pcb, simultypecontrol.kicad_sch]
